John-High-Sierra/sprinkler.board/docs/superpowers/plans/2026-06-03-remote-access.md

# Remote Access Implementation Plan

> **For agentic workers:** REQUIRED SUB-SKILL: Use superpowers:subagent-driven-development (recommended) or superpowers:executing-plans to implement this plan task-by-task. Steps use checkbox (`- [ ]`) syntax for tracking.

**Goal:** Add Tailscale remote access (no firmware changes), PWA installability, and Telegram bot notifications + basic commands to the SprinKlr-8 ESP32 controller.

**Architecture:** PWA adds a manifest + service worker + icons to the existing web UI; the firmware gains 4 static-file routes to serve them. Telegram adds a `telegramTask` FreeRTOS task that long-polls the Telegram Bot API and a fire-and-forget `telegramNotify()` wrapper used by run tasks. Config is stored alongside existing fields in `config.json`.

**Tech Stack:** ESP32 Arduino / FreeRTOS, WebServer.h, WiFiClientSecure, HTTPClient, ArduinoJson v6, LittleFS, Telegram Bot API (HTTPS), Python + Pillow for icon generation

---

## File Map

| File | Change |
|---|---|
| `tools/gen_icons.py` | **Create** — generates icon-192.png + icon-512.png |
| `data/manifest.json` | **Create** — PWA manifest |
| `data/sw.js` | **Create** — minimal service worker |
| `data/icon-192.png` | **Create** — generated by script |
| `data/icon-512.png` | **Create** — generated by script |
| `data/index.html` | **Modify** — PWA tags, Telegram settings section, loadTelegram() |
| `sprinkler_controller.ino` | **Modify** — PWA routes, Telegram config, task, notifications |
| `html_content.h` | **Regenerate** — after each index.html change |
| `docs/tailscale-setup.md` | **Create** — step-by-step Tailscale guide |

---

## Task 1: Generate PWA Icons

**Files:**
- Create: `tools/gen_icons.py`
- Output: `esp32_firmware/sprinkler_controller/data/icon-192.png`
- Output: `esp32_firmware/sprinkler_controller/data/icon-512.png`

- [ ] **Step 1: Create tools/gen_icons.py**

```python
#!/usr/bin/env python3
"""Generate PWA icons for SprinKlr-8. Run from repo root: python tools/gen_icons.py"""
try:
    from PIL import Image, ImageDraw
except ImportError:
    print("Run: pip install Pillow")
    raise SystemExit(1)

import math, os

OUT_DIR = os.path.join("esp32_firmware", "sprinkler_controller", "data")
TEAL    = (13, 148, 136, 255)   # #0d9488
WHITE   = (255, 255, 255, 255)

def teardrop(cx, cy, rx, ry):
    """Polygon points: teardrop with tip at top, round base at bottom."""
    pts = []
    for i in range(31):                              # bottom arc, left to right
        a = math.pi + math.pi * i / 30
        pts.append((cx + rx * math.cos(a),
                    cy + ry * 0.3 + ry * 0.7 * math.sin(a)))
    pts.append((cx, cy - ry * 0.7))                 # tip
    return pts

def make_icon(size):
    img  = Image.new("RGBA", (size, size), (0, 0, 0, 0))
    draw = ImageDraw.Draw(img)
    m    = max(1, size // 12)
    draw.ellipse([m, m, size - m, size - m], fill=TEAL)
    draw.polygon(teardrop(size / 2, size * 0.54,
                          size * 0.22, size * 0.30), fill=WHITE)
    return img

os.makedirs(OUT_DIR, exist_ok=True)
for sz in (192, 512):
    path = os.path.join(OUT_DIR, f"icon-{sz}.png")
    make_icon(sz).save(path, "PNG")
    print(f"  Wrote {path}")
print("Done.")
```

- [ ] **Step 2: Run the script from repo root**

```powershell
pip install Pillow
python tools/gen_icons.py
```

Expected output:
```
  Wrote esp32_firmware\sprinkler_controller\data\icon-192.png
  Wrote esp32_firmware\sprinkler_controller\data\icon-512.png
Done.
```

- [ ] **Step 3: Verify both files exist**

```powershell
dir esp32_firmware\sprinkler_controller\data\icon-*.png
```

Expected: two files, each a few KB.

- [ ] **Step 4: Commit**

```powershell
git add tools/gen_icons.py esp32_firmware/sprinkler_controller/data/icon-192.png esp32_firmware/sprinkler_controller/data/icon-512.png
git commit -m "Add PWA icon generator script and generated icons"
```

---

## Task 2: Create PWA Manifest and Service Worker

**Files:**
- Create: `esp32_firmware/sprinkler_controller/data/manifest.json`
- Create: `esp32_firmware/sprinkler_controller/data/sw.js`

- [ ] **Step 1: Create data/manifest.json**

```json
{
  "name": "SprinKlr-8",
  "short_name": "SprinKlr",
  "start_url": "/",
  "display": "standalone",
  "background_color": "#0f1923",
  "theme_color": "#0d9488",
  "icons": [
    { "src": "/icon-192.png", "sizes": "192x192", "type": "image/png" },
    { "src": "/icon-512.png", "sizes": "512x512", "type": "image/png" }
  ]
}
```

- [ ] **Step 2: Create data/sw.js**

```javascript
self.addEventListener('install', () => self.skipWaiting());
self.addEventListener('activate', e => e.waitUntil(clients.claim()));
self.addEventListener('fetch', e => {
  if (e.request.mode === 'navigate') {
    e.respondWith(
      fetch(e.request).catch(() => new Response(
        '<!DOCTYPE html><html><body style="font-family:sans-serif;background:#0f1923;color:#e2e8f0;display:flex;align-items:center;justify-content:center;min-height:100vh;margin:0"><div style="text-align:center;padding:24px"><div style="font-size:3rem;margin-bottom:16px">💧</div><h2 style="color:#0d9488;margin-bottom:8px">Board Unreachable</h2><p style="color:#607080;margin-bottom:20px">Connect via Tailscale or your home network.</p><button onclick="location.reload()" style="padding:12px 24px;background:#0d9488;color:#fff;border:none;border-radius:8px;cursor:pointer;font-size:1rem">Retry</button></div></body></html>',
        { headers: { 'Content-Type': 'text/html' } }
      ))
    );
  }
});
```

- [ ] **Step 3: Commit**

```powershell
git add esp32_firmware/sprinkler_controller/data/manifest.json esp32_firmware/sprinkler_controller/data/sw.js
git commit -m "Add PWA manifest and service worker"
```

---

## Task 3: Add PWA Tags to index.html + Firmware Routes

**Files:**
- Modify: `esp32_firmware/sprinkler_controller/data/index.html`
- Modify: `esp32_firmware/sprinkler_controller/sprinkler_controller.ino`
- Regenerate: `esp32_firmware/sprinkler_controller/html_content.h`

- [ ] **Step 1: Add PWA meta tags to index.html `<head>`**

In `data/index.html`, find this line (line 6):
```html
<title>SprinKlr-8</title>
```

Replace with:
```html
<title>SprinKlr-8</title>
<link rel="manifest" href="/manifest.json">
<meta name="theme-color" content="#0d9488">
<meta name="apple-mobile-web-app-capable" content="yes">
<meta name="apple-mobile-web-app-status-bar-style" content="black-translucent">
<meta name="apple-mobile-web-app-title" content="SprinKlr">
<link rel="apple-touch-icon" href="/icon-192.png">
```

- [ ] **Step 2: Add service worker registration before `</body>`**

Find `</body>` at the very end of `data/index.html` and replace it with:
```html
<script>if('serviceWorker'in navigator)navigator.serviceWorker.register('/sw.js');</script>
</body>
```

- [ ] **Step 3: Add 4 static-file routes in sprinkler_controller.ino**

Find this block in `setupRoutes()` (just before the 404 handler at line ~1168):
```cpp
  // ── 404 handler ───────────────────────────────────────────────
  server.onNotFound([]() {
    server.send(404, "application/json", "{\"error\":\"Not found\"}");
  });
```

Insert the 4 routes immediately before the `// ── 404 handler` comment:
```cpp
  // ── PWA static files ──────────────────────────────────────────
  server.on("/manifest.json", HTTP_GET, []() { serveFile("/manifest.json", "application/manifest+json"); });
  server.on("/sw.js",         HTTP_GET, []() { serveFile("/sw.js",         "application/javascript"); });
  server.on("/icon-192.png",  HTTP_GET, []() { serveFile("/icon-192.png",  "image/png"); });
  server.on("/icon-512.png",  HTTP_GET, []() { serveFile("/icon-512.png",  "image/png"); });

```

- [ ] **Step 4: Regenerate html_content.h**

Run from repo root:
```powershell
python -c "
with open('esp32_firmware/sprinkler_controller/data/index.html', 'r', encoding='utf-8') as f:
    content = f.read()
out = '// Auto-generated — do not edit. Rebuild from data/index.html\n'
out += 'static const char INDEX_HTML[] PROGMEM = R\"====(\n'
out += content
out += '\n)====\" ;\n'.replace(' ', '')
with open('esp32_firmware/sprinkler_controller/html_content.h', 'w', encoding='utf-8') as f:
    f.write(out)
print('Done')
"
```

- [ ] **Step 5: Compile in Arduino IDE — verify no errors**

Board: ESP32 Dev Module, Partition: Minimal SPIFFS (1.9MB APP with OTA/190KB SPIFFS)

- [ ] **Step 6: Flash firmware + LittleFS**

Flash firmware via Arduino IDE OTA or USB.

Build and flash LittleFS (run from repo root):
```powershell
C:\Users\harri\AppData\Local\Arduino15\packages\esp32\tools\mklittlefs\4.0.2-db0513a\mklittlefs.exe -c "esp32_firmware\sprinkler_controller\data" -s 1507328 -b 4096 -p 256 "docs\littlefs.bin"
```
Then upload `docs/littlefs.bin` via `http://sprinkler.local/` using the web flash tool at https://john-high-sierra.github.io/sprinkler.board/

- [ ] **Step 7: Test PWA install**

- Open `http://10.110.201.40` in Chrome on Android → tap ⋮ → "Add to Home screen"
- Open `http://10.110.201.40` in Safari on iOS → tap Share → "Add to Home Screen"
- Verify: icon appears on homescreen, opens full-screen with teal status bar, no browser chrome

- [ ] **Step 8: Commit**

```powershell
git add esp32_firmware/sprinkler_controller/data/index.html esp32_firmware/sprinkler_controller/sprinkler_controller.ino esp32_firmware/sprinkler_controller/html_content.h
git commit -m "PWA: manifest, service worker, meta tags, firmware routes"
```

---

## Task 4: Add Telegram Config to BoardConfig and Persistence

**Files:**
- Modify: `esp32_firmware/sprinkler_controller/sprinkler_controller.ino`

- [ ] **Step 1: Add 3 fields to BoardConfig struct**

Find the `BoardConfig` struct (lines 142-153). Replace:
```cpp
  char zoneNames[8][32];     // user-defined zone names
};
```
With:
```cpp
  char zoneNames[8][32];     // user-defined zone names
  bool telegramEnabled;
  char telegramToken[128];   // bot token from @BotFather
  char telegramChatId[32];   // authorized chat ID — all others ignored
};
```

- [ ] **Step 2: Add defaults in loadConfig()**

Find these lines in `loadConfig()` (after `strlcpy(boardConfig.tempUnit, "C"...)` and before `if (!LittleFS.exists...)`):
```cpp
  for (int i = 0; i < 8; i++) {
    snprintf(boardConfig.zoneNames[i], sizeof(boardConfig.zoneNames[i]), "Zone %d", i + 1);
  }
```

Replace with:
```cpp
  for (int i = 0; i < 8; i++) {
    snprintf(boardConfig.zoneNames[i], sizeof(boardConfig.zoneNames[i]), "Zone %d", i + 1);
  }
  boardConfig.telegramEnabled = false;
  memset(boardConfig.telegramToken,  0, sizeof(boardConfig.telegramToken));
  memset(boardConfig.telegramChatId, 0, sizeof(boardConfig.telegramChatId));
```

- [ ] **Step 3: Bump DynamicJsonDocument size in loadConfig() from 1024 to 2048**

Find in `loadConfig()`:
```cpp
  DynamicJsonDocument doc(1024);
```
Replace with:
```cpp
  DynamicJsonDocument doc(2048);
```

- [ ] **Step 4: Add JSON read for Telegram fields in loadConfig()**

Find these lines near the end of `loadConfig()`:
```cpp
  if (doc.containsKey("zone_names")) {
    JsonArray zn = doc["zone_names"].as<JsonArray>();
    for (int i = 0; i < 8 && i < (int)zn.size(); i++) {
      const char* n = zn[i];
      if (n) strlcpy(boardConfig.zoneNames[i], n, sizeof(boardConfig.zoneNames[i]));
    }
  }
  Serial.printf("[CFG] Timezone: %s  Lat: %.4f  Lon: %.4f  WeatherSkip: %s\n",
```

Replace with:
```cpp
  if (doc.containsKey("zone_names")) {
    JsonArray zn = doc["zone_names"].as<JsonArray>();
    for (int i = 0; i < 8 && i < (int)zn.size(); i++) {
      const char* n = zn[i];
      if (n) strlcpy(boardConfig.zoneNames[i], n, sizeof(boardConfig.zoneNames[i]));
    }
  }
  boardConfig.telegramEnabled = doc["telegram_enabled"] | false;
  { const char* v = doc["telegram_token"]  | ""; strlcpy(boardConfig.telegramToken,  v, sizeof(boardConfig.telegramToken)); }
  { const char* v = doc["telegram_chat_id"]| ""; strlcpy(boardConfig.telegramChatId, v, sizeof(boardConfig.telegramChatId)); }
  Serial.printf("[CFG] Timezone: %s  Lat: %.4f  Lon: %.4f  WeatherSkip: %s\n",
```

- [ ] **Step 5: Bump DynamicJsonDocument in saveConfig() from 1024 to 2048 and add fields**

Find in `saveConfig()`:
```cpp
  DynamicJsonDocument doc(1024);
  doc["timezone"]             = boardConfig.timezone;
```
Replace with:
```cpp
  DynamicJsonDocument doc(2048);
  doc["timezone"]             = boardConfig.timezone;
```

Find the end of `saveConfig()`:
```cpp
  JsonArray zn = doc.createNestedArray("zone_names");
  for (int i = 0; i < 8; i++) zn.add(boardConfig.zoneNames[i]);
  File f = LittleFS.open(CONFIG_FILE, "w");
```
Replace with:
```cpp
  JsonArray zn = doc.createNestedArray("zone_names");
  for (int i = 0; i < 8; i++) zn.add(boardConfig.zoneNames[i]);
  doc["telegram_enabled"]  = boardConfig.telegramEnabled;
  doc["telegram_token"]    = boardConfig.telegramToken;
  doc["telegram_chat_id"]  = boardConfig.telegramChatId;
  File f = LittleFS.open(CONFIG_FILE, "w");
```

- [ ] **Step 6: Bump DynamicJsonDocument in GET /api/config from 1024 to 2048 and add fields**

Find in `GET /api/config` handler:
```cpp
    DynamicJsonDocument doc(1024);
    doc["timezone"]               = boardConfig.timezone;
```
Replace with:
```cpp
    DynamicJsonDocument doc(2048);
    doc["timezone"]               = boardConfig.timezone;
```

Find the end of the GET /api/config response building:
```cpp
    { JsonArray zn = doc.createNestedArray("zone_names"); for (int i = 0; i < 8; i++) zn.add(boardConfig.zoneNames[i]); }
    String out; serializeJson(doc, out);
    server.send(200, "application/json", out);
```
Replace with:
```cpp
    { JsonArray zn = doc.createNestedArray("zone_names"); for (int i = 0; i < 8; i++) zn.add(boardConfig.zoneNames[i]); }
    doc["telegram_enabled"]  = boardConfig.telegramEnabled;
    doc["telegram_token"]    = boardConfig.telegramToken;
    doc["telegram_chat_id"]  = boardConfig.telegramChatId;
    String out; serializeJson(doc, out);
    server.send(200, "application/json", out);
```

- [ ] **Step 7: Bump DynamicJsonDocument in POST /api/config from 1024 to 2048 and add handlers**

Find in `POST /api/config` handler:
```cpp
    DynamicJsonDocument doc(1024);
    if (deserializeJson(doc, server.arg("plain")) != DeserializationError::Ok) {
```
Replace with:
```cpp
    DynamicJsonDocument doc(2048);
    if (deserializeJson(doc, server.arg("plain")) != DeserializationError::Ok) {
```

Find the end of POST /api/config field handlers (just before the `locationChanged` line):
```cpp
    if (doc.containsKey("zone_names")) {
      JsonArray zn = doc["zone_names"].as<JsonArray>();
      for (int i = 0; i < 8 && i < (int)zn.size(); i++) {
        const char* n = zn[i].as<const char*>();
        if (n) strlcpy(boardConfig.zoneNames[i], n, sizeof(boardConfig.zoneNames[i]));
      }
    }
    // Notify weatherTask to refetch immediately when location or skip toggle changes
```
Replace with:
```cpp
    if (doc.containsKey("zone_names")) {
      JsonArray zn = doc["zone_names"].as<JsonArray>();
      for (int i = 0; i < 8 && i < (int)zn.size(); i++) {
        const char* n = zn[i].as<const char*>();
        if (n) strlcpy(boardConfig.zoneNames[i], n, sizeof(boardConfig.zoneNames[i]));
      }
    }
    if (doc.containsKey("telegram_enabled")) boardConfig.telegramEnabled = doc["telegram_enabled"].as<bool>();
    if (doc.containsKey("telegram_token")) {
      const char* v = doc["telegram_token"].as<const char*>();
      if (v) strlcpy(boardConfig.telegramToken, v, sizeof(boardConfig.telegramToken));
    }
    if (doc.containsKey("telegram_chat_id")) {
      const char* v = doc["telegram_chat_id"].as<const char*>();
      if (v) strlcpy(boardConfig.telegramChatId, v, sizeof(boardConfig.telegramChatId));
    }
    // Notify weatherTask to refetch immediately when location or skip toggle changes
```

- [ ] **Step 8: Compile in Arduino IDE — verify no errors**

- [ ] **Step 9: Commit**

```powershell
git add esp32_firmware/sprinkler_controller/sprinkler_controller.ino
git commit -m "Add Telegram config fields to BoardConfig, loadConfig, saveConfig, API endpoints"
```

---

## Task 5: Add telegramSend(), telegramNotify(), Notifications, and Test Route

**Files:**
- Modify: `esp32_firmware/sprinkler_controller/sprinkler_controller.ino`

- [ ] **Step 1: Add global skipNextScheduledRun flag and telegramTaskHandle**

Find this line near the top of the globals section (near `stopRequested`):
```cpp
volatile bool     stopRequested = false;
```
Replace with:
```cpp
volatile bool     stopRequested = false;
volatile bool     skipNextScheduledRun = false;
TaskHandle_t      telegramTaskHandle = NULL;
```

- [ ] **Step 2: Add telegramSend(), telegramNotifyTask(), and telegramNotify() functions**

Add these three functions immediately after the `serveFile()` helper (after line ~875, before `setupRoutes()`):

```cpp
// ═══════════════════════════════════════════════════════════════
//  TELEGRAM NOTIFICATIONS
// ═══════════════════════════════════════════════════════════════
void telegramSend(const char* text) {
  if (strlen(boardConfig.telegramToken) == 0 || strlen(boardConfig.telegramChatId) == 0) return;
  WiFiClientSecure client;
  client.setInsecure();
  HTTPClient https;
  char url[196];
  snprintf(url, sizeof(url), "https://api.telegram.org/bot%s/sendMessage",
    boardConfig.telegramToken);
  if (!https.begin(client, url)) return;
  https.addHeader("Content-Type", "application/json");
  DynamicJsonDocument body(512);
  body["chat_id"] = boardConfig.telegramChatId;
  body["text"]    = text;
  String bodyStr;
  serializeJson(body, bodyStr);
  https.POST(bodyStr);
  https.end();
}

// One-shot task wrapper — lets run tasks notify without blocking
void telegramNotifyTask(void* param) {
  char* msg = (char*)param;
  telegramSend(msg);
  free(msg);
  vTaskDelete(NULL);
}

void telegramNotify(const char* msg) {
  if (!boardConfig.telegramEnabled || strlen(boardConfig.telegramToken) == 0) return;
  char* buf = (char*)malloc(strlen(msg) + 1);
  if (!buf) return;
  strcpy(buf, msg);
  if (xTaskCreate(telegramNotifyTask, "tg_ntfy", 8192, buf, 1, NULL) != pdPASS) {
    free(buf);
  }
}
```

- [ ] **Step 3: Wire run-started notification into runSequenceTask()**

In `runSequenceTask()`, find:
```cpp
  stopRequested = false;
  int actualSecs[NUM_ZONES] = {0};
```
Replace with:
```cpp
  stopRequested = false;
  int actualSecs[NUM_ZONES] = {0};
  {
    int totalMin = 0, zoneCount = 0;
    xSemaphoreTake(scheduleMutex, portMAX_DELAY);
    for (int z = 0; z < NUM_ZONES; z++) {
      if (schedule.days[dayIndex].durations[z] > 0) {
        totalMin += schedule.days[dayIndex].durations[z];
        zoneCount++;
      }
    }
    xSemaphoreGive(scheduleMutex);
    char buf[128];
    snprintf(buf, sizeof(buf), "\xF0\x9F\x92\xA7 %s run started \xe2\x80\x94 %d zone%s, ~%d min",
      manual ? "Manual" : "Scheduled", zoneCount, zoneCount == 1 ? "" : "s", totalMin);
    telegramNotify(buf);
  }
```

- [ ] **Step 4: Wire run-complete notification into runSequenceTask()**

In `runSequenceTask()`, find:
```cpp
    appendRunLog(ts, manual ? "manual" : "schedule", logZ, logS, logCount, nullptr);
  }
  vTaskDelete(NULL);
```
Replace with:
```cpp
    appendRunLog(ts, manual ? "manual" : "schedule", logZ, logS, logCount, nullptr);
    {
      char buf[384];
      int pos = snprintf(buf, sizeof(buf), "\xe2\x9c\x85 Run complete");
      int totalSec = 0;
      for (int i = 0; i < logCount; i++) {
        pos += snprintf(buf + pos, sizeof(buf) - pos, "\n%s \xe2\x80\x94 %dm",
          boardConfig.zoneNames[logZ[i]], logS[i] / 60);
        totalSec += logS[i];
      }
      snprintf(buf + pos, sizeof(buf) - pos, "\nTotal: %dm", totalSec / 60);
      telegramNotify(buf);
    }
  }
  vTaskDelete(NULL);
```

- [ ] **Step 5: Wire run-started and run-complete notifications into runSingleZoneTask()**

In `runSingleZoneTask()`, find:
```cpp
  stopRequested = false;
  int actualSec = 0;
```
Replace with:
```cpp
  stopRequested = false;
  int actualSec = 0;
  {
    char buf[96];
    snprintf(buf, sizeof(buf), "\xF0\x9F\x92\xA7 Manual run started \xe2\x80\x94 %s, %d min",
      boardConfig.zoneNames[z], dur);
    telegramNotify(buf);
  }
```

In `runSingleZoneTask()`, find:
```cpp
  if (actualSec > 0) {
    time_t ts = time(nullptr);
    int logZ[1] = {z}, logS[1] = {actualSec};
    appendRunLog(ts, "manual", logZ, logS, 1, nullptr);
  }
  vTaskDelete(NULL);
```
Replace with:
```cpp
  if (actualSec > 0) {
    time_t ts = time(nullptr);
    int logZ[1] = {z}, logS[1] = {actualSec};
    appendRunLog(ts, "manual", logZ, logS, 1, nullptr);
    char buf[96];
    snprintf(buf, sizeof(buf), "\xe2\x9c\x85 Manual run complete \xe2\x80\x94 %s, %dm",
      boardConfig.zoneNames[z], actualSec / 60);
    telegramNotify(buf);
  }
  vTaskDelete(NULL);
```

- [ ] **Step 6: Wire skip notification into scheduleCheckerTask()**

In `scheduleCheckerTask()`, find:
```cpp
        appendRunLog(now, "schedule", nullptr, nullptr, 0, skipReason);
      } else {
```
Replace with:
```cpp
        appendRunLog(now, "schedule", nullptr, nullptr, 0, skipReason);
        {
          char buf[128];
          snprintf(buf, sizeof(buf), "\xe2\x8f\xad Run skipped \xe2\x80\x94 %s", skipReason);
          telegramNotify(buf);
        }
      } else {
```

- [ ] **Step 7: Add POST /api/telegram_test route**

In `setupRoutes()`, add this route with the PWA routes (after icon-512 route, before the 404 handler):

```cpp
  // ── POST /api/telegram_test ───────────────────────────────────
  server.on("/api/telegram_test", HTTP_POST, []() {
    if (!boardConfig.telegramEnabled || strlen(boardConfig.telegramToken) == 0) {
      server.send(400, "application/json", "{\"error\":\"Telegram not configured\"}");
      return;
    }
    telegramSend("SprinKlr connected \xe2\x9c\x85 \xe2\x80\x94 Telegram notifications are working.");
    server.send(200, "application/json", "{\"message\":\"Test message sent\"}");
  });
```

- [ ] **Step 8: Compile — verify no errors**

- [ ] **Step 9: Commit**

```powershell
git add esp32_firmware/sprinkler_controller/sprinkler_controller.ino
git commit -m "Add telegramSend/Notify helpers, wire run and skip notifications"
```

---

## Task 6: Add Telegram Settings UI

**Files:**
- Modify: `esp32_firmware/sprinkler_controller/data/index.html`
- Regenerate: `esp32_firmware/sprinkler_controller/html_content.h`

- [ ] **Step 1: Add Telegram settings section to index.html**

Find this block in `data/index.html` (the Updates section header, around line 434):
```html
  <div class="sec-hdr"><span class="sec-title">Updates</span></div>
```

Insert the entire Telegram section immediately before it:
```html
  <div class="sec-hdr"><span class="sec-title">Telegram</span></div>
  <div class="settings-section">
    <div class="settings-row">
      <span class="settings-label">Enable Telegram</span>
      <label class="toggle"><input type="checkbox" id="tg-enable"><span class="slider"></span></label>
    </div>
    <div class="settings-row" style="flex-direction:column;align-items:flex-start;gap:8px">
      <span class="settings-label">Bot Token</span>
      <input type="password" id="tg-token" class="tz-inp" style="width:100%" placeholder="123456:ABCdef…" autocomplete="off">
    </div>
    <div class="settings-row" style="flex-direction:column;align-items:flex-start;gap:8px">
      <span class="settings-label">Chat ID</span>
      <input type="text" id="tg-chatid" class="tz-inp" style="width:100%" placeholder="123456789">
      <span style="font-size:0.82rem;color:#607080;line-height:1.4">Create a bot at @BotFather to get a token.<br>Get your chat ID by messaging @userinfobot.</span>
    </div>
    <div class="settings-row">
      <button class="save-btn" onclick="saveTelegram()">Save Telegram Settings</button>
    </div>
    <div class="settings-row">
      <button class="save-btn" style="background:#0a5c4e" onclick="testTelegram()">Send Test Message</button>
    </div>
  </div>

```

- [ ] **Step 2: Add loadTelegram(), saveTelegram(), testTelegram() to the JavaScript section**

Find this comment in `data/index.html`:
```javascript
// ── Cloud Updates ──────────────────────────────────────
```

Insert the Telegram functions immediately before it:
```javascript
// ── Telegram ───────────────────────────────────────────
async function loadTelegram() {
  try {
    const r = await GET('/api/config');
    document.getElementById('tg-enable').checked = r.telegram_enabled || false;
    document.getElementById('tg-token').value    = r.telegram_token   || '';
    document.getElementById('tg-chatid').value   = r.telegram_chat_id || '';
  } catch(e) {}
}
async function saveTelegram() {
  const r = await POST('/api/config', {
    telegram_enabled:  document.getElementById('tg-enable').checked,
    telegram_token:    document.getElementById('tg-token').value.trim(),
    telegram_chat_id:  document.getElementById('tg-chatid').value.trim()
  });
  r.message ? toast('Telegram saved ✓') : toast(r.error || 'Save failed', 'err');
}
async function testTelegram() {
  const r = await POST('/api/telegram_test');
  r.message ? toast('Test message sent ✓') : toast(r.error || 'Check token and chat ID', 'err');
}

```

- [ ] **Step 3: Add loadTelegram() to the showPage settings branch**

Find in `data/index.html`:
```javascript
  if (pg==='settings') { renderZoneNameSettings(); loadTz(); loadWeatherSettings(); loadCycleAndSoak(); pollInfo(); }
```
Replace with:
```javascript
  if (pg==='settings') { renderZoneNameSettings(); loadTz(); loadWeatherSettings(); loadCycleAndSoak(); loadTelegram(); pollInfo(); }
```

- [ ] **Step 4: Regenerate html_content.h**

```powershell
python -c "
with open('esp32_firmware/sprinkler_controller/data/index.html', 'r', encoding='utf-8') as f:
    content = f.read()
out = '// Auto-generated — do not edit. Rebuild from data/index.html\n'
out += 'static const char INDEX_HTML[] PROGMEM = R\"====(\n'
out += content
out += '\n)====\" ;\n'.replace(' ', '')
with open('esp32_firmware/sprinkler_controller/html_content.h', 'w', encoding='utf-8') as f:
    f.write(out)
print('Done')
"
```

- [ ] **Step 5: Compile — verify no errors**

- [ ] **Step 6: Flash firmware + LittleFS and test Settings UI**

Flash firmware. (LittleFS unchanged this task — no need to reflash it.)

Open Settings → scroll to Telegram section. Verify:
- Enable toggle works
- Token and Chat ID fields accept input
- "Save Telegram Settings" button calls POST /api/config
- "Send Test Message" calls POST /api/telegram_test

- [ ] **Step 7: Commit**

```powershell
git add esp32_firmware/sprinkler_controller/data/index.html esp32_firmware/sprinkler_controller/html_content.h
git commit -m "Add Telegram settings UI: enable toggle, token, chat ID, test button"
```

---

## Task 7: Implement telegramTask(), Command Handlers, and Wire Everything

**Files:**
- Modify: `esp32_firmware/sprinkler_controller/sprinkler_controller.ino`

- [ ] **Step 1: Add command handler functions before telegramTask()**

Add these five functions after `telegramNotify()` (still in the Telegram section, before `setupRoutes()`):

```cpp
void handleTelegramStatus() {
  char buf[256];
  xSemaphoreTake(weatherMutex, portMAX_DELAY);
  bool  valid = weatherCache.valid;
  float temp  = weatherCache.currentTemp;
  int   rain  = weatherCache.rainProb[0];
  xSemaphoreGive(weatherMutex);
  xSemaphoreTake(statusMutex, portMAX_DELAY);
  bool running    = runStatus.isRunning;
  int  activeZone = runStatus.activeZone;
  int  remaining  = runStatus.remainingTime;
  xSemaphoreGive(statusMutex);

  char wxLine[64] = "Weather: unavailable";
  if (valid) {
    float disp = (boardConfig.tempUnit[0] == 'F') ? temp * 9.0f / 5.0f + 32.0f : temp;
    snprintf(wxLine, sizeof(wxLine), "\xF0\x9F\xAC\xa1 %.1f\xc2\xb0%s  Rain: %d%%",
      disp, boardConfig.tempUnit, rain);
  }
  char runLine[80] = "\xe2\x9c\x85 Idle";
  if (running && activeZone >= 0 && activeZone < NUM_ZONES) {
    snprintf(runLine, sizeof(runLine), "\xF0\x9F\x92\xA7 %s running \xe2\x80\x94 %dm left",
      boardConfig.zoneNames[activeZone], remaining / 60);
  }
  snprintf(buf, sizeof(buf), "SprinKlr-8\n%s\n%s", wxLine, runLine);
  telegramSend(buf);
}

void handleTelegramRun(const char* args) {
  int zone = -1, dur = -1;
  if (sscanf(args, "%d %d", &zone, &dur) != 2 || zone < 1 || zone > NUM_ZONES || dur < 1 || dur > 120) {
    char err[80];
    snprintf(err, sizeof(err), "Usage: /run <zone> <min>  e.g. /run 3 10  (zones 1\xe2\x80\x93%d, 1\xe2\x80\x93120 min)", NUM_ZONES);
    telegramSend(err);
    return;
  }
  xSemaphoreTake(statusMutex, portMAX_DELAY);
  bool running = runStatus.isRunning;
  xSemaphoreGive(statusMutex);
  if (running) { telegramSend("A run is already in progress. Send /stop first."); return; }
  SingleZoneArgs* a = new SingleZoneArgs{zone - 1, dur};
  xTaskCreate(runSingleZoneTask, "single_zone", 4096, a, 1, NULL);
}

void handleTelegramStop() {
  xSemaphoreTake(statusMutex, portMAX_DELAY);
  bool running = runStatus.isRunning;
  xSemaphoreGive(statusMutex);
  if (!running) { telegramSend("Nothing is running."); return; }
  stopRequested = true;
  telegramSend("\xe2\x8f\xb9 Stop signal sent.");
}

void handleTelegramSkip() {
  skipNextScheduledRun = true;
  telegramSend("\xe2\x8f\xad Next scheduled run will be skipped.");
}

void handleTelegramCommand(const char* text) {
  if (strncmp(text, "/status", 7) == 0)      { handleTelegramStatus(); }
  else if (strncmp(text, "/run ", 5) == 0)   { handleTelegramRun(text + 5); }
  else if (strncmp(text, "/stop", 5) == 0)   { handleTelegramStop(); }
  else if (strncmp(text, "/skip", 5) == 0)   { handleTelegramSkip(); }
  else if (strncmp(text, "/help", 5) == 0) {
    telegramSend(
      "SprinKlr-8 Commands:\n"
      "/status \xe2\x80\x94 weather + run state\n"
      "/run <zone> <min> \xe2\x80\x94 start a zone (e.g. /run 3 10)\n"
      "/skip \xe2\x80\x94 skip next scheduled run\n"
      "/stop \xe2\x80\x94 stop current run\n"
      "/help \xe2\x80\x94 show this list"
    );
  }
  else { telegramSend("Unknown command. Send /help for the list."); }
}
```

- [ ] **Step 2: Add telegramTask() function**

Add immediately after `handleTelegramCommand()`:

```cpp
void telegramTask(void* param) {
  long lastUpdateId = -1;
  Serial.println("[TG] Telegram task started");

  while (true) {
    if (!boardConfig.telegramEnabled || strlen(boardConfig.telegramToken) == 0) {
      vTaskDelay(pdMS_TO_TICKS(5000));
      continue;
    }

    WiFiClientSecure client;
    client.setInsecure();
    HTTPClient https;
    char url[256];
    snprintf(url, sizeof(url),
      "https://api.telegram.org/bot%s/getUpdates?timeout=25&offset=%ld",
      boardConfig.telegramToken, lastUpdateId + 1);

    if (!https.begin(client, url)) {
      vTaskDelay(pdMS_TO_TICKS(5000));
      continue;
    }
    https.setTimeout(30000);
    int code = https.GET();
    if (code != 200) {
      https.end();
      Serial.printf("[TG] getUpdates HTTP %d\n", code);
      vTaskDelay(pdMS_TO_TICKS(10000));
      continue;
    }

    String body = https.getString();
    https.end();

    DynamicJsonDocument doc(4096);
    if (deserializeJson(doc, body) != DeserializationError::Ok) continue;
    if (!doc["ok"].as<bool>()) continue;

    JsonArray results = doc["result"].as<JsonArray>();
    for (JsonObject update : results) {
      lastUpdateId = update["update_id"].as<long>();
      if (!update.containsKey("message")) continue;
      JsonObject msg = update["message"].as<JsonObject>();
      String chatId = msg["chat"]["id"].as<String>();
      if (chatId != String(boardConfig.telegramChatId)) continue;  // ignore strangers
      const char* text = msg["text"] | "";
      if (strlen(text) > 0) {
        Serial.printf("[TG] cmd from %s: %s\n", chatId.c_str(), text);
        handleTelegramCommand(text);
      }
    }
  }
}
```

- [ ] **Step 3: Add skipNextScheduledRun check to scheduleCheckerTask()**

In `scheduleCheckerTask()`, find:
```cpp
      const char* skipReason = shouldSkipForWeather();
      if (skipReason) {
```
Replace with:
```cpp
      if (skipNextScheduledRun) {
        skipNextScheduledRun = false;
        Serial.println("[SCHED] Run skipped by user command");
        appendRunLog(now, "schedule", nullptr, nullptr, 0, "user skip");
        telegramNotify("\xe2\x8f\xad Scheduled run skipped by user request.");
        lastScheduledDay    = dayIndex;
        lastScheduledMinute = minute;
        continue;
      }
      const char* skipReason = shouldSkipForWeather();
      if (skipReason) {
```

- [ ] **Step 4: Start telegramTask in setup()**

Find in `setup()`:
```cpp
  xTaskCreate(scheduleCheckerTask, "sched_check", 4096, NULL, 1, NULL);
  xTaskCreate(ledTask,             "led_blink",   1024, NULL, 1, NULL);
  xTaskCreate(weatherTask,         "weather",     8192, NULL, 1, &weatherTaskHandle);
```
Replace with:
```cpp
  xTaskCreate(scheduleCheckerTask, "sched_check", 4096, NULL, 1, NULL);
  xTaskCreate(ledTask,             "led_blink",   1024, NULL, 1, NULL);
  xTaskCreate(weatherTask,         "weather",     8192, NULL, 1, &weatherTaskHandle);
  xTaskCreate(telegramTask,        "telegram",    8192, NULL, 1, &telegramTaskHandle);
```

- [ ] **Step 5: Bump FW_VERSION to 1.8.0**

Find:
```cpp
#define FW_VERSION     "1.7.0"
```
Replace with:
```cpp
#define FW_VERSION     "1.8.0"
```

- [ ] **Step 6: Compile — verify no errors, confirm sketch fits in program space**

- [ ] **Step 7: Flash firmware**

- [ ] **Step 8: Full Telegram test**

1. In Telegram: message @BotFather → `/newbot` → follow prompts → copy token
2. Message @userinfobot to get your chat ID
3. Open SprinKlr Settings → Telegram section → paste token + chat ID → Enable → Save
4. Tap "Send Test Message" → verify message arrives in Telegram
5. Send `/help` to the bot — verify command list response
6. Send `/status` — verify weather + run state reply
7. Send `/run 1 1` — verify Zone 1 starts for 1 minute, then completes
8. Send `/stop` during a run — verify run stops
9. Verify "run started" and "run complete" Telegram messages arrive automatically

- [ ] **Step 9: Commit**

```powershell
git add esp32_firmware/sprinkler_controller/sprinkler_controller.ino
git commit -m "v1.8.0: Add telegramTask with commands and notifications"
```

---

## Task 8: Tailscale Setup Guide

**Files:**
- Create: `docs/tailscale-setup.md`

- [ ] **Step 1: Write docs/tailscale-setup.md**

```markdown
# Tailscale Remote Access Setup

Access your SprinKlr-8 from anywhere — same web UI, no firmware changes.

## How it works

The ESP32 cannot run a Tailscale client. Your Windows PC acts as a **subnet router**:
it runs Tailscale and advertises your home network so your phone can reach the board
through the encrypted WireGuard tunnel.

## Setup (about 10 minutes)

### 1. Install Tailscale on your Windows PC

Download and install from https://tailscale.com/download

Set it to start automatically (the installer does this by default).

### 2. Enable subnet routing on the PC

Open a command prompt and run:
```
tailscale up --advertise-routes=10.110.201.0/24 --accept-routes
```

Replace `10.110.201.0/24` with your home subnet if different.

### 3. Approve the subnet in the Tailscale admin console

- Open https://login.tailscale.com/admin/machines
- Find your Windows PC in the list
- Click the `…` menu → **Edit route settings**
- Enable the advertised subnet route
- Click Save

### 4. Install Tailscale on your phone

- iOS: App Store → Tailscale
- Android: Play Store → Tailscale

Log into the same Tailscale account as your PC.

### 5. Done

With Tailscale running on your phone, open:

```
http://10.110.201.40
```

The SprinKlr-8 dashboard loads exactly as it does at home.

## Tips

- **Local access unchanged** — `http://sprinkler.local` and `http://10.110.201.40` still
  work on your home network without Tailscale.
- **Tailscale must be connected on both devices** — toggle it on before opening the app.
- **PC must be on** — if the PC is off, the subnet is unreachable. Keep it in sleep mode
  rather than fully powered off, or use a NAS/Raspberry Pi as a permanent subnet router.
- **PWA** — once the board is accessible remotely, install the web UI as an app:
  - Android: Chrome → ⋮ → Add to Home screen
  - iOS: Safari → Share → Add to Home Screen
```

- [ ] **Step 2: Commit**

```powershell
git add docs/tailscale-setup.md
git commit -m "Add Tailscale remote access setup guide"
```

---

## Self-Review

**Spec coverage check:**
- ✅ Tailscale: covered in Task 8 (guide) + no firmware changes needed
- ✅ PWA manifest + icons: Tasks 1-3
- ✅ PWA firmware routes: Task 3
- ✅ Telegram config in BoardConfig: Task 4
- ✅ Telegram Settings UI: Task 6
- ✅ telegramSend + notifications: Task 5
- ✅ telegramTask + commands: Task 7
- ✅ /status /run /skip /stop /help commands: Task 7
- ✅ Security (chat_id check): Task 7
- ✅ skipNextScheduledRun wired: Task 7
- ✅ FW_VERSION bump to 1.8.0: Task 7
- ✅ DynamicJsonDocument sizes bumped from 1024 to 2048: Task 4

**Type consistency:**
- `telegramSend()` declared in Task 5, called in Tasks 5 and 7 ✅
- `telegramNotify()` declared in Task 5, called in Tasks 5 and 7 ✅
- `skipNextScheduledRun` declared in Task 5 globals, used in Tasks 5 and 7 ✅
- `telegramTaskHandle` declared in Task 5 globals, used in Task 7 ✅
- `handleTelegramCommand()` declared in Task 7, called in Task 7 ✅
- `SingleZoneArgs` used in `handleTelegramRun()` — defined in ino at line 501 ✅

**Placeholder scan:** No TBDs. All code blocks complete.
