John-High-Sierra/sprinkler.board/SprinKlr8_Design_Spec.docx

SprinKlr-8

ESP32 8-Zone Sprinkler Controller

Design & Manufacturing Specification | v1.1 | April 2026

Parameter | Value
Target Board | SprinKlr-8 -- Custom ESP32-WROOM-32E, 8-ch SPST relay, USB-C, SMD
MCU | Espressif ESP32-WROOM-32E-N4 (4MB Flash, 520KB SRAM, 2.4GHz WiFi + BT)
Relay Type | 8x SPST-NO SMD, 5V coil, 5A @ 250VAC contacts (HF46F-G/5-HS1 / LCSC C165255)
Power Input | 24VAC field supply -> bridge rectifier -> LM2596S-5.0 -> 5V DC USB-C (5V) also accepted simultaneously -- Schottky diode prevents back-feed to host
Programming | USB-C -> CH340C onboard UART bridge, no external adapter needed
Target Volume | 1,000 units | JLCPCB PCBA + LCSC component sourcing
Est. Unit Cost | ~$8.10 fully assembled at 1,000 units (BOM + PCB + assembly)
PCB Size | ~90mm x 65mm (2-layer, ENIG or HASL finish)

# 1. Executive Summary

This document specifies the design and production plan for SprinKlr-8: a compact, low-cost ESP32-based irrigation controller with 8 independently switched zones. Optimized for volume production at JLCPCB using all-SMD components sourced through LCSC. v1.1 revises the power architecture (24VAC field supply with safe simultaneous USB-C support), consolidates field wiring to a single terminal strip, and adds a replaceable glass fuse.

Key improvements over the reference design (ACEIRMC B0DTK2PB26):

- USB-C port integrated on-board -- no external programmer required
- SPST-NO relays replace SPDT -- reduces per-relay cost and PCB footprint by ~20%
- Compact 90x65mm form factor vs. 131x82mm reference board
- Identical firmware pinout -- existing sprinkler_controller.ino runs without modification
- 9x LED zone/power indicators for field diagnostics
- 24VAC powered from irrigation transformer -- no separate USB supply needed in the field
- Single 11-pin terminal strip -- one connector for all field connections
- Replaceable 5x20mm glass fuse -- field-serviceable over-current protection
- Safe dual-supply design -- USB-C and 24VAC may be connected simultaneously without risk to host computer

# 2. Board Design Overview

## 2.1 Power Architecture

The board supports two power sources that may be connected simultaneously without risk of damage to either the board or the USB host computer. A Schottky diode on the USB 5V input prevents back-feed from the onboard regulator into the USB host when 24VAC is the active supply.

Power chain -- 24VAC field supply:

- 24VAC (16-28VAC) -> MB10F bridge rectifier -> ~33V DC peak
- -> 470uF 50V bulk capacitor (smoothing)
- -> LM2596S-5.0 buck regulator (fixed 5V, up to 3A) + 100uH inductor + 1N5819 catch diode + 220uF output cap
- -> 5V rail -> relay coils (via ULN2803A) and AMS1117-3.3 LDO -> 3.3V for ESP32

Power chain -- USB-C:

- USB 5V -> SS14 Schottky diode (SOD-123, ~0.3V drop) -> 5V rail
- Diode blocks reverse current -- LM2596S-5.0 output cannot back-feed into the USB host
- On USB only: ~4.6-4.7V on rail -- sufficient for ESP32 (3.3V via LDO) and relay coils

Priority behaviour:

- When 24VAC connected: LM2596S-5.0 holds rail at 5.0V; Schottky diode reverse-biased -- USB host sees no load from board supply
- When USB only: Schottky diode forward-biased; board runs at ~4.6V -- fully functional
- Both connected: 24VAC supply dominates; USB contributes nothing; host computer is fully protected

Note: LM2596S-5.0 input range is 7-40V. Rectified 24VAC peak (~33.9V) is well within spec. Input fuse: 1A slow-blow 5x20mm glass fuse in a PCB-mount holder protects against wiring faults.

## 2.2 Relay Architecture

Each of the 8 zones is controlled by one SPST-NO (normally open) SMD relay. The ULN2803A Darlington array drives all 8 relay coils from a single SO-18 IC, with integrated flyback diodes protecting the ESP32 GPIOs -- no discrete diodes required.

- Saves ~$0.05-0.08 per relay at volume vs. SPDT equivalents
- Relay contacts switch the 24VAC valve supply -- the only 24VAC path beyond the power input terminals
- VALVE_COM terminal connects the 24VAC common to all valve solenoids through the relay contacts

## 2.3 Terminal Wiring

All field connections are made through a single 11-pin 5.08mm pitch screw terminal strip:

Pin | Net | Description
1 | AC_LINE | 24VAC Line from transformer secondary
2 | AC_NEUTRAL | 24VAC Neutral from transformer secondary
3 | VALVE_COM | 24VAC Common -- connects to common wire of all valve solenoids
4 | ZONE1 | Zone 1 output (relay NO contact)
5 | ZONE2 | Zone 2 output
6 | ZONE3 | Zone 3 output
7 | ZONE4 | Zone 4 output
8 | ZONE5 | Zone 5 output
9 | ZONE6 | Zone 6 output
10 | ZONE7 | Zone 7 output
11 | ZONE8 | Zone 8 output

Field wiring: transformer secondary to Pins 1-2; common valve wire to Pin 3 (VALVE_COM); individual valve hot wires to Pins 4-11. Matches wiring convention of all major commercial controllers.

## 2.4 USB-C & Programming

The CH340C USB-UART bridge connects the USB-C port to the ESP32 UART0. Arduino IDE-compatible flashing without external hardware. Boot mode: hold BOOT, tap RESET. USB-C can remain connected while the board is powered from 24VAC -- the Schottky diode ensures the host computer is fully protected.

Note: The ESP32-WROOM-32E is a pre-certified FCC/CE module (FCC ID: 2AC7Z-ESPWROOM32), qualifying the product for a Supplier's Declaration of Conformity (SDoC) rather than full radio testing.

## 2.5 Zone Indicators

Each zone has a dedicated 0402 green LED (D1-D8) between 3.3V and the GPIO through a 470-ohm resistor. A red power LED (D9) with 1k-ohm resistor indicates the board is energised from either supply source.

## 2.6 GPIO Map (identical to firmware)

Zone | GPIO
Zone 1 | GPIO 32
Zone 2 | GPIO 33
Zone 3 | GPIO 25
Zone 4 | GPIO 26
Zone 5 | GPIO 27
Zone 6 | GPIO 14
Zone 7 | GPIO 12
Zone 8 | GPIO 13

Note: GPIO12 is an ESP32 strapping pin. Firmware initialises it LOW before WiFi starts -- already implemented in sprinkler_controller.ino.

# 3. Bill of Materials

Complete component list. All parts available through LCSC Electronics via the JLCPCB component library. Part numbers current as of April 2026 -- verify availability at time of order.

Ref | Description | LCSC # | Qty | x1 | x100 | x1,000 | Notes
U1 | ESP32-WROOM-32E-N4 (4MB) | C701341 | 1 | $4.50 | $3.20 | $2.60 | MCU + WiFi/BT -- FCC/CE pre-certified
U2 | CH340C USB-UART, SO-16 | C84681 | 1 | $0.55 | $0.28 | $0.20 | USB-C programming bridge
U3 | ULN2803ADWR Darlington SO-18 | C5840 | 1 | $0.35 | $0.18 | $0.12 | Relay driver, includes flyback diodes
U4 | AMS1117-3.3 LDO SOT-223 | C6186 | 1 | $0.18 | $0.10 | $0.08 | 3.3V rail for ESP32
U5 | LM2596S-5.0 Buck Reg TO-263-5 | C347421 | 1 | $0.45 | $0.25 | $0.18 | Fixed 5V up to 3A -- 24VAC to 5V
D10 | MB10F Bridge Rectifier SOP-4 | C2491 | 1 | $0.15 | $0.08 | $0.06 | 24VAC to DC rectification
D11 | 1N5819 Buck Catch Diode SOD-123 | C191023 | 1 | $0.05 | $0.03 | $0.02 | LM2596S-5.0 catch diode
D12 | SS14 Schottky USB Input SOD-123 | C2480 | 1 | $0.05 | $0.03 | $0.02 | USB 5V to 5V rail; blocks back-feed to host
T1, T2 | MMBT3904 NPN SOT-23 | C20526 | 2 | $0.05 | $0.03 | $0.02 | Auto-reset circuit -- allows IDE to flash without pressing buttons
K1-K8 | SPST-NO Relay 5V 5A HF46F-G | C165255 | 8 | $0.55 | $0.22 | $0.16 | 5A@250VAC, SMD gull-wing
J1 | USB-C 16-pin SMD Receptacle | C165948 | 1 | $0.25 | $0.12 | $0.08 | Programming + bench power (via D12 Schottky)
J2 | 11-pin 5.08mm Screw Terminal | C2915640/C5143711 | 1 | $0.65 | $0.38 | $0.28 | AC_LINE/NEUTRAL, VALVE_COM, ZONE1-8
F1 | PCB-mount 5x20mm Fuse Holder | C3131 | 1 | $0.35 | $0.18 | $0.12 | Install 1A slow-blow glass fuse
L1 | 100uH SMD Inductor | C2929505 | 1 | $0.28 | $0.14 | $0.10 | LM2596S-5.0 output filter -- required
C1 | 470uF 50V SMD Aluminum Electrolytic 10x10.5mm Radial | C90272 | 1 | $0.35 | $0.18 | $0.12 | Rectifier bulk cap -- 50V rating required
C2 | 220uF 25V SMD Aluminum Electrolytic 6.3x7.7mm SMD | C2992606 | 1 | $0.18 | $0.08 | $0.06 | Buck output filter cap
C3-C6 | 100nF 0402 MLCC x4 | C1525 | 4 | $0.02 | $0.01 | $0.01 | IC decoupling caps
R1-R8 | 1k-ohm 0402 x8 | C11702 | 8 | $0.01 | $0.005 | $0.003 | Relay GPIO drive resistors
R9-R16 | 470-ohm 0402 x8 | C23190 | 8 | $0.01 | $0.005 | $0.003 | Zone LED current resistors
R17-R21 | 10k-ohm 0402 x5 | C25804 | 5 | $0.01 | $0.005 | $0.003 | EN/BOOT pull-ups, GPIO12 pull-down, DTR/RTS base resistors
R22-R23 | 5.1k-ohm 0402 x2 | C27864 | 2 | $0.01 | $0.005 | $0.003 | USB-C CC1 and CC2 resistors (mandatory for USB-C detection)
R24 | 1k-ohm 0402 x1 | C11702 | 1 | $0.01 | $0.005 | $0.003 | Power LED (D9) current resistor
D1-D8 | LED 0402 green x8 | C72043 | 8 | $0.05 | $0.025 | $0.018 | Zone active indicators
D9 | LED 0402 red | C84256 | 1 | $0.05 | $0.025 | $0.018 | Power-on indicator
SW1 | BOOT tactile switch SMD | C318884 | 1 | $0.08 | $0.04 | $0.03 | Enter flash mode
SW2 | EN/RESET tactile switch SMD | C318884 | 1 | $0.08 | $0.04 | $0.03 | Reset ESP32
-- | PCB (2-layer ~90x65mm) | JLCPCB | 1 | $2.00 | $0.80 | $0.45 | 2-layer, HASL or ENIG finish
-- | SMT Assembly | JLCPCB | 1 | $8.00 | $3.50 | $2.00 | JLCPCB Economic SMT
TOTAL | All components + PCB + assembly | | | ~$19.90 | ~$11.00 | ~$8.10 | Estimates -- verify via JLCPCB BOM tool

Cost notes at 1,000 units:

- PCB cost assumes 2-layer, 90x65mm, HASL finish, standard lead time. ENIG adds ~$0.15/board.
- J2 (terminal strip) and F1 (fuse holder) are through-hole -- hand-solder at prototype stage.
- D12 (SS14 Schottky) adds ~$0.02/board -- protects every USB host used during development.
- T1, T2 (MMBT3904) are the auto-reset transistors that allow IDE flashing without pressing buttons.
- R17-R21 (10k) and R22-R23 (5.1k) are small passives -- cheap but essential for correct ESP32 boot behaviour and USB-C detection.
- LM2596S-5.0 + MB10F add ~$0.72/board vs. USB-only design but eliminate a separate 5V supply at the installation site.
- ESP32 module dominates BOM cost (~32%). No cheaper certified WiFi+BT option at this volume.

# 4. Manufacturer Comparison -- 1,000 Units

Manufacturer | Cost | Quality | Lead Time | Notes
JLCPCB + LCSC | $7-9 | 4/5 | 7-15 days | Best all-in-one workflow. Recommended.
PCBWay | $9-12 | 5/5 | 10-20 days | Higher QC. Good for low-defect production.
NextPCB | $8-11 | 4/5 | 10-18 days | Competitive pricing, less LCSC integration.
Seeed Fusion | $9-13 | 4/5 | 15-25 days | FCC/CE consultancy available.
Local (US) | $22-35 | 5/5 | 5-10 days | MacroFab, Screaming Circuits. High cost, fast.

Recommendation: JLCPCB + LCSC

JLCPCB is the clear choice for this volume. The integrated EasyEDA -> LCSC -> JLCPCB PCBA workflow dramatically reduces project management overhead at acceptable quality for a consumer product.

# 5. Design -> Manufacturing Workflow

Step 1 -- Schematic in EasyEDA

- EasyEDA Standard (free, browser-based): https://easyeda.com
- Key nets: 5V_RAIL, 3V3, GND, AC_IN_P, AC_IN_N, RELAY_K1-K8, UART_TX/RX, USB_D+/D-
- Implement LM2596S-5.0 sub-circuit per datasheet layout guidelines (keep L1 + D11 loop tight)
- Add SS14 Schottky (D12) between USB VBUS and 5V_RAIL net
- Follow ESP32-WROOM-32E reference design for RF decoupling

Step 2 -- PCB Layout

- 2-layer board target: 90mm x 65mm
- Place power supply (rectifier + buck) away from ESP32 RF area
- Fuse holder, terminal strip, and USB-C connector on PCB edges
- Keep ESP32 antenna clear of copper pour and relay fields
- Maintain >= 1.0mm creepage between AC_IN pads and low-voltage traces

Step 3 -- DFM Check

- Run JLCPCB DFM check: min trace 0.127mm, min via 0.3mm drill / 0.6mm pad
- Check courtyard clearances around relay bodies, fuse holder, terminal strip

Step 4 -- Generate Production Files

- Gerbers: JLCPCB Gerber export plugin from EasyEDA
- BOM: export with LCSC part numbers in "Supplier Part" column
- CPL: export XY coordinates + rotation from EasyEDA

Step 5 -- JLCPCB Order

- Upload Gerbers: 2-layer, 90x65mm, HASL, 1.6mm, green, qty 1,000
- Enable PCB Assembly -- upload BOM and CPL; review 3D preview before confirming
- Select Economic SMT; add AOI at $0.30/board -- strongly recommended at 1,000 units

Step 6 -- Incoming QC

- Flash 5-10 sample boards; run relay_pin_finder.ino to verify all 8 relays
- Test both power paths: 24VAC-only and USB-only; verify 5V rail on both
- Connect both simultaneously; verify USB host shows no unexpected voltage
- Measure current: ~80mA idle WiFi, ~650mA all 8 relays energised

# 6. Commercial Path -- FCC & CE Compliance

The ESP32-WROOM-32E module carries its own FCC Grant (FCC ID: 2AC7Z-ESPWROOM32) and CE marking, significantly simplifying the compliance path.

## 6.1 US Market -- FCC

Requirement | Details
FCC Part 15B | Unintentional radiator -- self-declaration via SDoC. No lab testing if module conditions met.
Module conditions | Do not modify ESP32 RF hardware or antenna. Maintain PCB antenna clearance per datasheet.
SDoC cost | ~$500-1,500 (document preparation). No lab fees. One-time.
FCC label | Display FCC ID "2AC7Z-ESPWROOM32" on PCB silkscreen and packaging.

## 6.2 EU Market -- CE

Directive | Details
RED | ESP32-WROOM-32E carries CE/RED marking. Self-declaration (DoC) possible if module conditions met.
LVD | Board logic at 5V/3.3V; 24VAC rectified peak ~33.9V DC -- both below 75VDC LVD threshold. LVD does not apply.
RoHS | JLCPCB PCBA is RoHS compliant by default. Confirm with supplier letter.
CE cost | ~$1,000-2,500 for DoC preparation and technical file.

Note: The board accepts 24VAC (~33.9V DC peak after rectification -- below both the LVD 75VDC and SELV 60VDC thresholds). Include appropriate safety notices regarding 24VAC wiring.

## 6.3 Estimated Compliance Budget

Item | Cost (one-time) | Notes
FCC SDoC preparation | $500-1,500 | Attorney or compliance consultant
CE DoC preparation | $1,000-2,500 | Technical file + DoC document
Product liability insurance | $800-2,000/yr | Required for retail/Amazon sale
Total compliance (US+EU) | ~$2,300-6,000 | At 1,000 units = $2.30-$6.00/board

# 7. Total Cost Summary -- 1,000 Units

Item | Total Cost | Per Unit
PCB + PCBA + components (1,000 units) | ~$8,100 | $8.10
FCC SDoC (estimated mid-range) | $1,000 | $1.00 amortized
CE DoC (estimated mid-range) | $1,500 | $1.50 amortized
3D printed case (PLA, in-house) | ~$3,500 | $3.50
Packaging (plain white box) | ~$800 | $0.80
Shipping from JLCPCB | ~$400 | $0.40
TOTAL (with compliance + case) | ~$15,300 | ~$15.30/unit

At a retail price of $49-69, the margin is healthy even at 1,000 units. Comparable controllers (Rachio, RainBird WiFi) retail at $80-180 for 8 zones.

# 8. Recommended Next Steps

- Immediate: Order 5 prototype boards from JLCPCB to validate design.
- Schematic: Create schematic in EasyEDA; assign all LCSC part numbers before routing PCB.
- Power test: Verify 5V rail under USB-only, 24VAC-only, and both simultaneously.
- Firmware: GPIO map is unchanged -- sprinkler_controller.ino runs without modification.
- Soak test: 48-hour soak test with real 24VAC valves; verify LM2596S-5.0 stable under full relay switching load.
- DFM: Submit Gerbers to JLCPCB DFM tool; resolve all warnings.
- FCC SDoC: Engage compliance consultant after prototype validation -- $500-1,500.
- Scale: At 5,000+ units, negotiate with Shenzhen contract manufacturer for 20-30% cost reduction.
