John-High-Sierra/sprinkler.board/ESP32_Relay_Board_Contractor_Brief.docx

ESP32 8-Channel WiFi Relay Controller

Hobby Board Project | Contractor PCB Design Brief | Rev 1.0 | May 2026

This document is a complete design brief for a custom ESP32-based printed circuit board. It is a personal hobby project. The board controls eight independent relay outputs via WiFi and includes an onboard power supply, USB-C programming interface, and indicator LEDs. All components are sourced from LCSC and the board is intended for assembly through JLCPCB PCBA service.

This brief provides everything a PCB designer needs to complete the schematic and layout: functional block descriptions, all component part numbers, GPIO assignments, PCB specifications, and layout rules. Where a design choice is not specified, prefer the most reliable and manufacturable option.

# 1. Board Overview

Attribute | Value
Microcontroller | ESP32-WROOM-32E (Xtensa dual-core 240 MHz, integrated 2.4 GHz WiFi and Bluetooth, 4 MB flash)
Relay Outputs | 8 × SPST-NO electromechanical relays, rated 5 A / 250 VAC per contact
Relay Logic | Active HIGH — relay energises when the corresponding GPIO is driven HIGH
Field Power Input | 24 VAC via 2.1 mm barrel jack (primary) OR 2-pin screw terminal (alternate); user-selectable via on-board jumper. Only one source is connected at a time.
Board Supply Rails | +5 V DC (relay coils, LED drivers) and +3.3 V DC (ESP32, logic)
USB Interface | USB Type-C, CH340C USB-to-UART bridge with auto-reset circuit
Output Indicators | 8 × red SMD LEDs (one per relay channel) + 1 × green SMD status LED
Output Protection | MOV (metal oxide varistor) across each relay output for inductive load spike clamping
PCB | 2-layer FR4, 1.6 mm, ENIG surface finish, green solder mask
Board Size (target) | Approximately 100 mm × 80 mm — adjust as needed to fit all components with required clearances
Mounting | Four M3 mounting holes at board corners for standoff mounting
User Controls | BOOT button (IO0 to GND) and RST button (EN to GND)
Target Assembly | JLCPCB PCBA — all SMD components from LCSC catalog

# 2. Circuit Block Descriptions

## 2.1 Power Supply

The board is powered from a 24 VAC input. The power supply block converts this to regulated +5 V DC and +3.3 V DC. The 24 VAC is also routed to a COM screw terminal used as the switching supply for the relay contacts — the relay contacts switch this voltage to the output terminals.

### Input Connectors

- Barrel jack: 2.1 mm centre pin, 5.5 mm outer diameter. AC input, not polarised. Primary power connector.
- Screw terminal: 2-pin, 3.5 mm pitch, labelled AC1 and AC2. Equivalent AC input for users connecting bare wire leads.
- Source selection jumper: 3-pin header, 2.54 mm pitch, labelled PWR-SEL. Pins 1–2 = barrel jack active. Pins 2–3 = screw terminal active. Never both simultaneously. Mark clearly on silkscreen.

### AC to DC Conversion

- Bridge rectifier: MB10F SMD full-wave bridge (LCSC C441951). 24 VAC in → approximately +33 V DC out. 1 A / 1000 V rated.
- Filter capacitor: 470 µF / 50 V electrolytic, placed directly at rectifier output.
- Input protection: 5 A resettable PTC polyfuse on the AC input line, before the bridge rectifier.

### +5 V Rail — LM2596S-5.0 Buck Converter

- IC: LM2596S-5.0, TO-263-5 package (LCSC C2621). Input up to 40 V, fixed 5 V output, 3 A rated. A linear regulator stepping from ~33 V to 5 V is not appropriate due to excessive heat dissipation.
- External components per datasheet: 100 µH inductor (rated 1 A+), 220 µF / 10 V output electrolytic capacitor, 1N5822 Schottky catch diode (3 A, 40 V).

### +3.3 V Rail — AMS1117-3.3 LDO

- IC: AMS1117-3.3, SOT-223 package (LCSC C6186). Powered from the +5 V rail.
- Input capacitor: 10 µF ceramic. Output capacitor: 22 µF ceramic.

## 2.2 Microcontroller — ESP32-WROOM-32E

The ESP32-WROOM-32E is a fully integrated module containing the ESP32 SoC, 4 MB flash, 40 MHz crystal, and a PCB trace antenna. It is mounted using its castellated edge pads.

- Supply: +3.3 V. Decouple with 10 µF + 100 nF ceramic capacitors at the module power pins.
- EN pin (chip enable): Pull up to 3.3 V via 10 kΩ. RST push button pulls EN to GND.
- IO0 pin (boot mode): Pull up to 3.3 V via 10 kΩ. BOOT push button pulls IO0 to GND. IO0 = LOW at reset enters UART bootloader mode for programming.
- GPIO12 strapping pin — CRITICAL: Connect a 10 kΩ resistor from GPIO12 to GND. This pin controls SDIO voltage selection at boot. If HIGH at boot, the chip may fail to start. This pull-down is mandatory and must not be omitted.
- Antenna keep-out: Maintain a copper-free zone of at least 15 mm around the on-module PCB trace antenna. No copper pours, traces, or components in this area on any layer.

### GPIO Assignments — Do Not Deviate

GPIO | Function | Direction | Notes
GPIO32 | Relay Channel 1 | Output | → ULN2803A input 1
GPIO33 | Relay Channel 2 | Output | → ULN2803A input 2
GPIO25 | Relay Channel 3 | Output | → ULN2803A input 3
GPIO26 | Relay Channel 4 | Output | → ULN2803A input 4
GPIO27 | Relay Channel 5 | Output | → ULN2803A input 5
GPIO14 | Relay Channel 6 | Output | → ULN2803A input 6
GPIO12 | Relay Channel 7 | Output | → ULN2803A input 7. Also: 10 kΩ pull-down to GND (strapping pin — mandatory)
GPIO13 | Relay Channel 8 | Output | → ULN2803A input 8
GPIO23 | Status LED | Output | Active HIGH → 330 Ω → green LED anode → cathode to GND
GPIO1 / TXD0 | UART TX | Output | → CH340C RXD pin
GPIO3 / RXD0 | UART RX | Input | ← CH340C TXD pin
GPIO0 / IO0 | Boot select | I/O | 10 kΩ pull-up to 3.3 V. BOOT button to GND. Auto-reset circuit.
EN | Chip enable/reset | Input | 10 kΩ pull-up to 3.3 V. RST button to GND. Auto-reset circuit.

## 2.3 USB-C Programming Interface — CH340C

The CH340C provides USB-to-UART conversion for firmware programming and serial monitoring. It has an internal oscillator — do not add an external crystal.

- IC: CH340C, SOP-16 package (LCSC C84681).
- USB connector: USB Type-C receptacle, 16-pin SMD (LCSC C165948).
- CC1 and CC2 pins: Each connected to GND through a 5.1 kΩ resistor. Mandatory for USB-C host compatibility.
- ESD protection: USBLC6-2SC6 SOT-23-6 TVS diode array (LCSC C2827693) between the USB-C D+/D− pins and the CH340C. Placed as close to the USB connector as possible.
- VBUS polyfuse: 500 mA resettable PTC fuse in series with the USB VBUS line (LCSC C386618).
- Decoupling: 100 nF ceramic capacitor at CH340C VCC pin.

### Auto-Reset Circuit

Two MMBT3904 NPN transistors (LCSC C20526) allow the programming tool to automatically place the ESP32 into bootloader mode without manual button pressing. This is the standard NodeMCU/DevKit-style auto-reset circuit and must be replicated exactly.

- Q1 (RTS → EN): Base connected to CH340C RTS# pin through 10 kΩ resistor. Collector connected to ESP32 EN pin. Emitter to GND. 100 nF capacitor from base to GND.
- Q2 (DTR → IO0): Base connected to CH340C DTR# pin through 10 kΩ resistor. Collector connected to ESP32 IO0 pin. Emitter to GND. 100 nF capacitor from base to GND.

## 2.4 Relay Driver and Output Block

### ULN2803A — Relay Driver IC

The ULN2803A (LCSC C56026, SOP-18) is an 8-channel Darlington transistor array. It drives the relay coils from the ESP32 GPIO outputs and contains internal flyback diodes.

- Inputs 1–8 (pins 1–8): Connected directly to ESP32 GPIO32, 33, 25, 26, 27, 14, 12, 13 respectively.
- COM pin (pin 10): MUST connect to +5 V. This is the return rail for the internal flyback diodes. Leaving it floating will damage the device.
- Collector outputs (pins 11–18): Each connected to the relay coil negative terminal. Outputs are in reverse order — OUT1 is on pin 18, OUT8 is on pin 11.
- GND (pin 9): Connect to GND.

### Relays — HF46F-G/5-HS1

- Type: SPST-NO (normally open). Contact rating: 5 A / 250 VAC.
- Coil: 5 V DC, G5NB-compatible SMD footprint.
- LCSC part number: C165255. Do not substitute — C128511 is a capacitor, not a relay.
- Coil positive terminal: +5 V. Coil negative terminal: ULN2803A collector output.
- Relay COM contact: connects to the AC_COM bus (the 24 VAC return / common screw terminal).
- Relay NO contact: connects to the corresponding zone output screw terminal.

### Zone Output Screw Terminals

- 8 × 2-pin screw terminals, 3.5 mm pitch, 10 A / 300 V rated (LCSC C8465). One per relay channel. Label CH1 through CH8 on silkscreen.
- 1 × 2-pin screw terminal (same type) for the relay COM connection. Label COM on silkscreen. This connects the external AC common to all relay contact COM pins.
- Arrange all 9 screw terminals in a row along one long edge of the board for clean wiring access.

## 2.5 Indicator LEDs

- Per-channel LEDs × 8 (red, 0805, LCSC C84256): One per relay channel. Connected between +5 V and the ULN2803A collector output for that channel via a 470 Ω series resistor (0805). LED illuminates when the relay is energised. Place adjacent to the corresponding relay.
- Status LED × 1 (green, 0805, LCSC C72043): Driven by GPIO23 through a 330 Ω series resistor to GND. Active HIGH. Indicates system state (firmware-controlled). Place near the ESP32 module, visible from outside an enclosure.

## 2.6 Output Protection — MOV Snubbers

Inductive loads generate voltage spikes when switched off. A metal oxide varistor (MOV) across each relay output clamps these spikes, protecting the relay contacts from arcing and extending their service life.

- One MOV per channel, connected across the relay NO output terminal and the COM terminal — i.e., directly across the load connection. Total: 8 MOVs.
- Rating: 47 V clamping voltage. Use TVR05470 or equivalent 5 mm disc MOV. Search LCSC for 'MOV 47V disc'.
- Note: The ULN2803A internal flyback diodes separately protect the +5 V rail from relay coil back-EMF. Both protections are present in this design.

# 3. Bill of Materials

All components are sourced from LCSC. Verify all part numbers and footprints in EasyEDA before ordering. Components marked THT are hand-assembled after SMD reflow.

Component / Description | LCSC Part | Package | Qty | Assembly | Notes
ESP32-WROOM-32E module | C701341 | Module | 1 | SMD/Reflow | 4 MB flash min.
CH340C USB-UART | C84681 | SOP-16 | 1 | SMD/Reflow | Internal osc. — no crystal
AMS1117-3.3 LDO | C6186 | SOT-223 | 1 | SMD/Reflow | 3.3 V, 1 A
LM2596S-5.0 Buck Converter | C2621 | TO-263-5 | 1 | SMD/Reflow | 5 V / 3 A, 40 V input max
MB10F Bridge Rectifier | C441951 | MBS | 1 | SMD/Reflow | 1 A / 1000 V
ULN2803A Darlington Array | C56026 | SOP-18 | 1 | SMD/Reflow | 8-ch, internal flyback diodes. COM pin → +5 V
HF46F-G/5-HS1 Relay 5 V SMD | C165255 | SMD | 8 | SMD/Reflow | SPST-NO, G5NB footprint. Use ONLY C165255.
USBLC6-2SC6 USB ESD | C2827693 | SOT-23-6 | 1 | SMD/Reflow | D+ / D− TVS protection
MMBT3904 NPN Transistor | C20526 | SOT-23 | 2 | SMD/Reflow | Auto-reset circuit (Q1 and Q2)
USB Type-C Receptacle 16-pin | C165948 | SMD 16-pin | 1 | SMD/Reflow | Verify footprint before ordering
Barrel Jack 2.1 mm / 5.5 mm | Verify LCSC | THT | 1 | Hand | 24 VAC primary input
2-pin Screw Terminal 3.5 mm | C8465 | THT 3.5 mm | 10 | Hand | 8 outputs + COM + 1 AC alternate input
3-pin Header 2.54 mm (PWR-SEL) | Standard | THT | 1 | Hand | Power source selection jumper
MOV 47 V disc | Verify LCSC | 5 mm disc | 8 | Hand | Across each relay output
Red LED 0805 | C84256 | 0805 | 8 | SMD/Reflow | Per-channel indicators
Green LED 0805 | C72043 | 0805 | 1 | SMD/Reflow | System status (GPIO23)
470 Ω Resistor 0805 | Basic | 0805 | 8 | SMD/Reflow | Zone LED current limit
330 Ω Resistor 0805 | Basic | 0805 | 1 | SMD/Reflow | Status LED current limit
10 kΩ Resistor 0402 | Basic | 0402 | 8 | SMD/Reflow | Pull-ups (EN, IO0), GPIO12 pull-down, Q1/Q2 bases
5.1 kΩ Resistor 0402 | Basic | 0402 | 2 | SMD/Reflow | USB-C CC1 and CC2 to GND
100 nF Ceramic Cap 0402 | Basic | 0402 | 8 | SMD/Reflow | Decoupling: all IC power pins + Q1/Q2 bases
10 µF Ceramic Cap 0603 | Basic | 0603 | 3 | SMD/Reflow | AMS1117 in/out + ESP32 supply
470 µF Electrolytic 50 V | Verify LCSC | Radial | 1 | Hand | Bulk filter — bridge rectifier output
220 µF Electrolytic 10 V | Verify LCSC | Radial | 1 | Hand | LM2596 output filter
100 µH Inductor (1 A+) | Verify LCSC | SMD / THT | 1 | Reflow/Hand | LM2596 switching inductor
1N5822 Schottky Diode | Verify LCSC | DO-201 / SMD | 1 | SMD/Reflow | LM2596 catch diode
500 mA PTC Polyfuse 0805 | C386618 | 0805 | 1 | SMD/Reflow | USB VBUS protection
5 A PTC Polyfuse | Verify LCSC | THT / SMD | 1 | Reflow/Hand | AC line protection before bridge rectifier
BOOT Push Button 6 mm | C318884 | THT 6×6 mm | 1 | Hand | IO0 to GND
RST Push Button 6 mm | C318884 | THT 6×6 mm | 1 | Hand | EN to GND

⚠ NOTE: Relay part number C165255 (HF46F-G/5-HS1) must be used exactly. LCSC part C128511 has the same search name but is a capacitor. C22363895 is a through-hole relay with the wrong footprint. Verify the description in EasyEDA/LCSC before placing the order.

# 4. PCB Specifications

## 4.1 Board Parameters

Parameter | Specification
Layers | 2 (top copper and bottom copper)
Material | FR4
Thickness | 1.6 mm
Surface Finish | ENIG (Electroless Nickel Immersion Gold) — required for solderability and shelf life
Copper Weight | 1 oz both layers
Solder Mask | Green, both sides
Silkscreen | White, both sides. All reference designators, connector labels, pin 1 markers, and board revision number.
Target Board Size | ~100 mm × 80 mm — adjust to fit all components with required clearances
Minimum Trace Width | 0.15 mm general; 1.5 mm minimum for relay contact traces and AC input traces
Minimum Via | 0.3 mm drill, 0.6 mm pad
Mounting Holes | 4 × M3 (3.2 mm drill, 6.5 mm copper ring) at corners. 5 mm clearance from all copper.
Fiducial Marks | Minimum 3 on the top copper layer for PCBA pick-and-place alignment

## 4.2 Trace Width Requirements

Net / Signal | Min Width | Notes
24 VAC input traces | 1.5 mm | Before and after bridge rectifier
Relay contact traces | 1.5 mm | COM bus and all zone output traces — 5 A rated
+5 V power bus | 0.8 mm | Supply to relay coils, CH340C, ULN2803A
+3.3 V power bus | 0.5 mm | ESP32 and logic supply
GND pour | Copper fill | Flood fill on both layers; via-stitch together
GPIO signal traces | 0.25 mm | Logic signals from ESP32 to ULN2803A
USB data lines (D+, D−) | 0.2 mm | Matched length; keep away from switching supply
UART (TX, RX) | 0.2 mm | Keep away from the LM2596 switching loop

## 4.3 Clearance Requirements

- AC safety clearance: 3 mm minimum between any 24 VAC trace and all low-voltage DC traces. This is a safety isolation requirement and must not be reduced.
- Relay contact traces (switched AC, NO terminal): 3 mm minimum clearance from all DC logic traces.
- General PCB clearance (non-high-voltage): 0.2 mm minimum between all other traces and copper areas.
- Mounting hole clearance: 5 mm from all copper, no exceptions.
- Board edge clearance: 0.3 mm minimum for copper; 0.5 mm for components.

## 4.4 Ground Plane

- Flood fill GND copper on both top and bottom layers.
- Via-stitch the top and bottom GND pours together with multiple vias around the perimeter and under large copper areas.
- Do NOT flood fill GND copper under the ESP32-WROOM-32E antenna area. The keep-out zone must be copper-free on all layers.
- Use a single star-ground connection point between the AC/rectifier section and the DC logic ground to prevent AC noise coupling into the logic ground.

## 4.5 Switching Power Supply Layout (LM2596)

The LM2596 switching loop must be kept as tight and compact as possible to minimise radiated EMI.

- Switching loop: LM2596 OUTPUT pin → catch diode (D2) → inductor (L1) → output capacitor (C2) → GND. Keep this loop physically small.
- Place the catch diode directly adjacent to the LM2596 OUTPUT pin. The inductor and output capacitor should be close together.
- Do not route USB, UART, or GPIO traces near the LM2596 switching loop.

## 4.6 Component Placement Guidelines

- ESP32 module: Top side. Orient antenna toward a board edge with no copper within 15 mm of the antenna. Do not place in a corner.
- Relay block: Group all 8 relays together in two rows of four. Place close to the screw terminal edge.
- Screw terminals: Along one long edge of the board (the 'field wiring' edge). Relay channels CH1–CH8 in order, followed by COM.
- Power supply block (bridge rectifier, LM2596, AMS1117): On the opposite edge from the relay/terminal side. Keep high-voltage AC traces short and away from the ESP32 and USB section.
- USB-C connector: On the short edge of the board, accessible from outside an enclosure.
- BOOT and RST buttons: Near the ESP32 module, accessible without tools.
- Zone LEDs: Adjacent to their corresponding relay.
- Status LED: Near the ESP32 module, near the board edge for visibility.
- MOV snubbers: As close as possible to the screw terminal output connections.

# 5. Deliverables Required

The following files are required from the designer for JLCPCB PCBA order submission:

- Gerber files (RS-274X format): All copper layers, solder mask (both sides), silkscreen (both sides), board outline, and drill.
- Drill file: Excellon format with separate PTH (plated) and NPTH (non-plated) files.
- BOM CSV: Component reference designator, LCSC part number, quantity, footprint, and value. Must match the JLCPCB BOM template format.
- Pick and Place CSV (CPL): Component reference designator, centroid X, centroid Y, rotation, and layer. Must match the JLCPCB CPL template format.
- EasyEDA project source files (schematic + PCB layout) as backup.

⚠ NOTE: All SMD components should be placed on the top side of the board where possible to avoid double-sided assembly surcharges from JLCPCB. Through-hole components (screw terminals, barrel jack, push buttons, electrolytic capacitors, inductor) are hand-assembled after reflow and should be flagged in the BOM accordingly.

# 6. Prototype Verification Sequence

The following test sequence should be followed when the first prototype boards are received:

Step | Test
1 | Power on via USB only (no 24 VAC connected). Confirm +3.3 V and +5 V rails are present on test points. Confirm CH340C is detected by a PC as a virtual COM port.
2 | Flash the relay test firmware via Arduino IDE. Confirm each GPIO activates the correct relay in sequence (GPIO32 = channel 1 through GPIO13 = channel 8). Confirm the matching LED illuminates for each active relay.
3 | Connect 24 VAC. Confirm bridge rectifier output is approximately +30–34 V DC. Confirm LM2596 output is 5.0 V ± 0.25 V. Confirm AMS1117 output is 3.3 V ± 0.1 V.
4 | Flash the main application firmware. Confirm WiFi access point is visible. Configure WiFi credentials. Confirm board connects and the web interface loads at http://sprinkler.local via mDNS.
5 | Activate each relay channel from the web interface. Confirm the relay clicks, the LED illuminates, and continuity is present across the corresponding screw terminal output.

End of Contractor Design Brief | Hobby Board Project | Rev 1.0

Hobby Board — Contractor Brief v1.0 | Confidential Page

ESP32 8-Channel WiFi Relay Controller — Hobby Board Project CONTRACTOR DESIGN BRIEF
