John-High-Sierra/sprinkler.board/ESP32_Relay_Board_Description.docx

ESP32 8-Channel WiFi Relay Controller

Hardware Description and Component Reference

Rev 1.0 | 2026

This document describes the hardware design of a custom ESP32-based printed circuit board featuring eight independently controlled relay outputs, onboard WiFi, and a USB-C programming interface. It covers the function of each circuit block, key components, GPIO assignments, and PCB specifications. It is intended as a reference for manufacturers, assemblers, and engineers evaluating or working with the board.

# 1. Board Overview

This board is a compact, PCB built around the ESP32-WROOM-32E WiFi/Bluetooth module. It provides eight independent SPST relay outputs capable of switching AC or DC loads. The common of the relays are connected to the 24VAC positive. Each relay output must have a corresponding 24VDC Common terminal. The relay outputs will be protected by a snubber to prevent voltage spikes. Each relay will have a status LEDs that shows power to the Relay. A USB-C interface will be used for programming and serial communication. There must be onboard power regulation from a 24VAC input, which is isolated from the USB-C adapter. The 24V power will be connected to the board by a barrel connector. The board will have screw holes for standoffs. The board must have IO0 and EN buttons for programming

The design targets automated assembly through JLCPCB PCBA using components sourced from LCSC.

Attribute | Description
Microcontroller | ESP32-WROOM-32E (Xtensa dual-core 240MHz, integrated 2.4GHz WiFi and Bluetooth, 4MB flash)
Relay Outputs | 8 x SPST-NO electromechanical relays, rated 5A / 250VAC per contact
Relay Logic | Active HIGH — relay energises when GPIO is driven HIGH
Field Power Input | 24VAC via 2.1mm barrel jack (primary) or 2-pin screw terminal (alternate), user-selectable via on-board jumper
Board Supply Rails | +5V DC (relay coils, LED driver) and +3.3V DC (ESP32, logic)
USB Interface | USB Type-C, CH340C USB-to-UART bridge with auto-reset circuit
Output Indicators | 8 x red SMD LEDs, one per relay channel; 1 x green SMD status LED
Output Protection | MOV (metal oxide varistor) across each relay output for inductive load spike clamping
PCB | 2-layer FR4, 1.6mm, ENIG surface finish, green solder mask
Mounting | Four M3 mounting holes at board corners
User Controls | BOOT button (IO0 to GND), RST button (EN to GND)

# 2. Circuit Blocks

## 2.1 Power Supply

The board derives all operating power from a 24VAC input. The AC supply is rectified and regulated to produce the +5V and +3.3V rails required by the onboard electronics.

Input Connectors:

- Barrel jack: 2.1mm centre pin, 5.5mm outer diameter. AC input, not polarised.
- Screw terminal: 2-pin, 3.5mm pitch (AC1, AC2). Equivalent AC input for direct wire connection.
- Source selection jumper: 3-pin header (2.54mm pitch, labelled PWR-SEL). Pins 1-2 = barrel jack active. Pins 2-3 = screw terminal active. Only one source should be connected at a time.

AC to DC Conversion:

- Bridge rectifier: MB10F SMD full-wave bridge. Converts 24VAC to approximately +33V DC. Rated 1A / 1000V.
- Filter capacitor: 470 µF / 50V electrolytic, placed directly at the rectifier output.
- Input protection: 5A resettable polyfuse (PTC) on the AC input line before the bridge rectifier.

+5V Rail — LM2596S-5.0 Buck Converter:

- IC: LM2596S-5.0, TO-263-5 package. Input up to 40V, fixed 5V output, rated 3A.
- The switching converter is required because a linear regulator stepping from ~33V to 5V at meaningful current would dissipate excessive heat.
- External components per datasheet: 100 µH inductor, 220 µF output capacitor, 1N5822 Schottky catch diode.

+3.3V Rail — AMS1117-3.3 LDO:

- IC: AMS1117-3.3, SOT-223 package. Powered from the +5V rail.
- Decoupled with 10 µF input and 22 µF output ceramic capacitors.

## 2.2 Microcontroller — ESP32-WROOM-32E

The ESP32-WROOM-32E is a fully integrated module containing the ESP32 SoC, 4MB flash memory, 40MHz crystal, and a PCB trace antenna. It is mounted using its castellated edge pads.

- Supply: 3.3V. Decoupled with 10 µF + 100 nF ceramics at the module power pins.
- EN (enable) pin: pulled up to 3.3V via 10 kΩ. Reset button (RST) pulls EN to GND.
- IO0 (boot mode): pulled up to 3.3V via 10 kΩ. Boot button pulls IO0 to GND. IO0 = LOW at reset places the chip in UART bootloader mode for programming.
- GPIO12 (strapping pin): 10 kΩ pull-down to GND. This pin controls SDIO voltage selection at boot. It must be LOW or the chip may fail to start. This pull-down is non-negotiable.
- Antenna keep-out: A copper-free zone of at least 15mm must be maintained around the on-module PCB antenna. No copper pours, traces, or components in this area.

GPIO Assignments:

GPIO | Function | Notes
GPIO32 | Relay Channel 1 | Output to ULN2803A input 1
GPIO33 | Relay Channel 2 | Output to ULN2803A input 2
GPIO25 | Relay Channel 3 | Output to ULN2803A input 3
GPIO26 | Relay Channel 4 | Output to ULN2803A input 4
GPIO27 | Relay Channel 5 | Output to ULN2803A input 5
GPIO14 | Relay Channel 6 | Output to ULN2803A input 6
GPIO12 | Relay Channel 7 | Output to ULN2803A input 7. 10 kΩ pull-down to GND (strapping pin)
GPIO13 | Relay Channel 8 | Output to ULN2803A input 8
GPIO23 | Status LED | Active HIGH. 330 Ω series resistor to GND
GPIO1 (TX0) | UART TX | Connected to CH340C RXD
GPIO3 (RX0) | UART RX | Connected from CH340C TXD
GPIO0 / IO0 | Boot select | 10 kΩ pull-up. Boot button and auto-reset circuit
EN | Chip enable / reset | 10 kΩ pull-up. RST button and auto-reset circuit

## 2.3 USB-C Programming Interface — CH340C

The CH340C provides USB-to-UART conversion for firmware programming and serial monitoring. The CH340C has an internal oscillator — no external crystal is fitted.

- USB connector: USB Type-C receptacle, 16-pin SMD.
- CC1 and CC2 pins: Each connected to GND through a 5.1 kΩ resistor. Required by the USB-C specification for the host to recognise the device and supply bus power.
- ESD protection: USBLC6-2SC6 SOT-23-6 TVS diode array across D+ and D- lines.
- VBUS polyfuse: 500mA resettable PTC fuse in series with the USB VBUS line.
- Decoupling: 100 nF ceramic at CH340C VCC pin.

Auto-Reset Circuit:

Two MMBT3904 NPN transistors allow the programming tool (Arduino IDE, esptool) to automatically place the ESP32 into bootloader mode without manual button pressing. The CH340C DTR signal controls IO0 and the RTS signal controls EN, replicating the standard ESP32 DevKit reset sequence.

- Q1 (MMBT3904): Base from CH340C RTS through 10 kΩ. Collector to ESP32 EN. Emitter to GND.
- Q2 (MMBT3904): Base from CH340C DTR through 10 kΩ. Collector to ESP32 IO0. Emitter to GND.
- 100 nF capacitor from each transistor base to GND for noise suppression.

## 2.4 Relay Driver and Output Block

Eight electromechanical relays are driven by a ULN2803A Darlington transistor array. The ESP32 GPIOs drive the ULN2803A inputs; the ULN2803A collector outputs sink current through the relay coils.

ULN2803A — Relay Driver IC:

- 8-channel Darlington array with internal flyback diodes on every output.
- Inputs 1-8: Connected directly to ESP32 GPIO32, 33, 25, 26, 27, 14, 12, 13.
- COM pin (pin 9): Connected to +5V. This is the return rail for the internal flyback diodes and must connect to the relay coil supply voltage.
- Collector outputs: Each connected to the relay coil negative terminal.

Relays — HF46F-G/5-HS1:

- Type: SPST-NO (normally open), single pole. Contact rating: 5A / 250VAC.
- Coil: 5V DC, G5NB-compatible SMD footprint.
- LCSC part number: C165255. Do not substitute — C128511 is a capacitor and C22363895 is a through-hole relay.
- Coil positive: +5V. Coil negative: ULN2803A collector output.

Output Screw Terminals:

- 8 x 2-pin screw terminals (3.5mm pitch, rated 10A/300V), one per relay channel. Labelled CH1 through CH8 on silkscreen.
- 1 x 2-pin screw terminal for the relay contact COM connection. Labelled COM on silkscreen.

NOTE: The COM screw terminal connects to the supply voltage that the relay contacts will switch. For 24VAC loads this would be one leg of the 24VAC supply — separate from the board power supply rail.

## 2.5 Indicators

Per-Channel LEDs (x8, Red):

- One red SMD LED (0805) per relay channel.
- Connected between the relay coil positive terminal (+5V) and the ULN2803A collector output via a 470 Ω series resistor.
- LED illuminates when the relay is energised (channel is active).
- Placed adjacent to its corresponding relay on the PCB.

Status LED (x1, Green):

- One green SMD LED (0805) driven by GPIO23 through a 330 Ω series resistor to GND.
- Active HIGH. Used by firmware to indicate system state (e.g., idle heartbeat, active output).
- Placed near the ESP32 module.

## 2.6 Output Protection — MOV Snubbers

Inductive loads generate voltage spikes when switched off. A metal oxide varistor (MOV) across each relay output clamps these spikes and protects the relay contacts.

- One MOV per channel: connected across the relay NO output terminal and the COM terminal.
- Rating: 47V clamping voltage (suitable for 24VAC loads — peak voltage 33.9V). Use TVR05470 or equivalent.
- Total MOV count: 8.

NOTE: The ULN2803A internal flyback diodes separately protect the +5V rail from coil-side back-EMF. The MOVs protect the relay contact side from load-side transients. Both types of protection are present.

# 3. Component List

Components are sourced from LCSC and assembled by JLCPCB PCBA. LCSC part numbers are provided for all confirmed parts. Through-hole components (marked THT) may be hand-assembled after SMD reflow.

Component | LCSC Part | Package | Qty | Assembly | Notes
ESP32-WROOM-32E | C701341 | Module | 1 | SMD / Reflow | 4MB flash minimum
CH340C USB-UART | C84681 | SOP-16 | 1 | SMD / Reflow | No external crystal needed
AMS1117-3.3 LDO Regulator | C6186 | SOT-223 | 1 | SMD / Reflow | 3.3V, 1A
LM2596S-5.0 Buck Converter | C2621 | TO-263-5 | 1 | SMD / Reflow | 5V/3A, 40V input max
MB10F Bridge Rectifier | C441951 | MBS | 1 | SMD / Reflow | 1A / 1000V SMD
ULN2803A Darlington Array | C56026 | SOP-18 | 1 | SMD / Reflow | 8-ch, internal flyback diodes
HF46F-G/5-HS1 Relay 5V SMD | C165255 | SMD | 8 | SMD / Reflow | SPST-NO, 5A/250VAC, G5NB footprint
USBLC6-2SC6 USB ESD Protection | C2827693 | SOT-23-6 | 1 | SMD / Reflow | D+ / D- TVS protection
MMBT3904 NPN Transistor | C20526 | SOT-23 | 2 | SMD / Reflow | Auto-reset circuit
USB Type-C Receptacle 16-pin | C165948 | SMD | 1 | SMD / Reflow | Verify footprint before ordering
Barrel Jack 2.1mm / 5.5mm | Verify LCSC | THT | 1 | Hand assembly | AC input primary
2-pin Screw Terminal 3.5mm | C8465 | THT | 10 | Hand assembly | 8 ch outputs + COM + AC alt input
3-pin Header 2.54mm (PWR-SEL) | Standard | THT | 1 | Hand assembly | Power source selection jumper
MOV 47V Disc (output protection) | Verify LCSC | 5mm disc | 8 | Hand assembly | Across each relay output
Red LED 0805 | C84256 | 0805 | 8 | SMD / Reflow | Per-channel indicators
Green LED 0805 | C72043 | 0805 | 1 | SMD / Reflow | System status (GPIO23)
470 Ω Resistor 0805 | Basic | 0805 | 8 | SMD / Reflow | Channel LED current limit
330 Ω Resistor 0805 | Basic | 0805 | 1 | SMD / Reflow | Status LED current limit
10 kΩ Resistor 0402 | Basic | 0402 | 8 | SMD / Reflow | Pull-ups, pull-down (GPIO12), base resistors
5.1 kΩ Resistor 0402 | Basic | 0402 | 2 | SMD / Reflow | USB-C CC1 and CC2 to GND
100 nF Ceramic Cap 0402 | Basic | 0402 | 10 | SMD / Reflow | IC decoupling capacitors
10 µF Ceramic Cap 0603 | Basic | 0603 | 3 | SMD / Reflow | AMS1117 I/O, ESP32 supply
470 µF Electrolytic 50V | Verify LCSC | Radial | 1 | Hand assembly | Bulk filter, post rectifier
220 µF Electrolytic 10V | Verify LCSC | Radial | 1 | Hand assembly | LM2596 output filter
100 µH Inductor (rated 1A+) | Verify LCSC | SMD/THT | 1 | Reflow or hand | LM2596 switching inductor
1N5822 Schottky Diode | Verify LCSC | DO-201AD / SMD | 1 | SMD / Reflow | LM2596 catch diode
500mA PTC Polyfuse 0805 | C386618 | 0805 | 1 | SMD / Reflow | USB VBUS protection
5A PTC Polyfuse (AC line) | Verify LCSC | THT/SMD | 1 | Reflow or hand | AC input line protection
BOOT Push Button 6mm | C318884 | THT | 1 | Hand assembly | IO0 to GND
RST Push Button 6mm | C318884 | THT | 1 | Hand assembly | EN to GND

# 4. PCB Specifications

## 4.1 Board Parameters

Parameter | Value
Layers | 2 (top copper, bottom copper)
Material | FR4
Thickness | 1.6mm
Surface Finish | ENIG (Electroless Nickel Immersion Gold)
Copper Weight | 1oz both layers
Solder Mask | Green, both sides
Silkscreen | White, both sides. All reference designators, connector labels, pin 1 markers, board revision
Approx. Board Size | ~100mm x 80mm (adjust to fit all components with required clearances)
Minimum Trace Width | 0.15mm general; 1.5mm for relay contact and AC traces
Minimum Via | 0.3mm drill, 0.6mm pad
Mounting Holes | 4 x M3 (3.2mm drill, 6.5mm copper ring), one at each corner, 5mm clearance from all copper

## 4.2 Key Layout Rules

- Antenna keep-out: No copper within 15mm of the ESP32 module antenna.
- AC isolation: 3mm minimum clearance between 24VAC traces and all low-voltage DC logic traces.
- GND: Flood fill on both layers. Via-stitch top and bottom pours together. No GND pour under the ESP32 antenna.
- Relay contact traces (carrying switched AC): Minimum 1.5mm width.
- 5V power bus: Minimum 0.8mm width.
- USB D+ / D-: 0.2mm, matched length, keep away from switching supply.
- LM2596 switching loop: Keep switching current loop (output pin → catch diode → inductor → capacitor → GND) as tight as possible to reduce EMI. Do not route sensitive signals nearby.
- Screw terminals: Along one long edge of the board for clean field wiring access.
- USB-C connector: On a short edge, accessible from outside an enclosure.
- Per-channel LEDs: Placed adjacent to their corresponding relay.
- Fiducial marks: Minimum 3 on the top copper layer for PCBA alignment.

End of Document

ESP32 8-Channel WiFi Relay Controller | Hardware Description | Rev 1.0 Page 9

ESP32 8-Channel WiFi Relay Controller — Hardware Description
