John-High-Sierra/sprinkler.board/Screenshot 2026-04-19 154255.png

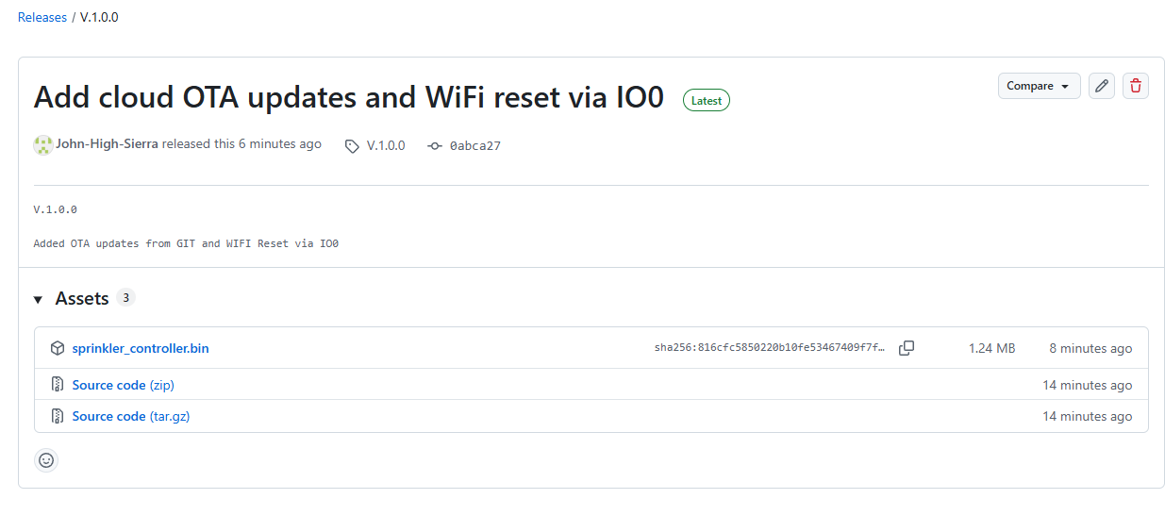
Screenshot 2026-04-19 154255.png
