John-High-Sierra/sprinkler.board/SprinKlr8_Schematic.png

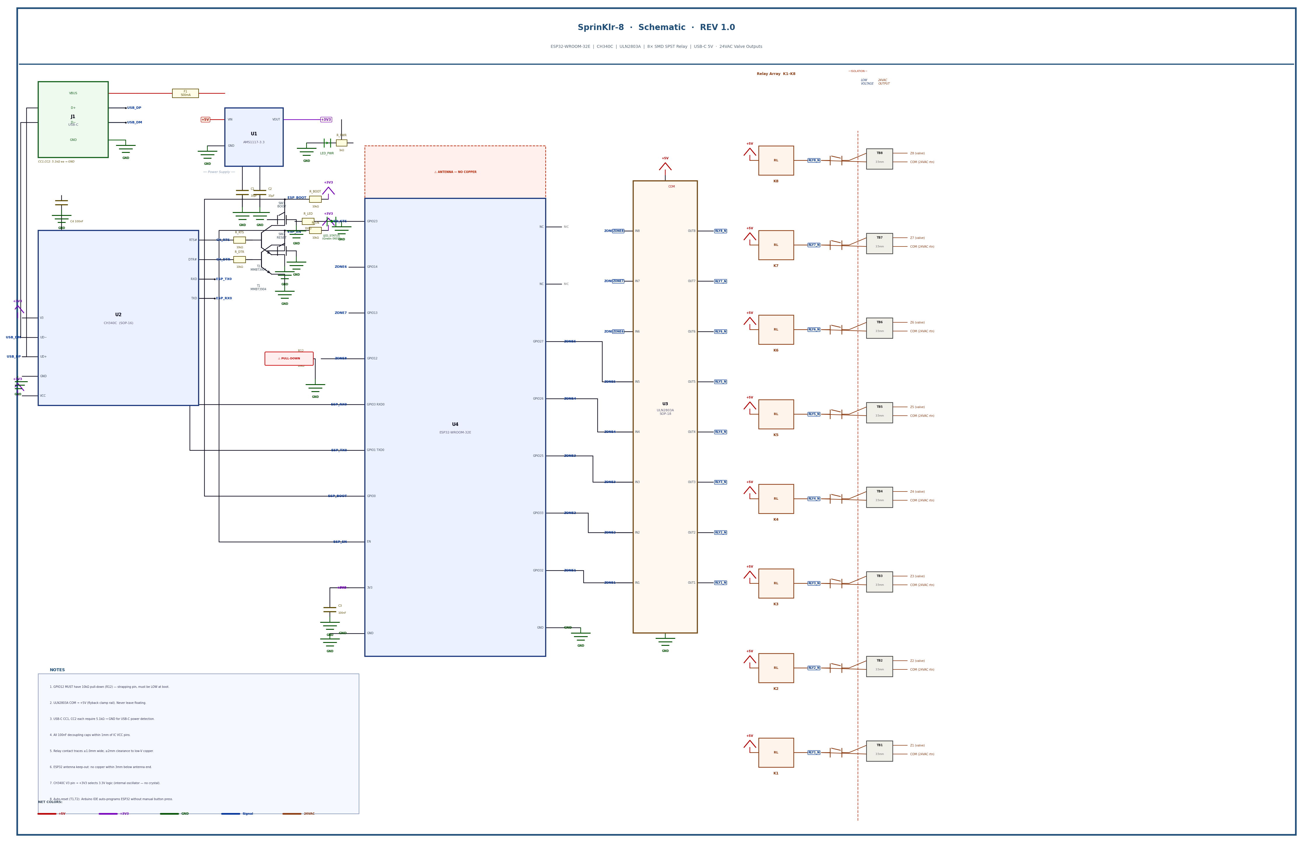
SprinKlr8_Schematic.png
