John-High-Sierra/sprinkler.board/SprinKlr8_PCB_Design_Guide.docx

SprinKlr-8

Custom PCB Design Guide

EasyEDA -> Schematic -> PCB -> JLCPCB PCBA

8-Zone ESP32 WiFi Sprinkler Controller

All-SMD | USB-C Programming | 24VAC Field Supply | JLCPCB PCBA Ready

# 1. Tool Selection -- EasyEDA Standard

EasyEDA Standard (the original web-based EasyEDA, not EasyEDA Pro) is the best choice. Free, browser-based, with native one-click integration with LCSC and JLCPCB.

| EasyEDA Standard | EasyEDA Pro | KiCad 8
Cost | Free | Free | Free
Platform | Browser | Browser/Desktop | Desktop only
LCSC integration | Native 1-click | Native 1-click | Manual / plugin
JLCPCB export | 1-click order | 1-click order | Manual Gerber
Learning curve | Low | Medium | High
Recommendation | USE THIS | Overkill for now | Overkill for now

NOTE: Go to easyeda.com -> Sign Up -> create a free account. Use the Standard edition.

# 2. Circuit Architecture Overview

The SprinKlr-8 board has five functional blocks:

Block | Key IC | Function | Voltage
Power supply | MB10F + LM2596S-5.0 | 24VAC -> bridge rectifier -> 5V DC; SS14 Schottky allows simultaneous USB-C bench power | 24VAC in / 5V out
3.3V reg | AMS1117-3.3 | 5V -> 3.3V LDO for ESP32 and CH340C | 5V in / 3.3V out
USB-UART | CH340C | USB -> UART bridge for Arduino flashing; auto-resets ESP32 via T1/T2 | 3.3V logic
Microcontroller | ESP32-WROOM-32E | WiFi, web server, scheduling, controls 8 relay GPIOs | 3.3V
Relay driver | ULN2803A | Darlington array: sinks relay coil current, includes flyback diodes | 5V coils
Relay outputs | 8x SMD relay | SPST-NO contacts switch external 24VAC to irrigation valves | 24VAC switched

Isolation boundary: The relay contacts isolate the valve circuit. The 24VAC power input (J2 Pins 1-2) is rectified on-board -- maintain 1.0mm creepage between AC traces and 5V/3.3V circuitry. Relay contacts carry 24VAC to valve solenoids and must maintain 2.0mm clearance from low-voltage traces.

# 3. Complete Component Netlist

Every pin of every component listed with its net name. In EasyEDA, name nets with the Net Label tool -- any two pins with the same label are connected.

## 3.1 Power Supply (24VAC + USB-C dual input)

Sub-circuit A -- 24VAC input and rectification:

Ref | Component | Pin / Signal | Net / Connection
J2 | 11-pin 5.08mm screw terminal LCSC C2915640/C5143711 | Pin 1 (AC_LINE) Pin 2 (AC_NEUTRAL) | AC_LINE -> F1 input AC_NEUTRAL -> bridge rectifier AC2
F1 | 1A slow-blow 5x20mm fuse holder LCSC C3131 | IN - OUT | AC_LINE -> fuse -> bridge rectifier AC1
D10 | MB10F bridge rectifier SOP-4 LCSC C2491 | AC1, AC2 + (DC out) - (GND) | AC1 <- F1 out AC2 <- AC_NEUTRAL +DC_RAW -> C1+ GND
C1 | 470uF 50V electrolytic radial LCSC C90272 | + / - | +DC_RAW to GND (50V rating required)

Sub-circuit B -- LM2596S-5.0 buck regulator:

Ref | Component | Pin / Signal | Net / Connection
U5 | LM2596S-5.0 TO-263-5 LCSC C347421 | VIN OUT GND FB ON/OFF | +DC_RAW SW_NODE -> L1 -> +5V_RAIL GND Internal fixed 5V GND (tie low = always on)
L1 | 100uH SMD inductor LCSC C2929505 | Pin 1 - Pin 2 | SW_NODE -> +5V_RAIL
D11 | 1N5819 catch diode SOD-123 LCSC C191023 | Cathode - Anode | SW_NODE - GND (cathode to SW_NODE)
C2 | 220uF 10V electrolytic SMD LCSC C2992606 | + / - | +5V_RAIL to GND (buck output filter)

Sub-circuit C -- USB-C input:

Ref | Component | Pin / Signal | Net / Connection
J1 | USB-C 16-pin SMD LCSC C165948 | VBUS GND D+, D- CC1, CC2 | USB_VBUS -> D12 anode GND USB_DP/DM -> CH340C Each via R22/R23 5.1k-ohm to GND
D12 | SS14 Schottky SMA LCSC C2480 | Anode - Cathode | USB_VBUS -> +5V_RAIL
R22-R23 | 5.1k-ohm 0402 x2 LCSC C27864 | Each: one end CC, other GND | USB-C CC1 -> R22 -> GND; CC2 -> R23 -> GND

3.3V rail:

Ref | Component | Pin / Signal | Net / Connection
U4 | AMS1117-3.3 SOT-223 LCSC C6186 | VIN / VOUT / GND | +5V_RAIL / +3V3 / GND
C3 | 100nF 0402 LCSC C1525 | + / - | +5V_RAIL to GND (AMS1117 input bypass)
C4 | 100nF 0402 LCSC C1525 | + / - | +3V3 to GND (AMS1117 output bypass)
C5 | 100nF 0402 LCSC C1525 | + / - | +3V3 to GND (ESP32 VCC decoupling, within 1mm of module)
C6 | 100nF 0402 LCSC C1525 | + / - | +3V3 to GND (CH340C VCC decoupling)
D9 | Red LED 0402 LCSC C84256 | A -> K | +3V3 via R24 (1k-ohm 0402) -> GND
R24 | 1k-ohm 0402 LCSC C11702 | Series | +3V3 -> R24 -> D9 anode

NOTE: SS14 (D12) has ~0.3V forward drop. USB-only rail is ~4.6-4.7V -- sufficient for ESP32 and relays. When 24VAC connected, LM2596S-5.0 holds rail at 5.0V and D12 is reverse-biased.

## 3.2 USB-UART Bridge (CH340C)

NOTE: CH340C has an internal 12 MHz oscillator -- no external crystal needed.

Ref | Component | Pin / Signal | Net / Connection
U2 | CH340C SOP-16 LCSC C84681 | VCC / GND UD+ / UD- TXD / RXD DTR# / RTS# V3 (pin 15) XI, XO | +3V3 / GND USB_DP / USB_DM ESP_RX0 (GPIO3) / ESP_TX0 (GPIO1) CH_DTR -> T1 base via R_DTR 10k / CH_RTS -> T2 base via R_RTS 10k Tie to +3V3 Leave NC

## 3.3 Auto-Reset Circuit

Two-transistor circuit: allows Arduino IDE to auto-flash without pressing buttons.

Ref | Component | Pin | Net / Connection
T1 | MMBT3904 NPN SOT-23 LCSC C20526 | Base / Collector / Emitter | CH_DTR via R17 10k / ESP_EN (+R_EN pull-up to +3V3, SW2) / GND
T2 | MMBT3904 NPN SOT-23 LCSC C20526 | Base / Collector / Emitter | CH_RTS via R18 10k / ESP_BOOT/GPIO0 (+R_BOOT pull-up, SW1) / GND
R17 | 10k-ohm 0402 LCSC C25804 | DTR base resistor | CH_DTR -> R17 -> T1 base
R18 | 10k-ohm 0402 LCSC C25804 | RTS base resistor | CH_RTS -> R18 -> T2 base
R19 | 10k-ohm 0402 LCSC C25804 | EN pull-up | +3V3 -> R19 -> ESP_EN
R20 | 10k-ohm 0402 LCSC C25804 | BOOT pull-up | +3V3 -> R20 -> GPIO0/ESP_BOOT
SW1 | Tact switch SMD LCSC C318884 | -- | GPIO0 -> GND (BOOT button)
SW2 | Tact switch SMD LCSC C318884 | -- | ESP_EN -> GND (RESET button)

NOTE: Include the auto-reset circuit even if you plan to program once. Without it, every flash requires manually holding BOOT and pressing RESET.

## 3.4 ESP32-WROOM-32E Module

NOTE: Search LCSC part C701341 in EasyEDA to get the symbol with all 38 pins.

ESP32 Signal | Module Pin # | Net Name | Connection
GND | 1, 15, 38 | GND | Ground plane
3V3 | 2 | +3V3 | +3V3 rail
EN | 3 | ESP_EN | R19 (10k to +3V3), T1 collector, SW2
GPIO0 | 25 | ESP_BOOT | R20 (10k to +3V3), T2 collector, SW1
GPIO1 (TXD0) | 35 | ESP_TX0 | CH340C RXD
GPIO3 (RXD0) | 34 | ESP_RX0 | CH340C TXD
GPIO12 | 14 | ZONE8 | CRITICAL: R21 10k pull-DOWN to GND, then to ULN2803A IN8
GPIO13 | 16 | ZONE7 | ULN2803A IN7
GPIO14 | 13 | ZONE6 | ULN2803A IN6
GPIO23 | 37 | LED_STATUS | 330-ohm -> green status LED -> GND (optional)
GPIO25 | 10 | ZONE3 | ULN2803A IN3
GPIO26 | 11 | ZONE4 | ULN2803A IN4
GPIO27 | 12 | ZONE5 | ULN2803A IN5
GPIO32 | 8 | ZONE1 | ULN2803A IN1
GPIO33 | 9 | ZONE2 | ULN2803A IN2
All others | -- | NC | Leave unconnected

WARNING: GPIO12 MUST have R21 (10k pull-down to GND). This strapping pin must read LOW at boot. Most common mistake in custom ESP32 designs.

## 3.5 Relay Driver (ULN2803A)

R1-R8 (1k-ohm 0402, LCSC C11702) sit between each ESP32 zone GPIO and the corresponding ULN2803A input pin.

Ref | Component | Pin / Signal | Net / Connection
U3 | ULN2803A SOP-18 LCSC C5840 | IN1-IN8 (pins 1-8) OUT1-8 (pins 11-18) COM (pin 10) GND (pin 9) | ZONE1-ZONE8 via R1-R8 (1k-ohm each) RLY1_COIL_N through RLY8_COIL_N +5V_RAIL (flyback clamp -- MUST connect) GND

NOTE: ULN2803A COM pin MUST connect to +5V_RAIL. Leaving it floating causes relay switching noise and possible IC damage.

## 3.6 Relay Array (8x SMD Relay)

HF46F-G/5-HS1 (Hongfa, 5V SPST-NO, SMD gull-wing, LCSC C165255). Pin-compatible with Omron G5NB-1A-E.

Ref | Component | Pin | Net / Connection
K1-K8 | HF46F-G/5-HS1 LCSC C165255 | Coil + (pin 1) Coil - (pin 2) COM (pin 3) NO (pin 4) | +5V_RAIL RLYx_COIL_N -> ULN2803A OUTx VALVE_COM -> J2 Pin 3 VALVEx_NO -> J2 Pins 4-11

## 3.7 Zone Indicators

D1-D8: green LED 0402 (LCSC C72043). R9-R16: 470-ohm 0402 (LCSC C23190).

Each zone: +3V3 -> R9-R16 (470-ohm) -> D1-D8 (anode) -> (cathode) -> ESP32 GPIO via firmware control.

NOTE: Wire LED cathode to GPIO, anode to +3V3 via resistor. GPIO pulled LOW = LED on (matches firmware logic).

## 3.8 Output Terminal

Single 11-pin 5.08mm screw terminal J2 (LCSC C2915640/C5143711) for all field connections.

Ref | Component | Pin | Net / Connection
J2 | 11-pin 5.08mm LCSC C2915640/C5143711 | Pin 1 AC_LINE Pin 2 AC_NEUTRAL Pin 3 VALVE_COM Pins 4-11 ZONE1-8 | 24VAC Line (via F1 to bridge rectifier) 24VAC Neutral 24VAC common for all solenoids K1-K8 NO contacts

NOTE: Pins 1-2 carry 24VAC -- maintain 1.0mm clearance from these pads to any low-voltage copper.

# 4. EasyEDA Schematic -- Step by Step

## 4.1 New Project

- Log in at easyeda.com -> "New Project". Name it "SprinKlr8". Click "New Schematic".
- Right-click canvas -> "Document Properties" -> set paper to A3 landscape.
- Set grid to 2.54mm (100mil).

## 4.2 Placing Components

Use "Place > Search Part / Component" (Shift+F). Search by LCSC part number to get the exact symbol with footprint pre-assigned. Place every component in the table below before drawing any wires.

### 1. Power Supply (24VAC -> 5V -> 3.3V)

Qty | Component / Search Term | Designator | LCSC # | Placement Tip
1 | Fuse Holder 5x20mm (1A slow-blow) | F1 | C3131 | On AC_LINE between J2A Pin 1 and MB10F AC1
1 | Terminal 5.08mm 3P (AC_L, AC_N, VALVE_COM) | J2A | C2915640 | Right edge with J2B; AC + valve common
1 | MB10F Bridge Rectifier | D10 | C2491 | Near J2A, before LM2596S-5.0 input
1 | 470uF 50V SMD Aluminum Electrolytic | C1 | C90272 | Rectifier bulk cap -- adjacent to MB10F output
1 | LM2596S-5.0 | U5 | C347421 | Top-left -- buck converter; large copper pour for thermal
1 | 100uH SMD Inductor | L1 | C2929505 | Adjacent to LM2596S-5.0 SW pin -- buck output
1 | 1N5819 Catch Diode | D11 | C191023 | Adjacent to LM2596S-5.0 SW_NODE -- catch diode
1 | 220uF 25V SMD Aluminum Electrolytic | C2 | C2992606 | Buck output filter cap -- adjacent to U5 output
1 | SS14 Schottky | D12 | C2480 | Between USB-C VBUS and +5V_RAIL
1 | AMS1117-3.3 LDO | U4 | C6186 | After buck output, near ESP32 3V3 pin
1 | LED Red (power-on) | D9 | C84256 | Power-on indicator near U5/U4
1 | 1k-ohm (power LED resistor) | R24 | C11702 | Series with D9 power LED

### 2. MCU Core (ESP32 + strapping)

Qty | Component / Search Term | Designator | LCSC # | Placement Tip
1 | ESP32-WROOM-32E-N4 | U1 | C701341 | Center of board -- most connections
4 | 100nF 0402 MLCC (decoupling) | C3,C4,C5,C6 | C1525 | Within 1mm of each IC VCC pin
1 | 10k-ohm (EN pull-up) | R19 | C25804 | ESP32 EN to +3V3
1 | 10k-ohm (BOOT/GPIO0 pull-up) | R20 | C25804 | ESP32 GPIO0 to +3V3
1 | 10k-ohm (GPIO12 strap pull-down) | R21 | C25804 | ESP32 GPIO12 to GND -- selects 3.3V flash
2 | Tactile Switch 3x4mm SMD | SW1,SW2 | C318884 | Near ESP32 EN and GPIO0 -- BOOT and RESET

### 3. USB / Programming (USB-C, CH340C, auto-reset)

Qty | Component / Search Term | Designator | LCSC # | Placement Tip
1 | USB-C 16-pin SMD | J1 | C165948 | Top-left edge; VBUS to D12 Schottky
2 | 5.1k-ohm (USB-C CC1/CC2) | R22,R23 | C27864 | USB-C CC pull-downs -- mandatory for detection
1 | CH340C USB-UART | U2 | C84681 | Left of ESP32, near USB-C connector
2 | MMBT3904 NPN (auto-reset) | T1,T2 | C20526 | Between CH340C DTR/RTS and ESP32 EN/GPIO0
1 | 10k-ohm (DTR base resistor) | R17 | C25804 | CH340C DTR -> T1 base
1 | 10k-ohm (RTS base resistor) | R18 | C25804 | CH340C RTS -> T2 base

### 4. Zone Driver (GPIO -> ULN2803 -> relays -> outputs)

Qty | Component / Search Term | Designator | LCSC # | Placement Tip
1 | ULN2803ADWR Darlington Array | U3 | C5840 | Right of ESP32 -- relay interface
8 | 1k-ohm (GPIO -> ULN2803 input) | R1,R2,R3,R4,R5,R6,R7,R8 | C11702 | ESP32 GPIO to ULN2803 input -- one per zone
8 | HF46F-G/5-HS1 5V SPST-NO Relay | K1,K2,K3,K4,K5,K6,K7,K8 | C165255 | Far right column -- relay bank
1 | Terminal 5.08mm 8P (ZONE1-ZONE8) | J2B | C5143711 | Right edge with J2A; zone outputs

### 5. Status Indication (LEDs)

Qty | Component / Search Term | Designator | LCSC # | Placement Tip
8 | LED Green (zone active) | D1,D2,D3,D4,D5,D6,D7,D8 | C72043 | One per zone, near each relay
8 | 470-ohm (zone LED resistor) | R9,R10,R11,R12,R13,R14,R15,R16 | C23190 | Series with D1-D8

NOTE: This table lists every component required. Cross-check against the BOM in the Design Spec before starting schematic entry -- the LCSC part numbers in both documents are identical.

## 4.3 Drawing Net Connections

Use "Place > Wire" (W key) for short connections. Use Net Labels (N key) for long-distance connections.

- +5V_RAIL / GND: use EasyEDA built-in power symbols (Place > Power Port).
- +3V3: net label on all 3.3V pins.
- AC_LINE, AC_NEUTRAL: J2 pins 1-2 to F1 to MB10F AC inputs.
- DC_RAW: MB10F + output to C1 and LM2596S-5.0 VIN.
- SW_NODE: LM2596S-5.0 OUT to L1 to D11 cathode.
- ESP_TX0, ESP_RX0: CH340C TXD/RXD to ESP32 GPIO1/GPIO3.
- ZONE1-ZONE8: ESP32 GPIO outputs via R1-R8 (1k) to ULN2803A IN1-IN8.
- RLY1-RLY8_COIL_N: ULN2803A OUT1-8 to relay coil - pins.
- VALVE_COM: all relay COM contacts to J2 Pin 3.
- VALVE1-VALVE8: relay NO contacts to J2 Pins 4-11.

## 4.4 ERC (Electrical Rules Check)

- Run ERC: Tools > Electrical Rules Check. Fix all errors before proceeding.
- Expected warnings (ignore): "Pin unconnected" on unused ESP32 GPIOs.
- Must fix: "net has no driver", "pin not connected" on power pins, "duplicate net name".

# 5. PCB Layout -- Rules and Process

## 5.1 Board Stackup and Design Rules

Parameter | Value / Recommendation
Layers | 2-layer (JLCPCB cheapest -- sufficient for this design)
Board size target | 90 x 65mm
Min trace width (signal) | 0.2mm min, use 0.25mm for reliability
Min trace width (power) | 0.5mm for +5V_RAIL/+3V3; 1.0mm for SW_NODE and relay coil supply
Relay contact traces | 1.0mm min for relay NO/COM traces (24VAC)
AC input traces (J2 Pins 1-2) | 1.0mm min -- these carry 24VAC
Clearance signal-signal | 0.2mm min, use 0.25mm
Clearance 24VAC to low-V | 1.0mm min between AC traces and 5V/3.3V copper
Clearance relay contacts | 2.0mm min between relay contact copper and low-voltage traces
Via size | 0.6mm drill, 1.0mm pad
Ground plane | Pour GND on both layers
ESP32 antenna keep-out | No copper within 3mm below antenna end (notched end)

## 5.2 Component Placement Strategy

Board Zone | Components | Reasoning
Top-left | J1 (USB-C), D12 (SS14), F1 (fuse holder) | AC/USB entry -- fuse accessible on board edge
Top-left center | D10 (MB10F), C1 (470uF), U5 (LM2596S-5.0), L1, D11, C2 | Power supply sub-circuit -- keep SW_NODE loop tight; away from ESP32 RF
Top-center | U4 (AMS1117-3.3), C3-C6 (decoupling) | 5V -> 3.3V, close to ESP32 3V3 pin
Center-left | U2 (CH340C), T1, T2, R17-R20, SW1, SW2 | USB logic close to USB-C and ESP32 UART
Center | U1 (ESP32-WROOM-32E) | Antenna end faces board edge -- no copper pour under antenna
Center-right | R1-R8, R9-R16, R21 (GPIO12 pull-down) | Small passives close to their associated ICs
Center-right | D1-D8 (zone LEDs) | One per relay, visible from board top
Right side | U3 (ULN2803A), K1-K8 (relays) | Relay block separate from ESP32; direct path to J2
Right edge | J2 (11-pin terminal strip) | Always on board edge -- accessible for field wiring

## 5.3 Routing Order

- Power first: DC_RAW (1.0mm) from MB10F+ to LM2596S-5.0 VIN. SW_NODE loop (1.0mm). +5V_RAIL (0.5mm) to ULN2803A COM, relay coils, AMS1117 VIN.
- AC input: 1.0mm traces from J2 Pins 1-2 to F1 and MB10F. Keep 1.0mm from 5V/3.3V copper.
- USB differential pair: route D+ and D- together, matched length.
- UART: ESP_TX0 and ESP_RX0 between CH340C and ESP32.
- Auto-reset: CH_DTR/CH_RTS through R17/R18 to T1/T2 bases; collectors to ESP_EN and ESP_BOOT.
- Zone signals: ZONE1-ZONE8 from ESP32 GPIOs through R1-R8 to ULN2803A INx.
- Relay coils: RLY1-RLY8_COIL_N from ULN2803A OUTs to relay coil - pins.
- Relay contacts: 1.0mm traces from relay COM/NO to J2 Pins 3-11.
- Pour ground: last step. Design > Copper Pour on both layers. Check ESP32 antenna keep-out.

## 5.4 Design Rule Check (DRC)

- Run DRC: Tools > DRC. Zero errors allowed before exporting.
- Common error: clearance violation between relay/AC traces and low-voltage traces -- reroute.
- Check silkscreen: reference designators visible, not covered by pads.

# 6. JLCPCB Export and Order

## 6.1 Export Files

- Gerber ZIP: Fabrication > Generate Gerber.
- BOM CSV: Fabrication > BOM. LCSC part numbers pre-filled.
- CPL CSV: Fabrication > Component Placement List.

## 6.2 JLCPCB Order Process

- jlcpcb.com -> "Order Now" -> Upload Gerber ZIP.
- Set PCB options: 2 layers, 1.6mm, HASL-LF, green soldermask.
- Enable PCB Assembly: "Standard PCBA", "Top Side". Upload BOM + CPL.
- Confirm components: check for "Out of Stock" items.
- Order 5 prototypes first at ~$25-35/board before the 1,000-unit run.

NOTE: F1 (fuse holder) and J2 (terminal strip) are through-hole. Hand-solder these after receiving boards.

## 6.3 Prototype Test Sequence

- Visual check: inspect solder joints under magnification.
- Continuity check: verify +5V_RAIL and GND are not shorted.
- USB-only power test: connect USB-C only. Measure +5V_RAIL (~4.6-4.7V) and +3V3.
- 24VAC power test: connect 24VAC to J2 Pins 1-2. Measure +5V_RAIL (5.0V expected) and +3V3.
- Dual-supply test: connect both simultaneously. Verify +5V_RAIL = 5.0V; USB host shows no unexpected current.
- Flash firmware: CH340C appears as COM port. Flash sprinkler_controller.ino.
- Relay test: use /api/run_zone to toggle each relay. Verify click and NO contact continuity.
- 24VAC valve test: connect solenoid to Zone 1. Activate -- verify valve opens. Deactivate -- verify closes.
- 48-hour soak test: full 8-zone schedule. No thermal issues, no relay failures, WiFi stays connected.

# 7. Quick Reference -- All Nets

Net Name | From | To
AC_LINE | J2 Pin 1 | F1 -> MB10F AC1
AC_NEUTRAL | J2 Pin 2 | MB10F AC2
DC_RAW | MB10F + output | C1 +, U5 LM2596S-5.0 VIN
SW_NODE | U5 OUT pin | L1 pin 1, D11 cathode
+5V_RAIL | L1 pin 2 (buck output) | ULN2803A COM, relay K1-K8 coil+, U4 AMS1117 VIN, D12 cathode
USB_VBUS | J1 USB-C VBUS | D12 anode (SS14 Schottky)
+3V3 | U4 AMS1117 VOUT | ESP32 3V3, CH340C VCC, pull-up resistors
USB_DP / USB_DM | J1 D+/D- | CH340C UD+/UD-
ESP_TX0 | ESP32 GPIO1 | CH340C RXD
ESP_RX0 | CH340C TXD | ESP32 GPIO3
CH_DTR | CH340C DTR# | T1 base via R17 (10k)
CH_RTS | CH340C RTS# | T2 base via R18 (10k)
ESP_EN | R19 (+3V3 pull-up) | ESP32 EN, T1 collector, SW2
ESP_BOOT | R20 (+3V3 pull-up) | ESP32 GPIO0, T2 collector, SW1
ZONE1-ZONE8 | ESP32 GPIO32,33,25,26,27,14,13,12 | R1-R8 (1k) -> ULN2803A IN1-IN8
RLY1-8_COIL_N | ULN2803A OUT1-OUT8 | Relay K1-K8 coil - pin
VALVE_COM | All relay K1-K8 COM contacts | J2 Pin 3 -> 24VAC common wire
VALVE1-VALVE8 | K1-K8 NO contacts | J2 Pins 4-11 -> valve solenoid wires

# 8. Pre-Production Checklist

Check | Item
[ ] | ERC passes with zero errors
[ ] | GPIO12 has R21 (10k pull-down to GND) -- verified in schematic AND on prototype
[ ] | USB-C CC1 and CC2 each have R22/R23 (5.1k to GND) -- required for USB-C power delivery detection
[ ] | ULN2803A COM pin connected to +5V_RAIL (not floating, not GND)
[ ] | R1-R8 (1k-ohm) placed between ESP32 zone GPIOs and ULN2803A IN1-IN8
[ ] | LM2596S-5.0 ON/OFF pin tied to GND (always-on)
[ ] | D11 (1N5819) cathode to SW_NODE, anode to GND -- not reversed
[ ] | D12 (SS14) cathode to +5V_RAIL, anode to USB_VBUS -- not reversed
[ ] | C1 (470uF 50V) polarity correct; 50V rating -- do not substitute lower voltage cap
[ ] | Creepage >= 1.0mm between AC_LINE/AC_NEUTRAL traces and any 5V/3.3V copper
[ ] | DRC passes with zero errors
[ ] | 2.0mm clearance between relay contact copper and low-voltage circuitry
[ ] | ESP32 antenna keep-out: no copper within 3mm below antenna end
[ ] | Ground pour on both layers with no isolated islands
[ ] | Prototype 24VAC test: +5V_RAIL = 5.0V +/- 0.1V under full relay load
[ ] | Prototype dual-supply test: USB + 24VAC simultaneously -- USB host shows no unexpected current
[ ] | LM2596S-5.0 temperature < 60C with all 8 relays energised
[ ] | All 8 relay outputs tested with 24VAC solenoid valves
[ ] | Arduino IDE auto-flash works without pressing buttons
[ ] | All LCSC parts in-stock with > 5,000 units available
[ ] | 48-hour soak test completed on at least 2 prototypes
[ ] | FCC SDoC documentation prepared (if selling in US)
