John-High-Sierra/sprinkler.board/esp32_firmware/sprinkler_controller/sprinkler_controller.ino

/**
 * ESP32 Sprinkler Controller
 * Target: ACEIRMC ESP32-WROOM-32E 8-Channel Relay Board (B0DTK2PB26)
 *
 * ─────────────────────────────────────────────────────────────────────
 *  CONFIRMED PINOUT (verified via ESPHome device registry)
 * ─────────────────────────────────────────────────────────────────────
 *  Relay 1 = GPIO32  |  Relay 5 = GPIO27
 *  Relay 2 = GPIO33  |  Relay 6 = GPIO14
 *  Relay 3 = GPIO25  |  Relay 7 = GPIO12  ← strapping pin, see note
 *  Relay 4 = GPIO26  |  Relay 8 = GPIO13
 *  Status LED = GPIO23
 *  Relay logic: ACTIVE HIGH (relay ON when GPIO = HIGH)
 *
 *  GPIO12 NOTE: This is a strapping pin on ESP32. It must be LOW at
 *  boot or the chip may fail to start. The firmware initialises it
 *  LOW (relay OFF) first thing, which is safe.
 *
 * ─────────────────────────────────────────────────────────────────────
 *  PROGRAMMING (no USB on this board — needs CP2102 adapter)
 * ─────────────────────────────────────────────────────────────────────
 *  Find the 6-pin header near the IO0/EN buttons (bottom-right of board)
 *  Typical pin order: 3V3 | GND | TX | RX | IO0 | EN
 *  Connect CP2102: TX→RX, RX→TX, GND→GND, 3.3V→3V3
 *  Flash mode: hold IO0 button, tap EN button, release IO0, then upload
 * ─────────────────────────────────────────────────────────────────────
 *
 * Required Libraries (install via Arduino Library Manager):
 *   - WiFiManager        (tzapu)
 *   - ArduinoJson        (bblanchon) v6+
 *   (WebServer.h, LittleFS, ESPmDNS built into ESP32 core — no extra libs needed)
 *
 * Improv WiFi Serial is implemented inline — no external library required.
 *
 * Board: "ESP32 Dev Module" in Arduino IDE
 * Partition Scheme: "Minimal SPIFFS (1.9MB APP with OTA/190KB SPIFFS)"
 * Upload Speed: 921600
 */

#include <Arduino.h>
#include <WiFi.h>
#include <WiFiManager.h>
#include "html_content.h"
#include "pwa_content.h"
#include <ESPmDNS.h>
#include <WebServer.h>
#include <ArduinoOTA.h>
#include <Update.h>
#include <HTTPClient.h>
#include <HTTPUpdate.h>
#include <WiFiClientSecure.h>
#include <LittleFS.h>
#include <ArduinoJson.h>
#include <time.h>

// ═══════════════════════════════════════════════════════════════
//  HARDWARE CONFIGURATION — EDIT THESE FOR YOUR BOARD
// ═══════════════════════════════════════════════════════════════

// CONFIRMED for ACEIRMC B0DTK2PB26 (verified via ESPHome device registry)
// Relay 1=GPIO32, 2=GPIO33, 3=GPIO25, 4=GPIO26, 5=GPIO27, 6=GPIO14, 7=GPIO12, 8=GPIO13
const int RELAY_PINS[8] = {32, 33, 25, 26, 27, 14, 12, 13};

// Relay logic: ACTIVE HIGH — relay energises when GPIO = HIGH
// This board uses optocouplers wired active-high
#define RELAY_ACTIVE_LOW false

// Number of zones (up to 8)
#define NUM_ZONES 8

// Status LED — GPIO23 confirmed for this board
#define STATUS_LED_PIN 23

// WiFi reset button — uses the onboard IO0/BOOT button (no extra hardware needed)
// Hold IO0 for 3 seconds after power-on / EN press to wipe saved WiFi and open portal
#define WIFI_RESET_PIN 0

// ═══════════════════════════════════════════════════════════════
//  SYSTEM CONSTANTS
// ═══════════════════════════════════════════════════════════════
#define SCHEDULE_FILE  "/schedule.json"
#define HOSTNAME       "sprinkler"
#define AP_NAME        "SprinklerSetup"
#define AP_PASSWORD    "sprinkler123"
#define NTP_SERVER     "pool.ntp.org"
#define OTA_PASSWORD   "sprinkler123"  // Password for Arduino IDE OTA and web UI upload
#define FW_VERSION     "D1.9.1"  // HTML embedded in firmware — single upload, no LittleFS needed

// Cloud update URLs — point these at your GitHub repo
#define CLOUD_FW_URL  "https://github.com/John-High-Sierra/sprinkler.board/releases/latest/download/sprinkler_controller.bin"
#define CONFIG_FILE    "/config.json"
#define RUN_LOG_FILE   "/runs.json"
#define RUN_LOG_MAX    60
#define DEFAULT_TZ     "UTC0"   // Overridden by config.json saved via Settings page

// ═══════════════════════════════════════════════════════════════
//  RELAY HELPER MACROS
// ═══════════════════════════════════════════════════════════════
#if RELAY_ACTIVE_LOW
  #define RELAY_ON(pin)  digitalWrite(pin, LOW)
  #define RELAY_OFF(pin) digitalWrite(pin, HIGH)
#else
  #define RELAY_ON(pin)  digitalWrite(pin, HIGH)
  #define RELAY_OFF(pin) digitalWrite(pin, LOW)
#endif

// ═══════════════════════════════════════════════════════════════
//  SCHEDULE DATA STRUCTURE
// ═══════════════════════════════════════════════════════════════
#define NUM_SCHEDULES 4

struct Schedule {
  char name[32];
  bool enabled;
  bool days[7];          // Mon=0 … Sun=6 — which days this schedule fires
  int  hour;
  int  minute;
  int  durations[NUM_ZONES]; // minutes per zone, 0 = skip
};

// ═══════════════════════════════════════════════════════════════
//  GLOBAL STATE
// ═══════════════════════════════════════════════════════════════
Schedule schedules[NUM_SCHEDULES];
bool     schedulingEnabled;

struct RunStatus {
  bool  isRunning;
  int   scheduleIndex;  // -1 if not running or manual single-zone
  int   activeZone;     // 0-indexed, -1 if not running
  int   remainingTime;  // seconds
  bool  manualRun;
};
volatile RunStatus runStatus = {false, -1, -1, 0, false};

SemaphoreHandle_t statusMutex;
SemaphoreHandle_t scheduleMutex;
volatile bool     stopRequested = false;
volatile bool     skipNextScheduledRun = false;
TaskHandle_t      telegramTaskHandle = NULL;

WebServer         server(80);

// ── Board config (timezone, etc.) persisted in config.json ──
struct BoardConfig {
  char timezone[64];
  float latitude;
  float longitude;
  bool weatherEnabled;
  int  rainThreshold;    // percent 0-100, skip if forecast >= this
  float freezeThreshold; // degrees C, skip if min temp <= this
  bool cycleAndSoakEnabled;
  int  cycleTime;            // minutes per cycle, default 4
  char tempUnit[2];          // "C" or "F", display preference only
  char zoneNames[8][32];     // user-defined zone names
  bool telegramEnabled;
  char telegramToken[128];   // bot token from @BotFather
  char telegramChatId[32];   // authorized chat ID — all others ignored
  bool  etScalingEnabled;    // scale zone durations by ET0 ratio
  float etBaseline;          // mm/day — "normal" day reference ET0
};
BoardConfig boardConfig;

struct WeatherCache {
  float currentTemp;   // degrees C, current conditions
  int   currentCode;   // WMO weather code, current conditions
  bool  valid;
  unsigned long fetchedAt;
  float hiTemps[5];    // degrees C, daily max, index 0 = today
  float loTemps[5];    // degrees C, daily min, index 0 = today
  int   rainProb[5];   // percent, index 0 = today
  int   codes[5];      // WMO weather code, daily, index 0 = today
  float et0[5];        // mm/day evapotranspiration, index 0 = today
};
WeatherCache weatherCache = {};
SemaphoreHandle_t weatherMutex;
TaskHandle_t      weatherTaskHandle = NULL;

// ── NTP sync helper ──────────────────────────────────────────
bool isNtpSynced() {
  return time(nullptr) > 1700000000UL; // valid if past Nov 2023
}

void applyTimezone() {
  setenv("TZ", boardConfig.timezone, 1);
  tzset();
}

int lastFiredDay[NUM_SCHEDULES];
int lastFiredMin[NUM_SCHEDULES];

// ═══════════════════════════════════════════════════════════════
//  RELAY CONTROL
// ═══════════════════════════════════════════════════════════════
void allRelaysOff() {
  for (int i = 0; i < NUM_ZONES; i++) {
    RELAY_OFF(RELAY_PINS[i]);
  }
}

void setupRelayPins() {
  for (int i = 0; i < NUM_ZONES; i++) {
    pinMode(RELAY_PINS[i], OUTPUT);
    RELAY_OFF(RELAY_PINS[i]);
  }
}

// ═══════════════════════════════════════════════════════════════
//  SCHEDULE PERSISTENCE (LittleFS)
// ═══════════════════════════════════════════════════════════════
void loadDefaultSchedule() {
  schedulingEnabled = true;
  for (int s = 0; s < NUM_SCHEDULES; s++) {
    snprintf(schedules[s].name, sizeof(schedules[s].name), "Schedule %d", s + 1);
    schedules[s].enabled = false;
    for (int d = 0; d < 7; d++) schedules[s].days[d] = false;
    schedules[s].hour   = 7;
    schedules[s].minute = 0;
    for (int z = 0; z < NUM_ZONES; z++) schedules[s].durations[z] = 0;
  }
}

bool loadSchedule() {
  if (!LittleFS.exists(SCHEDULE_FILE)) {
    Serial.println("[SCHED] No schedule file found, using defaults");
    loadDefaultSchedule();
    return false;
  }

  File f = LittleFS.open(SCHEDULE_FILE, "r");
  if (!f) {
    Serial.println("[SCHED] Failed to open schedule file");
    loadDefaultSchedule();
    return false;
  }

  DynamicJsonDocument doc(8192);
  DeserializationError err = deserializeJson(doc, f);
  f.close();

  if (err || !doc.containsKey("schedules")) {
    Serial.printf("[SCHED] JSON parse error or old format: %s — using defaults\n", err.c_str());
    loadDefaultSchedule();
    return false;
  }

  xSemaphoreTake(scheduleMutex, portMAX_DELAY);
  schedulingEnabled = doc["enabled"] | true;
  JsonArray arr = doc["schedules"].as<JsonArray>();
  for (int s = 0; s < NUM_SCHEDULES && s < (int)arr.size(); s++) {
    JsonObject o = arr[s];
    const char* nm = o["name"] | "";
    strlcpy(schedules[s].name, (strlen(nm) > 0 ? nm : "Schedule"), sizeof(schedules[s].name));
    schedules[s].enabled = o["enabled"] | false;
    schedules[s].hour    = o.containsKey("hour")   ? (int)o["hour"]   : 7;
    schedules[s].minute  = o.containsKey("minute") ? (int)o["minute"] : 0;
    JsonArray daysArr = o["days"].as<JsonArray>();
    for (int d = 0; d < 7; d++)
      schedules[s].days[d] = (d < (int)daysArr.size()) ? daysArr[d].as<bool>() : false;
    JsonArray durs = o["durations"].as<JsonArray>();
    for (int z = 0; z < NUM_ZONES; z++)
      schedules[s].durations[z] = (z < (int)durs.size()) ? (int)durs[z] : 0;
  }
  xSemaphoreGive(scheduleMutex);

  for (int s = 0; s < NUM_SCHEDULES; s++) {
    lastFiredDay[s] = -1;
    lastFiredMin[s] = -1;
  }
  Serial.println("[SCHED] Schedule loaded OK");
  return true;
}

bool saveSchedule() {
  DynamicJsonDocument doc(8192);

  xSemaphoreTake(scheduleMutex, portMAX_DELAY);
  doc["enabled"] = schedulingEnabled;
  JsonArray arr = doc.createNestedArray("schedules");
  for (int s = 0; s < NUM_SCHEDULES; s++) {
    JsonObject o = arr.createNestedObject();
    o["name"]    = schedules[s].name;
    o["enabled"] = schedules[s].enabled;
    o["hour"]    = schedules[s].hour;
    o["minute"]  = schedules[s].minute;
    JsonArray daysArr = o.createNestedArray("days");
    for (int d = 0; d < 7; d++) daysArr.add(schedules[s].days[d]);
    JsonArray durs = o.createNestedArray("durations");
    for (int z = 0; z < NUM_ZONES; z++) durs.add(schedules[s].durations[z]);
  }
  xSemaphoreGive(scheduleMutex);

  File f = LittleFS.open(SCHEDULE_FILE, "w");
  if (!f) { Serial.println("[SCHED] Failed to open file for writing"); return false; }
  serializeJson(doc, f);
  f.close();
  Serial.println("[SCHED] Schedule saved OK");
  return true;
}

// ═══════════════════════════════════════════════════════════════
//  BOARD CONFIG PERSISTENCE (timezone, etc.)
// ═══════════════════════════════════════════════════════════════
void loadConfig() {
  strlcpy(boardConfig.timezone, DEFAULT_TZ, sizeof(boardConfig.timezone));
  boardConfig.latitude            = 0.0f;
  boardConfig.longitude           = 0.0f;
  boardConfig.weatherEnabled      = false;
  boardConfig.rainThreshold       = 50;
  boardConfig.freezeThreshold     = 2.0f;
  boardConfig.cycleAndSoakEnabled = false;
  boardConfig.cycleTime           = 4;
  strlcpy(boardConfig.tempUnit, "C", sizeof(boardConfig.tempUnit));
  for (int i = 0; i < 8; i++) {
    snprintf(boardConfig.zoneNames[i], sizeof(boardConfig.zoneNames[i]), "Zone %d", i + 1);
  }
  boardConfig.telegramEnabled = false;
  memset(boardConfig.telegramToken,  0, sizeof(boardConfig.telegramToken));
  memset(boardConfig.telegramChatId, 0, sizeof(boardConfig.telegramChatId));
  boardConfig.etScalingEnabled = false;
  boardConfig.etBaseline       = 4.0f;

  if (!LittleFS.exists(CONFIG_FILE)) return;
  File f = LittleFS.open(CONFIG_FILE, "r");
  if (!f) return;
  DynamicJsonDocument doc(2048);
  DeserializationError err = deserializeJson(doc, f);
  f.close();
  if (err) {
    Serial.printf("[CFG] JSON parse error: %s, using defaults\n", err.c_str());
    return;
  }
  const char* tz = doc["timezone"];
  if (tz) strlcpy(boardConfig.timezone, tz, sizeof(boardConfig.timezone));
  boardConfig.latitude            = doc["latitude"]              | 0.0f;
  boardConfig.longitude           = doc["longitude"]             | 0.0f;
  boardConfig.weatherEnabled      = doc["weather_enabled"]       | false;
  boardConfig.rainThreshold       = doc["rain_threshold"]        | 50;
  boardConfig.freezeThreshold     = doc["freeze_threshold"]      | 2.0f;
  boardConfig.cycleAndSoakEnabled = doc["cycle_and_soak_enabled"]| false;
  boardConfig.cycleTime           = doc["cycle_time"]            | 4;
  const char* tu = doc["temp_unit"] | "C";
  strlcpy(boardConfig.tempUnit, (tu[0]=='F' ? "F" : "C"), sizeof(boardConfig.tempUnit));
  if (doc.containsKey("zone_names")) {
    JsonArray zn = doc["zone_names"].as<JsonArray>();
    for (int i = 0; i < 8 && i < (int)zn.size(); i++) {
      const char* n = zn[i];
      if (n) strlcpy(boardConfig.zoneNames[i], n, sizeof(boardConfig.zoneNames[i]));
    }
  }
  boardConfig.telegramEnabled = doc["telegram_enabled"] | false;
  { const char* v = doc["telegram_token"]   | ""; strlcpy(boardConfig.telegramToken,  v, sizeof(boardConfig.telegramToken)); }
  { const char* v = doc["telegram_chat_id"] | ""; strlcpy(boardConfig.telegramChatId, v, sizeof(boardConfig.telegramChatId)); }
  boardConfig.etScalingEnabled = doc["et_scaling_enabled"] | false;
  boardConfig.etBaseline       = doc["et_baseline"]        | 4.0f;
  Serial.printf("[CFG] Timezone: %s  Lat: %.4f  Lon: %.4f  WeatherSkip: %s\n",
    boardConfig.timezone, boardConfig.latitude, boardConfig.longitude,
    boardConfig.weatherEnabled ? "ON" : "OFF");
}

void saveConfig() {
  DynamicJsonDocument doc(2048);
  doc["timezone"]             = boardConfig.timezone;
  doc["latitude"]             = boardConfig.latitude;
  doc["longitude"]            = boardConfig.longitude;
  doc["weather_enabled"]      = boardConfig.weatherEnabled;
  doc["rain_threshold"]       = boardConfig.rainThreshold;
  doc["freeze_threshold"]     = boardConfig.freezeThreshold;
  doc["cycle_and_soak_enabled"] = boardConfig.cycleAndSoakEnabled;
  doc["cycle_time"]             = boardConfig.cycleTime;
  doc["temp_unit"]              = boardConfig.tempUnit;
  JsonArray zn = doc.createNestedArray("zone_names");
  for (int i = 0; i < 8; i++) zn.add(boardConfig.zoneNames[i]);
  doc["telegram_enabled"]   = boardConfig.telegramEnabled;
  doc["telegram_token"]     = boardConfig.telegramToken;
  doc["telegram_chat_id"]   = boardConfig.telegramChatId;
  doc["et_scaling_enabled"] = boardConfig.etScalingEnabled;
  doc["et_baseline"]        = boardConfig.etBaseline;
  File f = LittleFS.open(CONFIG_FILE, "w");
  if (!f) return;
  serializeJson(doc, f);
  f.close();
  Serial.printf("[CFG] Config saved\n");
}

// ═══════════════════════════════════════════════════════════════
//  RUN LOG (LittleFS /runs.json)
// ═══════════════════════════════════════════════════════════════
void appendRunLog(time_t ts, const char* trigger, int zoneIdxs[], int zoneSecs[], int count, const char* skipReason) {
  if (count == 0 && skipReason == nullptr) return;

  DynamicJsonDocument doc(8192);

  if (LittleFS.exists(RUN_LOG_FILE)) {
    File f = LittleFS.open(RUN_LOG_FILE, "r");
    if (f) {
      DeserializationError err = deserializeJson(doc, f);
      f.close();
      if (err || !doc.is<JsonArray>()) doc.to<JsonArray>();
    }
  } else {
    doc.to<JsonArray>();
  }

  JsonArray arr = doc.as<JsonArray>();
  JsonObject entry = arr.createNestedObject();
  entry["ts"]      = (long)ts;
  entry["trigger"] = trigger;
  JsonArray zones  = entry.createNestedArray("zones");
  for (int i = 0; i < count; i++) {
    JsonObject z = zones.createNestedObject();
    z["z"]    = zoneIdxs[i];
    z["name"] = boardConfig.zoneNames[zoneIdxs[i]];
    z["sec"]  = zoneSecs[i];
  }
  if (skipReason) entry["skip"] = skipReason;
  else            entry["skip"] = nullptr;

  while ((int)arr.size() > RUN_LOG_MAX) arr.remove(0);

  File f = LittleFS.open(RUN_LOG_FILE, "w");
  if (f) { serializeJson(doc, f); f.close(); }
  Serial.printf("[LOG] Run logged: trigger=%s zones=%d skip=%s\n",
    trigger, count, skipReason ? skipReason : "none");
}

// ═══════════════════════════════════════════════════════════════
//  WEATHER FETCH (Open-Meteo, no API key required)
// ═══════════════════════════════════════════════════════════════
void fetchWeather() {
  if (boardConfig.latitude == 0.0f && boardConfig.longitude == 0.0f) return;

  char url[512];
  snprintf(url, sizeof(url),
    "https://api.open-meteo.com/v1/forecast"
    "?latitude=%.4f&longitude=%.4f"
    "&current=temperature_2m,weathercode,precipitation"
    "&daily=precipitation_probability_max,temperature_2m_min,temperature_2m_max,weathercode,et0_fao_evapotranspiration"
    "&timezone=auto&forecast_days=5",
    boardConfig.latitude, boardConfig.longitude);

  Serial.printf("[WEATHER] Fetching: %s\n", url);

  WiFiClientSecure client;
  client.setInsecure();
  HTTPClient https;
  if (!https.begin(client, url)) {
    Serial.println("[WEATHER] Failed to begin HTTPS");
    return;
  }
  int code = https.GET();
  if (code != 200) {
    Serial.printf("[WEATHER] HTTP error: %d\n", code);
    https.end();
    return;
  }

  String body = https.getString();
  https.end();

  DynamicJsonDocument doc(4096);
  DeserializationError err = deserializeJson(doc, body);
  if (err) {
    Serial.printf("[WEATHER] JSON parse error: %s\n", err.c_str());
    return;
  }

  xSemaphoreTake(weatherMutex, portMAX_DELAY);
  weatherCache.currentTemp = doc["current"]["temperature_2m"] | 0.0f;
  weatherCache.currentCode = doc["current"]["weathercode"]    | 0;
  for (int i = 0; i < 5; i++) {
    weatherCache.rainProb[i] = doc["daily"]["precipitation_probability_max"][i]  | 0;
    weatherCache.loTemps[i]  = doc["daily"]["temperature_2m_min"][i]             | 0.0f;
    weatherCache.hiTemps[i]  = doc["daily"]["temperature_2m_max"][i]             | 0.0f;
    weatherCache.codes[i]    = doc["daily"]["weathercode"][i]                    | 0;
    weatherCache.et0[i]      = doc["daily"]["et0_fao_evapotranspiration"][i]     | 0.0f;
  }
  weatherCache.valid     = true;
  weatherCache.fetchedAt = millis();
  xSemaphoreGive(weatherMutex);

  Serial.printf("[WEATHER] Temp: %.1f°C  Rain today: %d%%  ET0 today: %.1fmm  Lo: %.1f°C  Hi: %.1f°C\n",
    weatherCache.currentTemp, weatherCache.rainProb[0],
    weatherCache.et0[0], weatherCache.loTemps[0], weatherCache.hiTemps[0]);
}

// Returns a skip reason string, or nullptr if no skip needed
const char* shouldSkipForWeather() {
  if (!boardConfig.weatherEnabled) return nullptr;

  xSemaphoreTake(weatherMutex, portMAX_DELAY);
  bool  valid      = weatherCache.valid;
  int   rainToday  = weatherCache.rainProb[0];
  int   rainTomrw  = weatherCache.rainProb[1];
  float minTemp    = weatherCache.loTemps[0];
  xSemaphoreGive(weatherMutex);

  if (!valid) return nullptr;
  if (rainToday >= boardConfig.rainThreshold || rainTomrw >= boardConfig.rainThreshold)
    return "rain forecast";
  if (minTemp <= boardConfig.freezeThreshold)
    return "freeze risk";
  return nullptr;
}

void weatherTask(void* param) {
  vTaskDelay(pdMS_TO_TICKS(5000)); // wait 5s for WiFi/NTP to settle
  fetchWeather();
  while (true) {
    // Block up to 1 hour; POST /api/config wakes us early via xTaskNotify
    ulTaskNotifyTake(pdTRUE, pdMS_TO_TICKS(3600000));
    fetchWeather();
  }
}

// ═══════════════════════════════════════════════════════════════
//  SPRINKLER SEQUENCE TASK (runs on separate FreeRTOS task)
// ═══════════════════════════════════════════════════════════════
struct RunArgs {
  int scheduleIndex;
  bool manual;
};

struct SingleZoneArgs { int zone; int dur; };

void runSequenceTask(void* param) {
  RunArgs* args   = (RunArgs*)param;
  int schedIdx    = args->scheduleIndex;
  bool manual     = args->manual;
  delete args;

  Serial.printf("[RUN] Starting sequence for schedule %d\n", schedIdx + 1);

  xSemaphoreTake(scheduleMutex, portMAX_DELAY);
  Schedule sched = schedules[schedIdx];
  xSemaphoreGive(scheduleMutex);

  // ── Compute ET0 scaling multiplier ──────────────────────
  float etMult = 1.0f;
  if (boardConfig.etScalingEnabled) {
    xSemaphoreTake(weatherMutex, portMAX_DELAY);
    float et0 = weatherCache.et0[0];
    xSemaphoreGive(weatherMutex);
    if (et0 > 0.0f && boardConfig.etBaseline > 0.0f)
      etMult = constrain(et0 / boardConfig.etBaseline, 0.5f, 2.0f);
    Serial.printf("[RUN] ET scaling: ET0=%.2fmm  baseline=%.2fmm  mult=%.2f\n",
      et0, boardConfig.etBaseline, etMult);
  }

  // ── Build scaled duration array (used by both run paths) ─
  int scaledDurations[NUM_ZONES];
  for (int z = 0; z < NUM_ZONES; z++) {
    if (sched.durations[z] <= 0) { scaledDurations[z] = 0; continue; }
    scaledDurations[z] = max(1, (int)roundf(sched.durations[z] * etMult));
  }

  stopRequested = false;
  int actualSecs[NUM_ZONES] = {0};
  {
    int totalMin = 0, zoneCount = 0;
    for (int z = 0; z < NUM_ZONES; z++) {
      if (scaledDurations[z] > 0) { totalMin += scaledDurations[z]; zoneCount++; }
    }
    char buf[160];
    int pos = snprintf(buf, sizeof(buf), "\xF0\x9F\x92\xA7 %s — %s \xe2\x80\x94 %d zone%s, ~%d min",
      manual ? "Manual" : "Scheduled", sched.name,
      zoneCount, zoneCount == 1 ? "" : "s", totalMin);
    if (boardConfig.etScalingEnabled && etMult != 1.0f)
      snprintf(buf + pos, sizeof(buf) - pos, " (ET \xc3\x97%.0f%%)", etMult * 100.0f);
    telegramNotify(buf);
  }

  if (boardConfig.cycleAndSoakEnabled) {
    // ── Cycle & Soak mode ────────────────────────────────
    int cycleTimeSec = boardConfig.cycleTime * 60;
    int remaining[NUM_ZONES];
    int activeCount = 0;
    for (int z = 0; z < NUM_ZONES; z++) {
      remaining[z] = scaledDurations[z] * 60;
      if (remaining[z] > 0) activeCount++;
    }

    int passNum = 0;
    while (!stopRequested) {
      bool anyLeft = false;
      for (int z = 0; z < NUM_ZONES; z++) {
        if (remaining[z] > 0) { anyLeft = true; break; }
      }
      if (!anyLeft) break;

      passNum++;
      Serial.printf("[RUN] C&S pass %d\n", passNum);

      for (int z = 0; z < NUM_ZONES; z++) {
        if (stopRequested) break;
        if (remaining[z] <= 0) continue;

        int thisRun = min(cycleTimeSec, remaining[z]);
        Serial.printf("[RUN] C&S pass %d zone %d: %d sec\n", passNum, z + 1, thisRun);
        RELAY_ON(RELAY_PINS[z]);

        int elapsed = 0;
        while (elapsed < thisRun && !stopRequested) {
          xSemaphoreTake(statusMutex, portMAX_DELAY);
          runStatus.isRunning     = true;
          runStatus.scheduleIndex = schedIdx;
          runStatus.activeZone    = z;
          runStatus.remainingTime = remaining[z] - elapsed;
          runStatus.manualRun     = manual;
          xSemaphoreGive(statusMutex);
          vTaskDelay(pdMS_TO_TICKS(1000));
          elapsed++;
        }

        remaining[z] -= elapsed;
        RELAY_OFF(RELAY_PINS[z]);
        Serial.printf("[RUN] C&S zone %d OFF, %d sec remaining\n", z + 1, remaining[z]);

        // Single active zone: explicit soak between cycles
        if (activeCount == 1 && remaining[z] > 0 && !stopRequested) {
          Serial.printf("[RUN] C&S soaking %d sec\n", cycleTimeSec);
          int soakElapsed = 0;
          while (soakElapsed < cycleTimeSec && !stopRequested) {
            xSemaphoreTake(statusMutex, portMAX_DELAY);
            runStatus.isRunning     = true;
            runStatus.scheduleIndex = schedIdx;
            runStatus.activeZone    = -1;
            runStatus.remainingTime = remaining[z];
            runStatus.manualRun     = manual;
            xSemaphoreGive(statusMutex);
            vTaskDelay(pdMS_TO_TICKS(1000));
            soakElapsed++;
          }
        }
      }
    }
    for (int z = 0; z < NUM_ZONES; z++) {
      actualSecs[z] = scaledDurations[z] * 60 - remaining[z];
    }

  } else {
    // ── Standard sequential mode with 2-second zone overlap ─
    bool overlapStarted[NUM_ZONES] = {false};

    for (int z = 0; z < NUM_ZONES; z++) {
      if (stopRequested) {
        Serial.println("[RUN] Stop requested, halting sequence");
        break;
      }

      int durMin = scaledDurations[z];
      if (durMin <= 0) {
        Serial.printf("[RUN] Zone %d skipped (duration=0)\n", z + 1);
        continue;
      }

      // Find next active zone for overlap handoff
      int nextZ = -1;
      for (int nz = z + 1; nz < NUM_ZONES; nz++) {
        if (scaledDurations[nz] > 0) { nextZ = nz; break; }
      }

      if (!overlapStarted[z]) {
        Serial.printf("[RUN] Zone %d ON for %d min\n", z + 1, durMin);
        RELAY_ON(RELAY_PINS[z]);
      }
      int rem = durMin * 60;

      while (rem > 0) {
        if (stopRequested) {
          Serial.printf("[RUN] Stop during zone %d\n", z + 1);
          break;
        }
        // Start next zone 2 seconds before this one ends
        if (rem == 2 && nextZ != -1 && !overlapStarted[nextZ]) {
          RELAY_ON(RELAY_PINS[nextZ]);
          overlapStarted[nextZ] = true;
          Serial.printf("[RUN] Zone %d ON (overlap start)\n", nextZ + 1);
        }
        xSemaphoreTake(statusMutex, portMAX_DELAY);
        runStatus.isRunning     = true;
        runStatus.scheduleIndex = schedIdx;
        runStatus.activeZone    = z;
        runStatus.remainingTime = rem;
        runStatus.manualRun     = manual;
        xSemaphoreGive(statusMutex);
        vTaskDelay(pdMS_TO_TICKS(1000));
        rem--;
      }

      RELAY_OFF(RELAY_PINS[z]);
      actualSecs[z] = durMin * 60 - rem;
      Serial.printf("[RUN] Zone %d OFF\n", z + 1);
      if (stopRequested) break;
    }
  }

  allRelaysOff();

  xSemaphoreTake(statusMutex, portMAX_DELAY);
  runStatus.isRunning     = false;
  runStatus.scheduleIndex = -1;
  runStatus.activeZone    = -1;
  runStatus.remainingTime = 0;
  runStatus.manualRun     = false;
  xSemaphoreGive(statusMutex);

  Serial.println("[RUN] Sequence complete");
  {
    time_t ts = time(nullptr);
    int logZ[NUM_ZONES], logS[NUM_ZONES], logCount = 0;
    for (int z = 0; z < NUM_ZONES; z++) {
      if (actualSecs[z] > 0) { logZ[logCount] = z; logS[logCount] = actualSecs[z]; logCount++; }
    }
    char trigger[48];
    if (manual) strlcpy(trigger, "manual", sizeof(trigger));
    else        snprintf(trigger, sizeof(trigger), "%s", sched.name);
    appendRunLog(ts, trigger, logZ, logS, logCount, nullptr);
    {
      char buf[384];
      int pos = snprintf(buf, sizeof(buf), "\xe2\x9c\x85 %s complete", sched.name);
      int totalSec = 0;
      for (int i = 0; i < logCount; i++) {
        pos += snprintf(buf + pos, sizeof(buf) - pos, "\n%s \xe2\x80\x94 %dm",
          boardConfig.zoneNames[logZ[i]], logS[i] / 60);
        totalSec += logS[i];
      }
      snprintf(buf + pos, sizeof(buf) - pos, "\nTotal: %dm", totalSec / 60);
      telegramNotify(buf);
    }
  }
  vTaskDelete(NULL);
}

void runSingleZoneTask(void* p) {
  SingleZoneArgs* a = (SingleZoneArgs*)p;
  int z   = a->zone;
  int dur = a->dur;
  delete a;

  stopRequested = false;
  int actualSec = 0;
  {
    char buf[96];
    snprintf(buf, sizeof(buf), "\xF0\x9F\x92\xA7 Manual run started \xe2\x80\x94 %s, %d min",
      boardConfig.zoneNames[z], dur);
    telegramNotify(buf);
  }

  if (boardConfig.cycleAndSoakEnabled) {
    int cycleTimeSec   = boardConfig.cycleTime * 60;
    int totalRemaining = dur * 60;

    while (totalRemaining > 0 && !stopRequested) {
      int thisRun = min(cycleTimeSec, totalRemaining);
      Serial.printf("[RUN] C&S zone %d: water %d sec\n", z + 1, thisRun);
      RELAY_ON(RELAY_PINS[z]);

      int elapsed = 0;
      while (elapsed < thisRun && !stopRequested) {
        xSemaphoreTake(statusMutex, portMAX_DELAY);
        runStatus.isRunning     = true;
        runStatus.scheduleIndex = -1;
        runStatus.activeZone    = z;
        runStatus.remainingTime = totalRemaining - elapsed;
        runStatus.manualRun     = true;
        xSemaphoreGive(statusMutex);
        vTaskDelay(pdMS_TO_TICKS(1000));
        elapsed++;
      }

      RELAY_OFF(RELAY_PINS[z]);
      totalRemaining -= elapsed;

      if (totalRemaining > 0 && !stopRequested) {
        Serial.printf("[RUN] C&S zone %d: soak %d sec, %d sec remaining\n", z + 1, cycleTimeSec, totalRemaining);
        int soakElapsed = 0;
        while (soakElapsed < cycleTimeSec && !stopRequested) {
          xSemaphoreTake(statusMutex, portMAX_DELAY);
          runStatus.isRunning     = true;
          runStatus.scheduleIndex = -1;
          runStatus.activeZone    = -1;
          runStatus.remainingTime = totalRemaining;
          runStatus.manualRun     = true;
          xSemaphoreGive(statusMutex);
          vTaskDelay(pdMS_TO_TICKS(1000));
          soakElapsed++;
        }
      }
    }
    actualSec = dur * 60 - totalRemaining;
  } else {
    RELAY_ON(RELAY_PINS[z]);
    int remaining = dur * 60;
    while (remaining > 0 && !stopRequested) {
      xSemaphoreTake(statusMutex, portMAX_DELAY);
      runStatus.isRunning     = true;
      runStatus.scheduleIndex = -1;
      runStatus.activeZone    = z;
      runStatus.remainingTime = remaining;
      runStatus.manualRun     = true;
      xSemaphoreGive(statusMutex);
      vTaskDelay(pdMS_TO_TICKS(1000));
      remaining--;
    }
    RELAY_OFF(RELAY_PINS[z]);
    actualSec = dur * 60 - remaining;
  }

  allRelaysOff();
  xSemaphoreTake(statusMutex, portMAX_DELAY);
  runStatus.isRunning     = false;
  runStatus.scheduleIndex = -1;
  runStatus.activeZone    = -1;
  runStatus.remainingTime = 0;
  runStatus.manualRun     = false;
  xSemaphoreGive(statusMutex);
  if (actualSec > 0) {
    time_t ts = time(nullptr);
    int logZ[1] = {z}, logS[1] = {actualSec};
    appendRunLog(ts, "manual", logZ, logS, 1, nullptr);
    char buf[96];
    snprintf(buf, sizeof(buf), "\xe2\x9c\x85 Manual run complete \xe2\x80\x94 %s, %dm",
      boardConfig.zoneNames[z], actualSec / 60);
    telegramNotify(buf);
  }
  vTaskDelete(NULL);
}

bool startSequence(int scheduleIndex, bool manual = false) {
  xSemaphoreTake(statusMutex, portMAX_DELAY);
  bool alreadyRunning = runStatus.isRunning;
  if (!alreadyRunning) runStatus.isRunning = true; // claim slot synchronously
  xSemaphoreGive(statusMutex);

  if (alreadyRunning) return false;

  RunArgs* args = new RunArgs{scheduleIndex, manual};
  if (xTaskCreate(runSequenceTask, "sprinkler_run", 8192, args, 1, NULL) != pdPASS) {
    xSemaphoreTake(statusMutex, portMAX_DELAY);
    runStatus.isRunning = false; // revert if task spawn failed
    xSemaphoreGive(statusMutex);
    delete args;
    return false;
  }
  return true;
}

// ═══════════════════════════════════════════════════════════════
//  SCHEDULE CHECKER TASK
// ═══════════════════════════════════════════════════════════════
void scheduleCheckerTask(void* param) {
  Serial.println("[SCHED] Checker task started");

  while (true) {
    vTaskDelay(pdMS_TO_TICKS(15000)); // check every 15 seconds

    if (!isNtpSynced()) continue;
    if (!schedulingEnabled) continue;

    time_t now = time(nullptr);
    struct tm* t = localtime(&now);

    // tm_wday: 0=Sunday … 6=Saturday; we store 0=Monday … 6=Sunday
    int dayIdx = (t->tm_wday == 0) ? 6 : t->tm_wday - 1;
    int hour   = t->tm_hour;
    int minute = t->tm_min;

    for (int s = 0; s < NUM_SCHEDULES; s++) {
      xSemaphoreTake(scheduleMutex, portMAX_DELAY);
      Schedule sched = schedules[s];
      xSemaphoreGive(scheduleMutex);

      if (!sched.enabled) continue;
      if (!sched.days[dayIdx]) continue;
      if (sched.hour != hour || sched.minute != minute) continue;
      if (lastFiredDay[s] == dayIdx && lastFiredMin[s] == minute) continue;

      lastFiredDay[s] = dayIdx;
      lastFiredMin[s] = minute;

      if (skipNextScheduledRun) {
        skipNextScheduledRun = false;
        Serial.printf("[SCHED] %s skipped by user command\n", sched.name);
        appendRunLog(now, sched.name, nullptr, nullptr, 0, "user skip");
        telegramNotify("\xe2\x8f\xad Scheduled run skipped by user request.");
        break; // only need to skip once per tick
      }

      const char* skipReason = shouldSkipForWeather();
      if (skipReason) {
        xSemaphoreTake(weatherMutex, portMAX_DELAY);
        int   rainToday = weatherCache.rainProb[0];
        int   rainTomrw = weatherCache.rainProb[1];
        float minTemp   = weatherCache.loTemps[0];
        xSemaphoreGive(weatherMutex);
        Serial.printf("[SCHED] %s SKIPPED — %s (rain: %d%%, %d%%, min: %.1f°C)\n",
          sched.name, skipReason, rainToday, rainTomrw, minTemp);
        appendRunLog(now, sched.name, nullptr, nullptr, 0, skipReason);
        char buf[128];
        snprintf(buf, sizeof(buf), "\xe2\x8f\xad %s skipped \xe2\x80\x94 %s", sched.name, skipReason);
        telegramNotify(buf);
      } else {
        Serial.printf("[SCHED] Firing %s at %02d:%02d\n", sched.name, hour, minute);
        startSequence(s, false);
        break; // only one sequence can run at a time
      }
    }
  }
}

// ═══════════════════════════════════════════════════════════════
//  JSON RESPONSE HELPERS
// ═══════════════════════════════════════════════════════════════
String buildStatusJson() {
  DynamicJsonDocument doc(256);
  xSemaphoreTake(statusMutex, portMAX_DELAY);
  doc["is_running"]       = runStatus.isRunning;
  doc["schedule_index"]   = runStatus.scheduleIndex;
  doc["active_sprinkler"] = runStatus.activeZone;
  doc["remaining_time"]   = runStatus.remainingTime;
  doc["manual_run"]       = runStatus.manualRun;
  xSemaphoreGive(statusMutex);
  String out;
  serializeJson(doc, out);
  return out;
}

String buildScheduleJson() {
  DynamicJsonDocument doc(8192);
  xSemaphoreTake(scheduleMutex, portMAX_DELAY);
  doc["enabled"] = schedulingEnabled;
  JsonArray arr  = doc.createNestedArray("schedules");
  for (int s = 0; s < NUM_SCHEDULES; s++) {
    JsonObject o = arr.createNestedObject();
    o["name"]    = schedules[s].name;
    o["enabled"] = schedules[s].enabled;
    o["hour"]    = schedules[s].hour;
    o["minute"]  = schedules[s].minute;
    JsonArray daysArr = o.createNestedArray("days");
    for (int d = 0; d < 7; d++) daysArr.add(schedules[s].days[d]);
    JsonArray durs = o.createNestedArray("durations");
    for (int z = 0; z < NUM_ZONES; z++) durs.add(schedules[s].durations[z]);
  }
  xSemaphoreGive(scheduleMutex);
  String out;
  serializeJson(doc, out);
  return out;
}

String buildSystemInfoJson() {
  DynamicJsonDocument doc(512);
  time_t now = time(nullptr);
  struct tm* t = localtime(&now);
  char timeBuf[32];
  strftime(timeBuf, sizeof(timeBuf), "%Y-%m-%d %H:%M:%S", t);

  doc["current_time"]      = timeBuf;
  doc["schedule_enabled"]  = schedulingEnabled;
  doc["ip_address"]        = WiFi.localIP().toString();
  doc["hostname"]          = HOSTNAME;
  doc["num_zones"]         = NUM_ZONES;
  doc["ntp_synced"]        = isNtpSynced();
  doc["timezone"]          = boardConfig.timezone;
  doc["uptime_sec"]        = millis() / 1000;
  doc["free_heap"]         = ESP.getFreeHeap();
  doc["ssid"]              = WiFi.SSID();
  doc["rssi"]              = WiFi.RSSI();

  JsonArray pins = doc.createNestedArray("relay_pins");
  for (int i = 0; i < NUM_ZONES; i++) pins.add(RELAY_PINS[i]);

  String out;
  serializeJson(doc, out);
  return out;
}

// ═══════════════════════════════════════════════════════════════
//  STATIC FILE HELPER
// ═══════════════════════════════════════════════════════════════
void serveFile(const char* path, const char* contentType) {
  File f = LittleFS.open(path, "r");
  if (!f) { server.send(404, "text/plain", "Not found"); return; }
  server.streamFile(f, contentType);
  f.close();
}

// ═══════════════════════════════════════════════════════════════
//  TELEGRAM NOTIFICATIONS
// ═══════════════════════════════════════════════════════════════
void telegramSend(const char* text) {
  if (strlen(boardConfig.telegramToken) == 0 || strlen(boardConfig.telegramChatId) == 0) return;
  WiFiClientSecure client;
  client.setInsecure();
  HTTPClient https;
  char url[196];
  snprintf(url, sizeof(url), "https://api.telegram.org/bot%s/sendMessage",
    boardConfig.telegramToken);
  if (!https.begin(client, url)) return;
  https.addHeader("Content-Type", "application/json");
  DynamicJsonDocument body(512);
  body["chat_id"] = boardConfig.telegramChatId;
  body["text"]    = text;
  String bodyStr;
  serializeJson(body, bodyStr);
  https.POST(bodyStr);
  https.end();
}

// One-shot task wrapper — lets run tasks notify without blocking
void telegramNotifyTask(void* param) {
  char* msg = (char*)param;
  telegramSend(msg);
  free(msg);
  vTaskDelete(NULL);
}

void telegramNotify(const char* msg) {
  if (!boardConfig.telegramEnabled || strlen(boardConfig.telegramToken) == 0) return;
  char* buf = (char*)malloc(strlen(msg) + 1);
  if (!buf) return;
  strcpy(buf, msg);
  if (xTaskCreate(telegramNotifyTask, "tg_ntfy", 8192, buf, 1, NULL) != pdPASS) {
    free(buf);
  }
}

void handleTelegramStatus() {
  char buf[256];
  xSemaphoreTake(weatherMutex, portMAX_DELAY);
  bool  valid = weatherCache.valid;
  float temp  = weatherCache.currentTemp;
  int   rain  = weatherCache.rainProb[0];
  xSemaphoreGive(weatherMutex);
  xSemaphoreTake(statusMutex, portMAX_DELAY);
  bool running    = runStatus.isRunning;
  int  activeZone = runStatus.activeZone;
  int  remaining  = runStatus.remainingTime;
  xSemaphoreGive(statusMutex);

  char wxLine[64] = "Weather: unavailable";
  if (valid) {
    float disp = (boardConfig.tempUnit[0] == 'F') ? temp * 9.0f / 5.0f + 32.0f : temp;
    snprintf(wxLine, sizeof(wxLine), "\xF0\x9F\xAC\xa1 %.1f\xc2\xb0%s  Rain: %d%%",
      disp, boardConfig.tempUnit, rain);
  }
  char runLine[80] = "\xe2\x9c\x85 Idle";
  if (running && activeZone >= 0 && activeZone < NUM_ZONES) {
    snprintf(runLine, sizeof(runLine), "\xF0\x9F\x92\xA7 %s running \xe2\x80\x94 %dm left",
      boardConfig.zoneNames[activeZone], remaining / 60);
  }
  snprintf(buf, sizeof(buf), "SprinKlr-8\n%s\n%s", wxLine, runLine);
  telegramSend(buf);
}

void handleTelegramRun(const char* args) {
  int zone = -1, dur = -1;
  if (sscanf(args, "%d %d", &zone, &dur) != 2 || zone < 1 || zone > NUM_ZONES || dur < 1 || dur > 120) {
    char err[80];
    snprintf(err, sizeof(err), "Usage: /run <zone> <min>  e.g. /run 3 10  (zones 1\xe2\x80\x93%d, 1\xe2\x80\x93120 min)", NUM_ZONES);
    telegramSend(err);
    return;
  }
  xSemaphoreTake(statusMutex, portMAX_DELAY);
  bool running = runStatus.isRunning;
  xSemaphoreGive(statusMutex);
  if (running) { telegramSend("A run is already in progress. Send /stop first."); return; }
  SingleZoneArgs* a = new SingleZoneArgs{zone - 1, dur};
  xTaskCreate(runSingleZoneTask, "single_zone", 4096, a, 1, NULL);
}

void handleTelegramStop() {
  xSemaphoreTake(statusMutex, portMAX_DELAY);
  bool running = runStatus.isRunning;
  xSemaphoreGive(statusMutex);
  if (!running) { telegramSend("Nothing is running."); return; }
  stopRequested = true;
  telegramSend("\xe2\x8f\xb9 Stop signal sent.");
}

void handleTelegramSkip() {
  skipNextScheduledRun = true;
  telegramSend("\xe2\x8f\xad Next scheduled run will be skipped.");
}

void handleTelegramSchedules() {
  const char* dayAbbr[] = {"Mon","Tue","Wed","Thu","Fri","Sat","Sun"};
  char buf[640];
  int pos = snprintf(buf, sizeof(buf), "\xF0\x9F\x93\x85 Schedules (%s):\n",
    schedulingEnabled ? "on" : "PAUSED");
  for (int s = 0; s < NUM_SCHEDULES; s++) {
    xSemaphoreTake(scheduleMutex, portMAX_DELAY);
    Schedule sched = schedules[s];
    xSemaphoreGive(scheduleMutex);
    if (!sched.enabled) {
      pos += snprintf(buf + pos, sizeof(buf) - pos, "%d. %s \xe2\x80\x94 disabled\n", s + 1, sched.name);
      continue;
    }
    char dayStr[32] = ""; int dp = 0;
    for (int d = 0; d < 7; d++) if (sched.days[d]) dp += snprintf(dayStr + dp, sizeof(dayStr) - dp, "%s ", dayAbbr[d]);
    if (dp == 0) strlcpy(dayStr, "no days", sizeof(dayStr));
    int h12 = sched.hour % 12; if (h12 == 0) h12 = 12;
    const char* ampm = sched.hour >= 12 ? "PM" : "AM";
    pos += snprintf(buf + pos, sizeof(buf) - pos, "%d. %s \xe2\x80\x94 %d:%02d%s \xe2\x80\x94 %s\n",
      s + 1, sched.name, h12, sched.minute, ampm, dayStr);
  }
  telegramSend(buf);
}

void handleTelegramWeatherCmd() {
  xSemaphoreTake(weatherMutex, portMAX_DELAY);
  bool  valid = weatherCache.valid;
  float temp  = weatherCache.currentTemp;
  int   rain  = weatherCache.rainProb[0];
  float et0   = weatherCache.et0[0];
  xSemaphoreGive(weatherMutex);
  if (!valid) { telegramSend("No weather data yet. Set location in Settings."); return; }
  float disp = (boardConfig.tempUnit[0] == 'F') ? temp * 9.0f / 5.0f + 32.0f : temp;
  char buf[256];
  int pos = snprintf(buf, sizeof(buf), "\xF0\x9F\x8C\xa4 %.1f\xc2\xb0%s  Rain: %d%%\n\xF0\x9F\x92\xa7 ET\xe2\x82\x80 today: %.1fmm",
    disp, boardConfig.tempUnit, rain, et0);
  if (boardConfig.etScalingEnabled && et0 > 0.0f && boardConfig.etBaseline > 0.0f) {
    float mult = constrain(et0 / boardConfig.etBaseline, 0.5f, 2.0f);
    snprintf(buf + pos, sizeof(buf) - pos, " \xe2\x86\x92 %.0f%% duration", mult * 100.0f);
  }
  telegramSend(buf);
}

void handleTelegramNext() {
  if (!schedulingEnabled) { telegramSend("Scheduling is disabled."); return; }
  time_t now = time(nullptr);
  struct tm* t = localtime(&now);
  int curDay  = (t->tm_wday == 0) ? 6 : t->tm_wday - 1;
  int curHour = t->tm_hour;
  int curMin  = t->tm_min;
  const char* dayNames[] = {"Monday","Tuesday","Wednesday","Thursday","Friday","Saturday","Sunday"};

  int bestOffset = 999, bestSched = -1, bestDay = -1;
  for (int s = 0; s < NUM_SCHEDULES; s++) {
    xSemaphoreTake(scheduleMutex, portMAX_DELAY);
    Schedule sched = schedules[s];
    xSemaphoreGive(scheduleMutex);
    if (!sched.enabled) continue;
    for (int offset = 0; offset < 7; offset++) {
      int d = (curDay + offset) % 7;
      if (!sched.days[d]) continue;
      if (offset == 0) {
        if (sched.hour < curHour || (sched.hour == curHour && sched.minute <= curMin)) continue;
      }
      if (offset < bestOffset || (offset == bestOffset && bestSched >= 0 &&
          (sched.hour < schedules[bestSched].hour ||
           (sched.hour == schedules[bestSched].hour && sched.minute < schedules[bestSched].minute)))) {
        bestOffset = offset; bestSched = s; bestDay = d;
      }
      break;
    }
  }
  if (bestSched < 0) { telegramSend("No upcoming scheduled runs."); return; }
  xSemaphoreTake(scheduleMutex, portMAX_DELAY);
  Schedule sched = schedules[bestSched];
  xSemaphoreGive(scheduleMutex);
  int h12 = sched.hour % 12; if (h12 == 0) h12 = 12;
  const char* ampm = sched.hour >= 12 ? "PM" : "AM";
  char buf[128];
  if (bestOffset == 0)
    snprintf(buf, sizeof(buf), "\xF0\x9F\x93\x85 Next: %s at %d:%02d%s (today)", sched.name, h12, sched.minute, ampm);
  else if (bestOffset == 1)
    snprintf(buf, sizeof(buf), "\xF0\x9F\x93\x85 Next: %s at %d:%02d%s (tomorrow, %s)", sched.name, h12, sched.minute, ampm, dayNames[bestDay]);
  else
    snprintf(buf, sizeof(buf), "\xF0\x9F\x93\x85 Next: %s at %d:%02d%s (%s)", sched.name, h12, sched.minute, ampm, dayNames[bestDay]);
  telegramSend(buf);
}

void handleTelegramLog() {
  if (!LittleFS.exists(RUN_LOG_FILE)) { telegramSend("No run history yet."); return; }
  File f = LittleFS.open(RUN_LOG_FILE, "r");
  if (!f) { telegramSend("Could not read history."); return; }
  DynamicJsonDocument doc(8192);
  deserializeJson(doc, f);
  f.close();
  JsonArray arr = doc.as<JsonArray>();
  int n = arr.size();
  if (n == 0) { telegramSend("No run history yet."); return; }
  char buf[512];
  int pos = snprintf(buf, sizeof(buf), "\xF0\x9F\x93\x8b Recent runs:\n");
  int start = max(0, n - 3);
  for (int i = start; i < n; i++) {
    JsonObject entry = arr[i];
    time_t ts = entry["ts"].as<long>();
    struct tm* tm_ = localtime(&ts);
    const char* trigger  = entry["trigger"] | "?";
    const char* skipStr  = entry["skip"]    | "";
    char timeBuf[20];
    strftime(timeBuf, sizeof(timeBuf), "%b %d %H:%M", tm_);
    if (strlen(skipStr) > 0) {
      pos += snprintf(buf + pos, sizeof(buf) - pos, "%s \xe2\x80\x94 skipped (%s)\n", timeBuf, skipStr);
    } else {
      int totalSec = 0;
      for (JsonObject z : entry["zones"].as<JsonArray>()) totalSec += z["sec"].as<int>();
      pos += snprintf(buf + pos, sizeof(buf) - pos, "%s \xe2\x80\x94 %s \xe2\x80\x94 %dm\n", timeBuf, trigger, totalSec / 60);
    }
  }
  telegramSend(buf);
}

void handleTelegramZones() {
  char buf[384];
  int pos = snprintf(buf, sizeof(buf), "\xF0\x9F\x92\xa7 Zones:\n");
  for (int z = 0; z < NUM_ZONES; z++)
    pos += snprintf(buf + pos, sizeof(buf) - pos, "%d. %s\n", z + 1, boardConfig.zoneNames[z]);
  telegramSend(buf);
}

void handleTelegramRunScheduleCmd(const char* args) {
  int schedNum = atoi(args);
  if (schedNum < 1 || schedNum > NUM_SCHEDULES) {
    char err[80];
    snprintf(err, sizeof(err), "Usage: /schedule 1\xe2\x80\x93%d", NUM_SCHEDULES);
    telegramSend(err);
    return;
  }
  int s = schedNum - 1;
  xSemaphoreTake(statusMutex, portMAX_DELAY);
  bool running = runStatus.isRunning;
  xSemaphoreGive(statusMutex);
  if (running) { telegramSend("A run is already in progress. Send /stop first."); return; }
  xSemaphoreTake(scheduleMutex, portMAX_DELAY);
  bool hasZones = false;
  for (int z = 0; z < NUM_ZONES; z++) if (schedules[s].durations[z] > 0) { hasZones = true; break; }
  xSemaphoreGive(scheduleMutex);
  if (!hasZones) { telegramSend("That schedule has no zones configured."); return; }
  startSequence(s, true);
}

void handleTelegramCommand(const char* text) {
  if (strncmp(text, "/status", 7) == 0)       { handleTelegramStatus(); }
  else if (strncmp(text, "/run ", 5) == 0)    { handleTelegramRun(text + 5); }
  else if (strncmp(text, "/stop", 5) == 0)    { handleTelegramStop(); }
  else if (strncmp(text, "/skip", 5) == 0)    { handleTelegramSkip(); }
  else if (strncmp(text, "/schedules", 10) == 0) { handleTelegramSchedules(); }
  else if (strncmp(text, "/schedule ", 10) == 0) { handleTelegramRunScheduleCmd(text + 10); }
  else if (strncmp(text, "/weather", 8) == 0) { handleTelegramWeatherCmd(); }
  else if (strncmp(text, "/next", 5) == 0)    { handleTelegramNext(); }
  else if (strncmp(text, "/log", 4) == 0)     { handleTelegramLog(); }
  else if (strncmp(text, "/zones", 6) == 0)   { handleTelegramZones(); }
  else if (strncmp(text, "/pause", 6) == 0)   { skipNextScheduledRun = true;  telegramSend("\xe2\x8f\xb8 Scheduling paused for next run."); }
  else if (strncmp(text, "/resume", 7) == 0)  { skipNextScheduledRun = false; telegramSend("\xe2\x96\xb6 Scheduling resumed."); }
  else if (strncmp(text, "/help", 5) == 0) {
    telegramSend(
      "SprinKlr-8 Commands:\n"
      "/status \xe2\x80\x94 weather + run state\n"
      "/run <zone> <min> \xe2\x80\x94 run a zone\n"
      "/schedule 1\xe2\x80\x934 \xe2\x80\x94 start a schedule\n"
      "/schedules \xe2\x80\x94 list all schedules\n"
      "/weather \xe2\x80\x94 conditions + ET0\n"
      "/next \xe2\x80\x94 next scheduled run\n"
      "/log \xe2\x80\x94 last 3 runs\n"
      "/zones \xe2\x80\x94 zone names\n"
      "/pause \xe2\x80\x94 skip next run\n"
      "/resume \xe2\x80\x94 resume scheduling\n"
      "/stop \xe2\x80\x94 stop current run\n"
      "/help \xe2\x80\x94 this list"
    );
  }
  else { telegramSend("Unknown command. Send /help for the list."); }
}

void telegramTask(void* param) {
  long lastUpdateId = -1;
  Serial.println("[TG] Telegram task started");

  while (true) {
    if (!boardConfig.telegramEnabled || strlen(boardConfig.telegramToken) == 0) {
      vTaskDelay(pdMS_TO_TICKS(5000));
      continue;
    }

    WiFiClientSecure client;
    client.setInsecure();
    HTTPClient https;
    char url[256];
    snprintf(url, sizeof(url),
      "https://api.telegram.org/bot%s/getUpdates?timeout=25&offset=%ld",
      boardConfig.telegramToken, lastUpdateId + 1);

    if (!https.begin(client, url)) {
      vTaskDelay(pdMS_TO_TICKS(5000));
      continue;
    }
    https.setTimeout(30000);
    int code = https.GET();
    if (code != 200) {
      https.end();
      Serial.printf("[TG] getUpdates HTTP %d\n", code);
      vTaskDelay(pdMS_TO_TICKS(10000));
      continue;
    }

    String body = https.getString();
    https.end();

    DynamicJsonDocument doc(4096);
    if (deserializeJson(doc, body) != DeserializationError::Ok) continue;
    if (!doc["ok"].as<bool>()) continue;

    JsonArray results = doc["result"].as<JsonArray>();
    for (JsonObject update : results) {
      lastUpdateId = update["update_id"].as<long>();
      if (!update.containsKey("message")) continue;
      JsonObject msg = update["message"].as<JsonObject>();
      String chatId = msg["chat"]["id"].as<String>();
      if (chatId != String(boardConfig.telegramChatId)) continue;
      const char* text = msg["text"] | "";
      if (strlen(text) > 0) {
        Serial.printf("[TG] cmd from %s: %s\n", chatId.c_str(), text);
        handleTelegramCommand(text);
      }
    }
  }
}

// ═══════════════════════════════════════════════════════════════
//  WEB SERVER ROUTES
// ═══════════════════════════════════════════════════════════════
void setupRoutes() {

  // ── Serve frontend (embedded in firmware — no LittleFS needed) ─
  server.on("/", HTTP_GET, []() {
    server.send_P(200, "text/html", INDEX_HTML);
  });
  server.on("/index.html", HTTP_GET, []() {
    server.send_P(200, "text/html", INDEX_HTML);
  });

  // ── GET /api/status ───────────────────────────────────────────
  server.on("/api/status", HTTP_GET, []() {
    server.send(200, "application/json", buildStatusJson());
  });

  // ── GET /api/schedule ─────────────────────────────────────────
  server.on("/api/schedule", HTTP_GET, []() {
    server.send(200, "application/json", buildScheduleJson());
  });

  // ── POST /api/schedule ────────────────────────────────────────
  server.on("/api/schedule", HTTP_POST, []() {
    if (!server.hasArg("plain")) {
      server.send(400, "application/json", "{\"error\":\"No body\"}");
      return;
    }
    DynamicJsonDocument doc(8192);
    DeserializationError err = deserializeJson(doc, server.arg("plain"));
    if (err) {
      server.send(400, "application/json", "{\"error\":\"Invalid JSON\"}");
      return;
    }

    xSemaphoreTake(scheduleMutex, portMAX_DELAY);
    if (doc.containsKey("enabled")) schedulingEnabled = doc["enabled"].as<bool>();
    JsonArray arr = doc["schedules"].as<JsonArray>();
    for (int s = 0; s < NUM_SCHEDULES && s < (int)arr.size(); s++) {
      JsonObject o = arr[s];
      const char* nm = o["name"] | "";
      if (strlen(nm) > 0) strlcpy(schedules[s].name, nm, sizeof(schedules[s].name));
      schedules[s].enabled = o["enabled"] | schedules[s].enabled;
      if (o.containsKey("hour"))   schedules[s].hour   = (int)o["hour"];
      if (o.containsKey("minute")) schedules[s].minute = (int)o["minute"];
      JsonArray daysArr = o["days"].as<JsonArray>();
      for (int d = 0; d < 7 && d < (int)daysArr.size(); d++)
        schedules[s].days[d] = daysArr[d].as<bool>();
      JsonArray durs = o["durations"].as<JsonArray>();
      for (int z = 0; z < NUM_ZONES && z < (int)durs.size(); z++)
        schedules[s].durations[z] = (int)durs[z];
    }
    xSemaphoreGive(scheduleMutex);

    saveSchedule();
    server.send(200, "application/json", "{\"message\":\"Schedule updated\"}");
  });

  // ── POST /api/run_schedule  body: {"schedule": 0-3} ─────────
  server.on("/api/run_schedule", HTTP_POST, []() {
    if (!server.hasArg("plain")) {
      server.send(400, "application/json", "{\"error\":\"No body\"}");
      return;
    }
    DynamicJsonDocument doc(64);
    deserializeJson(doc, server.arg("plain"));
    int schedIdx = doc["schedule"] | -1;
    if (schedIdx < 0 || schedIdx >= NUM_SCHEDULES) {
      server.send(400, "application/json", "{\"error\":\"schedule must be 0-3\"}");
      return;
    }
    if (startSequence(schedIdx, true)) {
      server.send(200, "application/json", "{\"message\":\"Sequence started\"}");
    } else {
      server.send(409, "application/json", "{\"error\":\"A sequence is already running\"}");
    }
  });

  // ── POST /api/run_zone  body: {"zone": 0-7, "duration": 1-120} ─
  server.on("/api/run_zone", HTTP_POST, []() {
    if (!server.hasArg("plain")) {
      server.send(400, "application/json", "{\"error\":\"No body\"}");
      return;
    }
    DynamicJsonDocument doc(64);
    deserializeJson(doc, server.arg("plain"));
    int zoneIndex   = doc["zone"]     | -1;
    int durationMin = doc["duration"] | -1;

    xSemaphoreTake(statusMutex, portMAX_DELAY);
    bool running = runStatus.isRunning;
    xSemaphoreGive(statusMutex);

    if (running) {
      server.send(409, "application/json", "{\"error\":\"A sequence is already running\"}");
      return;
    }
    if (zoneIndex < 0 || zoneIndex >= NUM_ZONES) {
      server.send(400, "application/json", "{\"error\":\"Invalid zone index\"}");
      return;
    }
    if (durationMin < 1 || durationMin > 120) {
      server.send(400, "application/json", "{\"error\":\"Duration must be 1-120 minutes\"}");
      return;
    }

    SingleZoneArgs* args = new SingleZoneArgs{zoneIndex, durationMin};
    xTaskCreate(runSingleZoneTask, "single_zone", 4096, args, 1, NULL);

    server.send(200, "application/json", "{\"message\":\"Zone started\"}");
  });

  // ── POST /api/stop_sequence ───────────────────────────────────
  server.on("/api/stop_sequence", HTTP_POST, []() {
    xSemaphoreTake(statusMutex, portMAX_DELAY);
    bool running = runStatus.isRunning;
    xSemaphoreGive(statusMutex);

    if (!running) {
      server.send(400, "application/json", "{\"error\":\"No sequence is currently running\"}");
      return;
    }
    stopRequested = true;
    server.send(200, "application/json", "{\"message\":\"Stop signal sent\"}");
  });

  // ── POST /api/toggle_schedule ─────────────────────────────────
  server.on("/api/toggle_schedule", HTTP_POST, []() {
    xSemaphoreTake(scheduleMutex, portMAX_DELAY);
    schedulingEnabled = !schedulingEnabled;
    bool newState = schedulingEnabled;
    xSemaphoreGive(scheduleMutex);

    saveSchedule();
    String resp = "{\"enabled\":" + String(newState ? "true" : "false") + "}";
    server.send(200, "application/json", resp);
  });

  // ── GET /api/get_time ─────────────────────────────────────────
  server.on("/api/get_time", HTTP_GET, []() {
    time_t now = time(nullptr);
    struct tm* t = localtime(&now);
    char buf[32];
    strftime(buf, sizeof(buf), "%Y-%m-%d %H:%M:%S", t);
    String resp = "{\"time\":\"" + String(buf) + "\",\"ntp_synced\":" +
                  String(isNtpSynced() ? "true" : "false") + "}";
    server.send(200, "application/json", resp);
  });

  // ── GET /api/config ───────────────────────────────────────────
  server.on("/api/config", HTTP_GET, []() {
    DynamicJsonDocument doc(2048);
    doc["timezone"]               = boardConfig.timezone;
    doc["latitude"]               = boardConfig.latitude;
    doc["longitude"]              = boardConfig.longitude;
    doc["weather_enabled"]        = boardConfig.weatherEnabled;
    doc["rain_threshold"]         = boardConfig.rainThreshold;
    doc["freeze_threshold"]       = boardConfig.freezeThreshold;
    doc["cycle_and_soak_enabled"] = boardConfig.cycleAndSoakEnabled;
    doc["cycle_time"]             = boardConfig.cycleTime;
    doc["temp_unit"]              = boardConfig.tempUnit;
    { JsonArray zn = doc.createNestedArray("zone_names"); for (int i = 0; i < 8; i++) zn.add(boardConfig.zoneNames[i]); }
    doc["telegram_enabled"]   = boardConfig.telegramEnabled;
    doc["telegram_token"]     = boardConfig.telegramToken;
    doc["telegram_chat_id"]   = boardConfig.telegramChatId;
    doc["et_scaling_enabled"] = boardConfig.etScalingEnabled;
    doc["et_baseline"]        = boardConfig.etBaseline;
    String out; serializeJson(doc, out);
    server.send(200, "application/json", out);
  });

  // ── POST /api/config  body: {"timezone":"EST5EDT,M3.2.0,M11.1.0"} ──
  server.on("/api/config", HTTP_POST, []() {
    if (!server.hasArg("plain")) { server.send(400, "application/json", "{\"error\":\"No body\"}"); return; }
    DynamicJsonDocument doc(2048);
    if (deserializeJson(doc, server.arg("plain")) != DeserializationError::Ok) {
      server.send(400, "application/json", "{\"error\":\"Invalid JSON\"}"); return;
    }
    if (doc.containsKey("timezone")) {
      const char* tz = doc["timezone"];
      if (!tz || strlen(tz) == 0 || strlen(tz) >= sizeof(boardConfig.timezone)) {
        server.send(400, "application/json", "{\"error\":\"Invalid timezone\"}"); return;
      }
      strlcpy(boardConfig.timezone, tz, sizeof(boardConfig.timezone));
      applyTimezone();
    }
    if (doc.containsKey("latitude"))              boardConfig.latitude            = doc["latitude"].as<float>();
    if (doc.containsKey("longitude"))             boardConfig.longitude           = doc["longitude"].as<float>();
    if (doc.containsKey("weather_enabled"))       boardConfig.weatherEnabled      = doc["weather_enabled"].as<bool>();
    if (doc.containsKey("rain_threshold"))        boardConfig.rainThreshold       = doc["rain_threshold"].as<int>();
    if (doc.containsKey("freeze_threshold"))      boardConfig.freezeThreshold     = doc["freeze_threshold"].as<float>();
    if (doc.containsKey("cycle_and_soak_enabled")) boardConfig.cycleAndSoakEnabled = doc["cycle_and_soak_enabled"].as<bool>();
    if (doc.containsKey("cycle_time"))            boardConfig.cycleTime           = doc["cycle_time"].as<int>();
    if (doc.containsKey("temp_unit")) {
      const char* tu = doc["temp_unit"].as<const char*>();
      if (tu) strlcpy(boardConfig.tempUnit, (tu[0]=='F' ? "F" : "C"), sizeof(boardConfig.tempUnit));
    }
    if (doc.containsKey("zone_names")) {
      JsonArray zn = doc["zone_names"].as<JsonArray>();
      for (int i = 0; i < 8 && i < (int)zn.size(); i++) {
        const char* n = zn[i].as<const char*>();
        if (n) strlcpy(boardConfig.zoneNames[i], n, sizeof(boardConfig.zoneNames[i]));
      }
    }
    if (doc.containsKey("telegram_enabled")) boardConfig.telegramEnabled = doc["telegram_enabled"].as<bool>();
    if (doc.containsKey("telegram_token")) {
      const char* v = doc["telegram_token"].as<const char*>();
      if (v) strlcpy(boardConfig.telegramToken, v, sizeof(boardConfig.telegramToken));
    }
    if (doc.containsKey("telegram_chat_id")) {
      const char* v = doc["telegram_chat_id"].as<const char*>();
      if (v) strlcpy(boardConfig.telegramChatId, v, sizeof(boardConfig.telegramChatId));
    }
    if (doc.containsKey("et_scaling_enabled")) boardConfig.etScalingEnabled = doc["et_scaling_enabled"].as<bool>();
    if (doc.containsKey("et_baseline"))        boardConfig.etBaseline       = doc["et_baseline"].as<float>();
    // Notify weatherTask to refetch immediately when location or skip toggle changes
    bool locationChanged = doc.containsKey("latitude") || doc.containsKey("longitude") || doc.containsKey("weather_enabled");
    saveConfig();
    if (locationChanged && weatherTaskHandle) {
      xTaskNotify(weatherTaskHandle, 0, eNoAction);
    }
    server.send(200, "application/json", "{\"message\":\"Config saved\"}");
  });

  // ── GET /api/system_info ──────────────────────────────────────
  server.on("/api/system_info", HTTP_GET, []() {
    server.send(200, "application/json", buildSystemInfoJson());
  });

  // ── GET /api/weather ──────────────────────────────────────────
  server.on("/api/weather", HTTP_GET, []() {
    DynamicJsonDocument doc(1024);
    xSemaphoreTake(weatherMutex, portMAX_DELAY);
    doc["valid"]              = weatherCache.valid;
    doc["current_temp"]       = weatherCache.currentTemp;
    doc["weather_code"]       = weatherCache.currentCode;
    doc["min_temp_today"]     = weatherCache.loTemps[0];
    doc["rain_prob_today"]    = weatherCache.rainProb[0];
    doc["rain_prob_tomorrow"] = weatherCache.rainProb[1];
    doc["fetched_ago_sec"]    = weatherCache.valid ? (long)((millis() - weatherCache.fetchedAt) / 1000) : -1;
    doc["et0_today"] = weatherCache.et0[0];
    JsonArray forecast = doc.createNestedArray("forecast");
    for (int i = 0; i < 5; i++) {
      JsonObject day = forecast.createNestedObject();
      day["hi"]   = weatherCache.hiTemps[i];
      day["lo"]   = weatherCache.loTemps[i];
      day["rain"] = weatherCache.rainProb[i];
      day["code"] = weatherCache.codes[i];
      day["et0"]  = weatherCache.et0[i];
    }
    xSemaphoreGive(weatherMutex);
    doc["weather_enabled"]    = boardConfig.weatherEnabled;
    doc["rain_threshold"]     = boardConfig.rainThreshold;
    doc["freeze_threshold"]   = boardConfig.freezeThreshold;
    doc["temp_unit"]          = boardConfig.tempUnit;
    doc["et_scaling_enabled"] = boardConfig.etScalingEnabled;
    doc["et_baseline"]        = boardConfig.etBaseline;
    String out; serializeJson(doc, out);
    server.send(200, "application/json", out);
  });

  // ── GET /api/history ─────────────────────────────────────────
  server.on("/api/history", HTTP_GET, []() {
    if (!LittleFS.exists(RUN_LOG_FILE)) {
      server.send(200, "application/json", "[]");
      return;
    }
    File f = LittleFS.open(RUN_LOG_FILE, "r");
    if (!f) { server.send(200, "application/json", "[]"); return; }
    server.streamFile(f, "application/json");
    f.close();
  });

  // ── POST /api/relay_test  body: {"zone": 0-7, "state": 0|1} ──
  server.on("/api/relay_test", HTTP_POST, []() {
    if (!server.hasArg("plain")) {
      server.send(400, "application/json", "{\"error\":\"No body\"}");
      return;
    }
    DynamicJsonDocument doc(64);
    deserializeJson(doc, server.arg("plain"));
    int zone  = doc["zone"]  | -1;
    int state = doc["state"] | -1;

    xSemaphoreTake(statusMutex, portMAX_DELAY);
    bool running = runStatus.isRunning;
    xSemaphoreGive(statusMutex);

    if (running) {
      server.send(409, "application/json", "{\"error\":\"Cannot test while sequence running\"}");
      return;
    }
    if (zone < 0 || zone >= NUM_ZONES) {
      server.send(400, "application/json", "{\"error\":\"Invalid zone\"}");
      return;
    }
    if (state == 1) {
      RELAY_ON(RELAY_PINS[zone]);
    } else {
      RELAY_OFF(RELAY_PINS[zone]);
    }
    String resp = "{\"zone\":" + String(zone) + ",\"state\":" + String(state) + "}";
    server.send(200, "application/json", resp);
  });

  // ── PWA static files (embedded in firmware — no LittleFS needed) ─
  server.on("/manifest.json", HTTP_GET, []() { server.send_P(200, "application/manifest+json", MANIFEST_JSON); });
  server.on("/sw.js",         HTTP_GET, []() { server.send_P(200, "application/javascript",    SW_JS); });
  server.on("/icon-192.png",  HTTP_GET, []() { server.send_P(200, "image/png", (const char*)ICON_192_PNG, sizeof(ICON_192_PNG)); });
  server.on("/icon-512.png",  HTTP_GET, []() { server.send_P(200, "image/png", (const char*)ICON_512_PNG, sizeof(ICON_512_PNG)); });

  // ── POST /api/telegram_test ───────────────────────────────────
  server.on("/api/telegram_test", HTTP_POST, []() {
    if (!boardConfig.telegramEnabled || strlen(boardConfig.telegramToken) == 0) {
      server.send(400, "application/json", "{\"error\":\"Telegram not configured\"}");
      return;
    }
    telegramSend("SprinKlr connected \xe2\x9c\x85 \xe2\x80\x94 Telegram notifications are working.");
    server.send(200, "application/json", "{\"message\":\"Test message sent\"}");
  });

  // ── 404 handler ───────────────────────────────────────────────
  server.onNotFound([]() {
    server.send(404, "application/json", "{\"error\":\"Not found\"}");
  });
}

// ═══════════════════════════════════════════════════════════════
//  ARDUINO OTA — firmware updates over WiFi from Arduino IDE
// ═══════════════════════════════════════════════════════════════
void setupOTA() {
  ArduinoOTA.setHostname(HOSTNAME);
  ArduinoOTA.setPassword(OTA_PASSWORD);

  ArduinoOTA.onStart([]() {
    String type = (ArduinoOTA.getCommand() == U_FLASH) ? "firmware" : "filesystem";
    Serial.printf("[OTA] Starting %s update...\n", type.c_str());
    allRelaysOff(); // Safety: kill all relays before flashing
  });
  ArduinoOTA.onEnd([]()   { Serial.println("[OTA] Update complete — rebooting"); });
  ArduinoOTA.onProgress([](unsigned int progress, unsigned int total) {
    Serial.printf("[OTA] Progress: %u%%\r", progress * 100 / total);
  });
  ArduinoOTA.onError([](ota_error_t error) {
    Serial.printf("[OTA] Error[%u]: ", error);
    if      (error == OTA_AUTH_ERROR)    Serial.println("Auth failed");
    else if (error == OTA_BEGIN_ERROR)   Serial.println("Begin failed");
    else if (error == OTA_CONNECT_ERROR) Serial.println("Connect failed");
    else if (error == OTA_RECEIVE_ERROR) Serial.println("Receive failed");
    else if (error == OTA_END_ERROR)     Serial.println("End failed");
  });

  ArduinoOTA.begin();
  Serial.printf("[OTA] Arduino OTA ready — hostname: %s\n", HOSTNAME);
}

// ═══════════════════════════════════════════════════════════════
//  CLOUD UPDATE — fetch firmware .bin or index.html from GitHub
// ═══════════════════════════════════════════════════════════════
void setupCloudUpdateRoutes() {

  // ── GET /api/version — return current firmware version ───────
  server.on("/api/version", HTTP_GET, []() {
    String resp = "{\"version\":\"" + String(FW_VERSION) + "\"}";
    server.send(200, "application/json", resp);
  });

  // ── POST /api/update/firmware — pull .bin from GitHub releases and flash ─
  server.on("/api/update/firmware", HTTP_POST, []() {
    Serial.printf("[CLOUD] Resolving redirects for: %s\n", CLOUD_FW_URL);

    // Step 1 — follow redirect chain until we reach the real CDN URL
    String finalUrl = CLOUD_FW_URL;
    for (int hop = 0; hop < 5; hop++) {
      WiFiClientSecure rc;
      rc.setInsecure();
      HTTPClient rh;
      const char* hdrs[] = {"Location"};
      rh.collectHeaders(hdrs, 1);
      rh.setFollowRedirects(HTTPC_DISABLE_FOLLOW_REDIRECTS);
      rh.addHeader("User-Agent", "ESP32-Sprinkler");
      rh.begin(rc, finalUrl);
      int code = rh.GET();
      String loc = rh.header("Location");
      rh.end();
      Serial.printf("[CLOUD] Hop %d: code=%d  url=%s\n", hop + 1, code, finalUrl.c_str());
      if ((code == 301 || code == 302 || code == 303 || code == 307) && !loc.isEmpty()) {
        finalUrl = loc;
      } else {
        break; // reached final destination or error
      }
    }

    Serial.printf("[CLOUD] Resolved URL: %s\n", finalUrl.c_str());

    if (finalUrl == CLOUD_FW_URL) {
      Serial.println("[CLOUD] Could not resolve redirect URL");
      return;
    }

    // Send response BEFORE flashing — board reboots and can't reply after
    server.send(200, "application/json",
      "{\"message\":\"Firmware update started — board will reboot when done\"}");
    delay(500);

    allRelaysOff(); // Safety: kill all relays before flashing

    // Step 2 — flash from real CDN URL
    WiFiClientSecure client;
    client.setInsecure();
    httpUpdate.setLedPin(STATUS_LED_PIN, HIGH);
    httpUpdate.rebootOnUpdate(true);

    t_httpUpdate_return ret = httpUpdate.update(client, finalUrl);
    // Only reached if update failed
    switch (ret) {
      case HTTP_UPDATE_FAILED:
        Serial.printf("[CLOUD] Firmware update failed: %s\n",
          httpUpdate.getLastErrorString().c_str());
        break;
      case HTTP_UPDATE_NO_UPDATES:
        Serial.println("[CLOUD] No update available");
        break;
      default:
        break;
    }
  });
}

// ═══════════════════════════════════════════════════════════════
//  WEB UI UPLOAD — browser-based index.html update via /upload
// ═══════════════════════════════════════════════════════════════
void setupUploadRoutes() {

  // Upload page — simple HTML form
  server.on("/upload", HTTP_GET, []() {
    String html = R"(<!DOCTYPE html><html><head>
<meta name="viewport" content="width=device-width,initial-scale=1">
<title>Upload UI</title>
<style>
  body{font-family:sans-serif;background:#1a1a2e;color:#eee;display:flex;
       flex-direction:column;align-items:center;justify-content:center;min-height:100vh;margin:0}
  h2{color:#4fc3f7;margin-bottom:24px}
  form{background:#16213e;padding:24px;border-radius:12px;display:flex;flex-direction:column;gap:16px;min-width:300px}
  label{font-size:0.85rem;color:#90caf9}
  input[type=file]{color:#eee}
  input[type=password]{padding:8px;border-radius:6px;border:1px solid #0f3460;
                        background:#0f3460;color:#eee;font-size:1rem}
  button{padding:10px;background:#4fc3f7;color:#000;border:none;border-radius:8px;
         font-size:1rem;font-weight:bold;cursor:pointer}
  button:hover{background:#81d4fa}
  #msg{margin-top:16px;font-size:0.9rem}
</style></head><body>
<h2>Upload New UI</h2>
<form method="POST" action="/upload" enctype="multipart/form-data">
  <label>Password</label>
  <input type="password" name="password" placeholder="Enter OTA password" required>
  <label>Select index.html</label>
  <input type="file" name="file" accept=".html" required>
  <button type="submit">Upload</button>
</form>
<div id="msg"></div>
</body></html>)";
    server.send(200, "text/html", html);
  });

  // Handle the file upload POST
  static bool uploadAuthorised = false;
  static File uploadFile;

  server.on("/upload", HTTP_POST,
    // Response handler (runs after upload completes)
    []() {
      if (!uploadAuthorised) {
        server.send(403, "text/plain", "Wrong password");
        return;
      }
      server.send(200, "text/html",
        "<html><body style='font-family:sans-serif;background:#1a1a2e;color:#eee;"
        "display:flex;align-items:center;justify-content:center;min-height:100vh'>"
        "<div style='text-align:center'><h2 style='color:#4caf50'>Upload complete!</h2>"
        "<p>New UI is live. <a href='/' style='color:#4fc3f7'>Go to dashboard</a></p>"
        "</div></body></html>");
      uploadAuthorised = false;
    },
    // Upload handler (runs as data arrives)
    [&uploadFile, &uploadAuthorised]() {
      HTTPUpload& upload = server.upload();

      if (upload.status == UPLOAD_FILE_START) {
        // Check password field sent alongside the file
        uploadAuthorised = (server.arg("password") == OTA_PASSWORD);
        if (!uploadAuthorised) {
          Serial.println("[UPLOAD] Wrong password — rejecting");
          return;
        }
        Serial.printf("[UPLOAD] Receiving: %s\n", upload.filename.c_str());
        uploadFile = LittleFS.open("/index.html", "w");
        if (!uploadFile) Serial.println("[UPLOAD] Failed to open file for writing");
      }
      else if (upload.status == UPLOAD_FILE_WRITE && uploadAuthorised) {
        if (uploadFile) uploadFile.write(upload.buf, upload.currentSize);
      }
      else if (upload.status == UPLOAD_FILE_END && uploadAuthorised) {
        if (uploadFile) {
          uploadFile.close();
          Serial.printf("[UPLOAD] Done — %u bytes written to /index.html\n", upload.totalSize);
        }
      }
    }
  );
}

// ═══════════════════════════════════════════════════════════════
//  WIFI RESET CHECK — hold IO0 button for 3 s at boot to wipe
//  saved WiFi credentials and force the setup portal to open
// ═══════════════════════════════════════════════════════════════
void checkWiFiReset() {
  pinMode(WIFI_RESET_PIN, INPUT_PULLUP);
  Serial.println("[WIFI-RESET] Press and hold IO0 within 2 seconds to reset WiFi...");

  // 2-second window for user to press IO0
  unsigned long window = millis();
  bool pressed = false;
  while (millis() - window < 2000) {
    if (digitalRead(WIFI_RESET_PIN) == LOW) {
      pressed = true;
      break;
    }
    delay(50);
  }

  if (!pressed) {
    Serial.println("[WIFI-RESET] IO0 not pressed — booting normally");
    return;
  }

  // IO0 pressed — now require 3-second hold to confirm
  Serial.println("[WIFI-RESET] IO0 detected — keep holding for 3 seconds to wipe WiFi...");
  unsigned long start = millis();
  int lastSecond = -1;

  while (millis() - start < 3000) {
    int elapsed = (millis() - start) / 1000;
    if (elapsed != lastSecond) {
      lastSecond = elapsed;
      Serial.printf("[WIFI-RESET] Holding... %d/3 seconds\n", elapsed + 1);
    }
    if (digitalRead(WIFI_RESET_PIN) == HIGH) {
      Serial.println("[WIFI-RESET] IO0 released early — reset CANCELLED, booting normally");
      return;
    }
    digitalWrite(STATUS_LED_PIN, !digitalRead(STATUS_LED_PIN));
    delay(100);
  }

  // Still held after 3 s — wipe credentials
  Serial.println("[WIFI-RESET] 3 seconds confirmed — wiping WiFi credentials...");
  WiFiManager wm;
  wm.resetSettings();
  Serial.println("[WIFI-RESET] Done. WiFi credentials cleared.");
  Serial.println("[WIFI-RESET] Board will now open 'SprinklerSetup' hotspot.");
  for (int i = 0; i < 10; i++) {
    digitalWrite(STATUS_LED_PIN, !digitalRead(STATUS_LED_PIN));
    delay(80);
  }
}

// ═══════════════════════════════════════════════════════════════
//  WIFI SETUP (WiFiManager captive portal)
// ═══════════════════════════════════════════════════════════════
void setupWiFi() {
  WiFi.setHostname(HOSTNAME);

  // Check if we already have saved credentials (returning user)
  WiFi.mode(WIFI_STA);
  bool hasCredentials = (WiFi.SSID().length() > 0);

  if (!hasCredentials) {
    // ── First-time setup instructions ──────────────────────────
    Serial.println("");
    Serial.println("================================================");
    Serial.println("  SprinKlr-8 — First Time Setup");
    Serial.println("================================================");
    Serial.println("");
    Serial.println("  The board has opened a temporary WiFi hotspot.");
    Serial.println("");
    Serial.println("  STEP 1: On your phone go to Settings > WiFi");
    Serial.println("          and connect to this network:");
    Serial.println("          Name     : SprinklerSetup");
    Serial.println("          Password : sprinkler123");
    Serial.println("");
    Serial.println("  STEP 2: A login page will open automatically.");
    Serial.println("          If it does not, open your browser");
    Serial.println("          and go to: http://192.168.4.1");
    Serial.println("");
    Serial.println("  STEP 3: On that page, enter your HOME WiFi");
    Serial.println("          network name and password, then tap Save.");
    Serial.println("");
    Serial.println("  Waiting for you to complete setup...");
    Serial.println("================================================");
    Serial.println("");
  }

  WiFiManager wm;
  wm.setDebugOutput(false);
  wm.setConfigPortalTimeout(0); // 0 = no timeout, portal stays open indefinitely

  bool connected = wm.autoConnect(AP_NAME, AP_PASSWORD);

  if (connected) {
    if (MDNS.begin(HOSTNAME)) {
      MDNS.addService("http", "tcp", 80);
    }
    Serial.println("");
    Serial.println("================================================");
    Serial.println("  SUCCESS — Board is on your home network!");
    Serial.println("================================================");
    Serial.println("");
    Serial.println("  STEP 4: On your phone go to Settings > WiFi");
    Serial.printf( "          and reconnect to your home network.\n");
    Serial.println("");
    Serial.println("  STEP 5: Open your browser and go to:");
    Serial.println("          http://sprinkler.local");
    Serial.println("");
    Serial.println("  If sprinkler.local does not load, try:");
    Serial.printf( "          http://%s\n", WiFi.localIP().toString().c_str());
    Serial.println("");
    Serial.println("  STEP 6: The SprinKlr-8 dashboard will open.");
    Serial.println("          Bookmark it for easy access next time.");
    Serial.println("");
    Serial.println("================================================");
    Serial.println("");
  } else {
    Serial.println("[WIFI] Portal timed out, running in offline mode");
  }
}

// ═══════════════════════════════════════════════════════════════
//  STATUS LED BLINK TASK
// ═══════════════════════════════════════════════════════════════
void ledTask(void* param) {
  while (true) {
    xSemaphoreTake(statusMutex, portMAX_DELAY);
    bool running = runStatus.isRunning;
    xSemaphoreGive(statusMutex);

    if (running) {
      // Fast blink when running
      digitalWrite(STATUS_LED_PIN, HIGH);
      vTaskDelay(pdMS_TO_TICKS(200));
      digitalWrite(STATUS_LED_PIN, LOW);
      vTaskDelay(pdMS_TO_TICKS(200));
    } else {
      // Slow heartbeat when idle
      digitalWrite(STATUS_LED_PIN, HIGH);
      vTaskDelay(pdMS_TO_TICKS(100));
      digitalWrite(STATUS_LED_PIN, LOW);
      vTaskDelay(pdMS_TO_TICKS(2900));
    }
  }
}


// ═══════════════════════════════════════════════════════════════
//  SETUP
// ═══════════════════════════════════════════════════════════════
void setup() {
  Serial.begin(115200);
  delay(100);                 // short settle — Improv must start ASAP
  Serial.println("\n[BOOT] ESP32 Sprinkler Controller starting...");

  // Mutexes
  statusMutex   = xSemaphoreCreateMutex();
  scheduleMutex = xSemaphoreCreateMutex();
  weatherMutex  = xSemaphoreCreateMutex();

  // GPIO — LED first so checkWiFiReset() can blink it
  pinMode(STATUS_LED_PIN, OUTPUT);
  setupRelayPins();
  Serial.println("[BOOT] Relay pins configured, all OFF");

  // LittleFS — mount BEFORE WiFi init to avoid flash access conflicts
  if (!LittleFS.begin(true)) {
    Serial.println("[BOOT] LittleFS mount failed — formatting...");
    LittleFS.format();
    LittleFS.begin(true);
  }
  Serial.println("[BOOT] LittleFS OK");

  // Load schedule and board config
  loadSchedule();
  loadConfig();

  // WiFi reset — hold IO0 for 3 s at boot to wipe saved credentials
  // (lets user re-configure if they change routers or move house)
  checkWiFiReset();

  // WiFi (fallback / normal connect after Improv or on subsequent boots)
  setupWiFi();

  // NTP — configTime() internally sets TZ to UTC, so we call applyTimezone() AFTER it
  configTime(0, 0, NTP_SERVER);   // sync NTP first (sets TZ to UTC internally)
  applyTimezone();                 // re-apply saved POSIX TZ so it persists across reboots
  Serial.println("[BOOT] Waiting for NTP sync...");
  {
    int retries = 0;
    while (!isNtpSynced() && retries++ < 20) { delay(500); }
  }
  if (isNtpSynced()) {
    time_t now = time(nullptr);
    Serial.printf("[BOOT] NTP synced: %s", ctime(&now));
  } else {
    Serial.println("[BOOT] NTP sync timed out — will retry in background");
  }

  // OTA firmware updates (Arduino IDE over WiFi)
  setupOTA();

  // Web server
  setupRoutes();
  setupCloudUpdateRoutes();
  setupUploadRoutes();
  server.begin();
  Serial.println("[BOOT] Web server started on port 80");
  Serial.printf("[BOOT] Access UI at:     http://%s/\n", WiFi.localIP().toString().c_str());
  Serial.printf("[BOOT] Upload new UI at: http://%s/upload\n", WiFi.localIP().toString().c_str());

  // Background tasks
  xTaskCreate(scheduleCheckerTask, "sched_check", 4096, NULL, 1, NULL);
  xTaskCreate(ledTask,             "led_blink",   1024, NULL, 1, NULL);
  xTaskCreate(weatherTask,         "weather",     8192, NULL, 1, &weatherTaskHandle);
  xTaskCreate(telegramTask,        "telegram",    8192, NULL, 1, &telegramTaskHandle);

  Serial.println("[BOOT] All systems GO");
}

// ═══════════════════════════════════════════════════════════════
//  LOOP (real work is in FreeRTOS tasks and web server callbacks)
// ═══════════════════════════════════════════════════════════════
void loop() {
  ArduinoOTA.handle();
  server.handleClient();
  delay(10);
}
