John-High-Sierra/sprinkler.board/(commit log)

2026-04-19 Initial commit — ESP32 sprinkler controller REV20.1
    Working firmware on ESP32 core 3.3.8 using WebServer.h (migrated
    from ESPAsyncWebServer). Includes mobile-first web UI, FreeRTOS
    zone sequencing, WiFi reset via IO0 button, and LittleFS serving.
    [sprinkler_case.scad]
2026-04-19 Added OTA updates from GIT and WIFI Reset via IO0
    [sprinkler_controller.ino]
2026-04-19 Add cloud OTA updates — firmware and UI from GitHub
    Firmware: resolves GitHub redirect chain to objects.githubusercontent.com
    then flashes via httpUpdate. UI: downloads index.html from raw GitHub URL
    and writes to LittleFS. Both triggered from Settings page in the web UI.
    [sprinkler_controller.ino]
2026-04-25 Add hardware/ directory scaffold for custom PCB development
2026-04-25 Add SprinKlr-8 business plan (Lean Canvas framework)
2026-04-25 Fix HA integration: async aiohttp, guard turn_off, device_info, render_readme
2026-04-26 Revise design spec v1.1: dual-supply power, single terminal strip, replaceable fuse
2026-04-26 Remove business docs — moved to private business repo
2026-04-26 Update PCB Design Guide to v1.1: dual-supply power circuit, single terminal strip, replaceable fuse
2026-04-26 Align component lists: add missing parts to Spec and Guide BOMs
    Design Spec was missing T1/T2 (MMBT3904), R17-R21 (10k x5),
    R22-R23 (5.1k x2), R24 (1k). Design Guide placement table was
    missing C1, C2, C3-C6, R1-R8, R9-R16, D1-D8, D9.
    Both documents now share the same 29-component master BOM.
2026-04-26 Fix D10 LCSC part number (C94085 -> C2491 MB10F) and add JLCPCB BOM CSV
    [SprinKlr8_BOM_JLCPCB.csv]
2026-04-28 Correct LCSC part numbers; switch to SMD electrolytics; split J2 into 3P+8P
    Verified-wrong C-numbers replaced:
    L1 100uH inductor C408444 -> C2929505 (CYH127-100UH)
    C1 470uF 50V SMD elec C176680 -> C90272 (RVT1H471M1213)
    C2 220uF SMD elec C176672 -> C4747974 (RST220UF25V019, 25V)
    F1 5x20mm fuse holder C2897491 -> C3131 (BLX-A XC-7)
    U5 LM2596S-5.0 C347553 -> C347421 (UMW)
    J2 11P 5.08mm terminal C8463 -> J2A C2915640 (3P) + J2B C5143711 (8P)
    C1 and C2 are now SMD aluminum electrolytics (was through-hole).
    [SprinKlr8_BOM_JLCPCB.csv]
2026-04-28 Subdivide BOM into 5 functional blocks (Power, MCU, USB, Zone Driver, LEDs)
    Design Guide: replaced the flat placement table with 5 sub-tables,
    each preceded by a Heading 3. Adds a Designator column.
    CSV: prepended a Block column; rows ordered by block.
    [SprinKlr8_BOM_JLCPCB.csv]
2026-04-30 C2: switch to in-stock equivalent (KNSCHA XT220UF25V90RV0075, C2992606)
    Same 220uF 25V D6.3xL7.7mm SMD package; C4747974 was out of stock.
    [SprinKlr8_BOM_JLCPCB.csv]
2026-04-30 D12: fix SS14 part number and footprint (C2837435 invalid -> C2480, SOD-123 -> SMA)
    SS14 1A 40V Schottky is in SMA (DO-214AC) package, not SOD-123.
    C2480 is the JLCPCB basic-part SS14.
    [SprinKlr8_BOM_JLCPCB.csv]
2026-05-03 Firmware: timezone config, schedule save fix, mDNS; UI: font scaling, tz picker
    [sprinkler_controller.ino]
2026-05-09 Improv heartbeat fix: re-send AUTHORIZED every 1s for reliable browser detection
    Re-sends STATE_AUTHORIZED every 1 second during the provisioning window so
    the browser catches it even if it missed the first packet while re-establishing
    the serial connection. Binary updated to match.
    [sprinkler_controller.ino]
2026-05-10 Setup page: add serial monitor + fix LittleFS init order
    [sprinkler_controller.ino]
2026-05-10 Bundle LittleFS web UI in flash — no manual upload needed after install
2026-05-17 Update firmware binary v1.2.0 — Improv removed, guided WiFi setup messages
2026-05-17 v1.3.0: Improv WiFi browser dialog + boot loop fix
    [sprinkler_controller.ino]
2026-05-29 Remove UI cloud update — HTML is embedded in firmware, UI-only update had no effect
2026-05-29 Fix partition scheme: Minimal SPIFFS (1.9MB APP with OTA) — firmware is 1.28MB, too large for Default 4MB scheme
    [sprinkler_controller.ino]
2026-05-29 v1.4.2: remove UI cloud update, fix partition scheme to Minimal SPIFFS for OTA
    [sprinkler_controller.ino]
2026-05-29 Add lat/lon and weather skip settings to BoardConfig and config API
    [sprinkler_controller.ino]
2026-05-29 Fix loadConfig: log JSON parse errors, consistent error handling style
    [sprinkler_controller.ino]
2026-05-29 Fix fetchWeather: increase JsonDocument to 2048 to handle long timezone names
    [sprinkler_controller.ino]
2026-05-29 Add weather skip logic — skip scheduled runs on rain forecast or freeze risk
    [sprinkler_controller.ino]
2026-05-29 v1.5.0: weather display and weather skip (Open-Meteo, no API key)
    [sprinkler_controller.ino]
2026-05-29 Add cycleAndSoakEnabled and cycleTime to BoardConfig and config API
2026-05-29 Fix runSequenceTask: reset manualRun on teardown
    [sprinkler_controller.ino]
2026-05-29 v1.5.1: Cycle and Soak UI — configurable cycle time, soaking banner state
2026-05-29 Fix fetchWeather: use getString() instead of getStream() for reliable HTTPS parsing on ESP32
    [sprinkler_controller.ino]
2026-05-31 Add temp_unit to BoardConfig and weatherTaskHandle for notify-on-location-change
2026-05-31 UI: fmtTemp helper, degrees F/C-aware temperature displays and freeze threshold
2026-05-31 v1.6.0: degrees F/C toggle, 5-day forecast strip, location refresh without reset
    [sprinkler_controller.ino]
2026-06-01 Spec: add zone names to board config, snapshot names in run log
2026-06-01 Add zoneNames to BoardConfig and wire through config API
2026-06-01 Wire appendRunLog into run tasks and weather skip
    [sprinkler_controller.ino]
2026-06-01 Migrate zone names from localStorage to board config
2026-06-02 v1.7.0: run history, zone names on board
2026-06-04 Embed PWA files in firmware PROGMEM — no LittleFS flash needed for PWA
2026-06-06 v1.9.0: 4 schedules, ET scaling, zone overlap, Telegram expansion, timezone + WiFi fixes
    - Timezone fix: swap configTime/applyTimezone order so TZ persists across reboot
    - WiFi settings row: now shows SSID + RSSI dBm
    - Zone overlap: next zone turns on 2s early in sequential mode to prevent water hammer
    - 4 named schedules: replace 7-day model with 4 independent schedules, each with
    name, enabled toggle, day-of-week checkboxes, start time, and per-zone durations
    - ET0 scaling: fetch et0_fao_evapotranspiration from Open-Meteo; multiply zone
    durations by ET0/baseline ratio (capped 50-200%) when enabled
    - Telegram: /schedule 1-4, /schedules, /weather, /next, /log, /zones, /pause, /resume
    - d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
    [sprinkler_controller.ino]
2026-06-06 Fix remaining runStatus.dayIndex reference in runSingleZoneTask
    [sprinkler_controller.ino]
